dustin-lehmann/TWIPR/README.md

# TWIPR

See https://github.com/dustin-lehmann/TWIPR/wiki for descriptions on how to use the hardware and software
