dustin-lehmann/TWIPR/material/electronics/tools/robot-control_calculator.xlsx

Sheet: PWM Buzzer
PWM Calculator
Base Frequency | 16000000
Prescaler | 3
ARR | 40000 | 9089.91
PWM Frequency | 100.00 | 440

Sheet: WS2812
WS2812b Timer
Base Frequency | 16000000
ARR= | 20.00
30% Duty= | 6
70% Duty= | 14

Sheet: RegisterMap BoardExtender
Address | Name | R/W | Default | Column1 | Description
0x00
0x01
0x02
0x03
0x04
0x05 | COMMAND
0x06
0x07
0x08
0x09
0x0A
0x0B | CM4_MODE | R/W
0x0C | CM4_ENABLE | R/W | 0x00 |  | 0: disable CM4, 1: enable CM4
0x0D | OUT_5V_ENABLE | R/W
0x0E | DETECT_SD | R |  |  | 0: SD card not detected, 1: SD card present
0x0F | DETECT_USB | R |  |  | 0: USB not connected, 1: USB connected
0x10 | BUTTON_INTERN | R
0x11 | BUTTON_EXTERN | R
0x12 | V_POWER_0
0x13 | V_POWER_1
0x14 | V_POWER_2
0x15 | V_POWER_3
0x16 | V_REG_0
0x17 | V_REG_1
0x18 | V_REG_2
0x19 | V_REG_3
0x1A
0x1B
0x1C | ERROR_LED_CONFIG | R/W | 0x00 |  | 0: continious, 1: blinking
0x1D | ERROR_LED_DATA | R/W | 0x00 |  | 0: off, 1: on
0x1E | ERROR_LED_BLINKING_TIME | R/W | 0x00 |  | Value x 10ms = Actual blink time
0x1F | ERROR_LED_BLINK_COUNTER | R/W | 0x00 |  | Value = number of blink intervals
0x20 | STATUS_RGB_LED_1_CONFIG | R/W | 0x00 |  | Bits: 7 (power): 0=off, 1=on 6:5 (mode): 0=continiuous, 1=blinking, 2= fading, 3=reserved 4:3 (blink mode): 0=continiuous, 1=countdown, 2= reserved, 3=reserved 2:0 : reserved
0x21 | STATUS_RGB_LED_1_RED | R/W | 0x00 |  | 0x00: Lowest intensity 0xFF: Highest intensity
0x22 | STATUS_RGB_LED_1_GREEN | R/W | 0x00 |  | 0x00: Lowest intensity 0xFF: Highest intensity
0x23 | STATUS_RGB_LED_1_BLUE | R/W | 0x00 |  | 0x00: Lowest intensity 0xFF: Highest intensity
0x24 | STATUS_RGB_LED_1_BLINK_TIME | R/W | 0x00 |  | Value x 10ms = Actual blink time
0x25 | STATUS_RGB_LED_1_BLINK_COUNTER | R/W | 0x00 |  | Value = number of blink intervals
0x26 | STATUS_RGB_LED_2_CONFIG | R/W | 0x00 |  | Bits: 7 (power): 0=off, 1=on 6:5 (mode): 0=continiuous, 1=blinking, 2= fading, 3=reserved 4:3 (blink mode): 0=continiuous, 1=countdown, 2= reserved, 3=reserved 2:0 : reserved
0x27 | STATUS_RGB_LED_2_RED | R/W | 0x00 |  | 0x00: Lowest intensity 0xFF: Highest intensity
0x28 | STATUS_RGB_LED_2_GREEN | R/W | 0x00 |  | 0x00: Lowest intensity 0xFF: Highest intensity
0x29 | STATUS_RGB_LED_2_BLUE | R/W | 0x00 |  | 0x00: Lowest intensity 0xFF: Highest intensity
0x2A | STATUS_RGB_LED_2_BLINK_TIME | R/W | 0x00 |  | Value x 10ms = Actual blink time
0x2B | STATUS_RGB_LED_2_BLINK_COUNTER | R/W | 0x00 |  | Value = number of blink intervals
0x2C | STATUS_RGB_LED_3_CONFIG | R/W | 0x00 |  | Bits: 7 (power): 0=off, 1=on 6:5 (mode): 0=continiuous, 1=blinking, 2= fading, 3=reserved 4:3 (blink mode): 0=continiuous, 1=countdown, 2= reserved, 3=reserved 2:0 : reserved
0x2D | STATUS_RGB_LED_3_RED | R/W | 0x00 |  | 0x00: Lowest intensity 0xFF: Highest intensity
0x2E | STATUS_RGB_LED_3_GREEN | R/W | 0x00 |  | 0x00: Lowest intensity 0xFF: Highest intensity
0x2F | STATUS_RGB_LED_3_BLUE | R/W | 0x00 |  | 0x00: Lowest intensity 0xFF: Highest intensity
0x30 | STATUS_RGB_LED_3_BLINK_TIME | R/W | 0x00 |  | Value x 10ms = Actual blink time
0x31 | STATUS_RGB_LED_3_BLINK_COUNTER | R/W | 0x00 |  | Value = number of blink intervals
0x32
0x33 | BUZZER_CONFIG | R/W |  |  | Bits: 7 (enable): 0=disabled, 1=enabled 6:5 (mode): 0=continious, 1=timer, 2=blinking, 3=reserved
0x34 | BUZZER_DATA | R/W |  |  | 0=off, 1=on
0x35 | BUZZER_FREQUENCY | R/W |  |  | value x 10 = frequency in Hz
0x36 | BUZZER_TIMER | R/W |  |  | value x 10
0x37 | BUZZER_BLINK_TIME | R/W
0x38 | BUZZER_BLINK_COUNTER | R/W
0x39
0x3A
0x3B
0x3C
0x3D
0x3E
0x3F
0x40 | EXTERNAL_RGB_CONFIG | R/W |  |  | Bits: 7 (power): 0= off, 1=on 6 (individual mode): 0=global, 1=individual 5:4 (global mode): 0=continiuous, 1=blinking, 2= fading, 3=reserved 3:2 (blink mode): : 0=continiuous, 1=countdown, 2= reserved, 3=reserved
0x41 | EXTERNAL_RGB_GLOBAL_RED | R/W
0x42 | EXTERNAL_RGB_GLOBAL_GREEN | R/W
0x43 | EXTERNAL_RGB_GLOBAL_BLUE | R/W
0x44 | EXTERNAL_RGB_GLOBAL_BLINK_TIME | R/W
0x45 | EXTERNAL_RGB_GLOBAL_BLINK_COUNTER | R/W
0x46 | EXTERNAL_RGB_LED_1_CONFIG | R/W | 0x00 |  | Bits: 7 (power): 0=off, 1=on 6:5 (mode): 0=continiuous, 1=blinking, 2= fading, 3=reserved 4:3 (blink mode): 0=continiuous, 1=countdown, 2= reserved, 3=reserved 2:0 : reserved
0x47 | EXTERNAL_RGB_LED_1_RED | R/W | 0x00 |  | 0x00: Lowest intensity 0xFF: Highest intensity
0x48 | EXTERNAL_RGB_LED_1_GREEN | R/W | 0x00 |  | 0x00: Lowest intensity 0xFF: Highest intensity
0x49 | EXTERNAL_RGB_LED_1_BLUE | R/W | 0x00 |  | 0x00: Lowest intensity 0xFF: Highest intensity
0x4A | EXTERNAL_RGB_LED_1_BLINK_TIME | R/W | 0x00 |  | Value x 10ms = Actual blink time
0x4B | EXTERNAL_RGB_LED_1_BLINK_COUNTER | R/W | 0x00 |  | Value = number of blink intervals
0x4C | EXTERNAL_RGB_LED_2_CONFIG | R/W | 0x00 |  | Bits: 7 (power): 0=off, 1=on 6:5 (mode): 0=continiuous, 1=blinking, 2= fading, 3=reserved 4:3 (blink mode): 0=continiuous, 1=countdown, 2= reserved, 3=reserved 2:0 : reserved
0x4D | EXTERNAL_RGB_LED_2_RED | R/W | 0x00 |  | 0x00: Lowest intensity 0xFF: Highest intensity
0x4E | EXTERNAL_RGB_LED_2_GREEN | R/W | 0x00 |  | 0x00: Lowest intensity 0xFF: Highest intensity
0x4F | EXTERNAL_RGB_LED_2_BLUE | R/W | 0x00 |  | 0x00: Lowest intensity 0xFF: Highest intensity
0x50 | EXTERNAL_RGB_LED_2_BLINK_TIME | R/W | 0x00 |  | Value x 10ms = Actual blink time
0x51 | EXTERNAL_RGB_LED_2_BLINK_COUNTER | R/W | 0x00 |  | Value = number of blink intervals
0x52 | EXTERNAL_RGB_LED_3_CONFIG | R/W | 0x00 |  | Bits: 7 (power): 0=off, 1=on 6:5 (mode): 0=continiuous, 1=blinking, 2= fading, 3=reserved 4:3 (blink mode): 0=continiuous, 1=countdown, 2= reserved, 3=reserved 2:0 : reserved
0x53 | EXTERNAL_RGB_LED_3_RED | R/W | 0x00 |  | 0x00: Lowest intensity 0xFF: Highest intensity
0x54 | EXTERNAL_RGB_LED_3_GREEN | R/W | 0x00 |  | 0x00: Lowest intensity 0xFF: Highest intensity
0x55 | EXTERNAL_RGB_LED_3_BLUE | R/W | 0x00 |  | 0x00: Lowest intensity 0xFF: Highest intensity
0x56 | EXTERNAL_RGB_LED_3_BLINK_TIME | R/W | 0x00 |  | Value x 10ms = Actual blink time
0x57 | EXTERNAL_RGB_LED_3_BLINK_COUNTER | R/W | 0x00 |  | Value = number of blink intervals
0x58 | EXTERNAL_RGB_LED_4_CONFIG | R/W | 0x00 |  | Bits: 7 (power): 0=off, 1=on 6:5 (mode): 0=continiuous, 1=blinking, 2= fading, 3=reserved 4:3 (blink mode): 0=continiuous, 1=countdown, 2= reserved, 3=reserved 2:0 : reserved
0x59 | EXTERNAL_RGB_LED_4_RED | R/W | 0x00 |  | 0x00: Lowest intensity 0xFF: Highest intensity
0x5A | EXTERNAL_RGB_LED_4_GREEN | R/W | 0x00 |  | 0x00: Lowest intensity 0xFF: Highest intensity
0x5B | EXTERNAL_RGB_LED_4_BLUE | R/W | 0x00 |  | 0x00: Lowest intensity 0xFF: Highest intensity
0x5C | EXTERNAL_RGB_LED_4_BLINK_TIME | R/W | 0x00 |  | Value x 10ms = Actual blink time
0x5D | EXTERNAL_RGB_LED_4_BLINK_COUNTER | R/W | 0x00 |  | Value = number of blink intervals
0x5E | EXTERNAL_RGB_LED_5_CONFIG | R/W | 0x00 |  | Bits: 7 (power): 0=off, 1=on 6:5 (mode): 0=continiuous, 1=blinking, 2= fading, 3=reserved 4:3 (blink mode): 0=continiuous, 1=countdown, 2= reserved, 3=reserved 2:0 : reserved
0x5F | EXTERNAL_RGB_LED_5_RED | R/W | 0x00 |  | 0x00: Lowest intensity 0xFF: Highest intensity
0x60 | EXTERNAL_RGB_LED_5_GREEN | R/W | 0x00 |  | 0x00: Lowest intensity 0xFF: Highest intensity
0x61 | EXTERNAL_RGB_LED_5_BLUE | R/W | 0x00 |  | 0x00: Lowest intensity 0xFF: Highest intensity
0x62 | EXTERNAL_RGB_LED_5_BLINK_TIME | R/W | 0x00 |  | Value x 10ms = Actual blink time
0x63 | EXTERNAL_RGB_LED_5_BLINK_COUNTER | R/W | 0x00 |  | Value = number of blink intervals
0x64 | EXTERNAL_RGB_LED_6_CONFIG | R/W | 0x00 |  | Bits: 7 (power): 0=off, 1=on 6:5 (mode): 0=continiuous, 1=blinking, 2= fading, 3=reserved 4:3 (blink mode): 0=continiuous, 1=countdown, 2= reserved, 3=reserved 2:0 : reserved
0x65 | EXTERNAL_RGB_LED_6_RED | R/W | 0x00 |  | 0x00: Lowest intensity 0xFF: Highest intensity
0x66 | EXTERNAL_RGB_LED_6_GREEN | R/W | 0x00 |  | 0x00: Lowest intensity 0xFF: Highest intensity
0x67 | EXTERNAL_RGB_LED_6_BLUE | R/W | 0x00 |  | 0x00: Lowest intensity 0xFF: Highest intensity
0x68 | EXTERNAL_RGB_LED_6_BLINK_TIME | R/W | 0x00 |  | Value x 10ms = Actual blink time
0x69 | EXTERNAL_RGB_LED_6_BLINK_COUNTER | R/W | 0x00 |  | Value = number of blink intervals
0x6A | EXTERNAL_RGB_LED_7_CONFIG | R/W | 0x00 |  | Bits: 7 (power): 0=off, 1=on 6:5 (mode): 0=continiuous, 1=blinking, 2= fading, 3=reserved 4:3 (blink mode): 0=continiuous, 1=countdown, 2= reserved, 3=reserved 2:0 : reserved
0x6B | EXTERNAL_RGB_LED_7_RED | R/W | 0x00 |  | 0x00: Lowest intensity 0xFF: Highest intensity
0x6C | EXTERNAL_RGB_LED_7_GREEN | R/W | 0x00 |  | 0x00: Lowest intensity 0xFF: Highest intensity
0x6D | EXTERNAL_RGB_LED_7_BLUE | R/W | 0x00 |  | 0x00: Lowest intensity 0xFF: Highest intensity
0x6E | EXTERNAL_RGB_LED_7_BLINK_TIME | R/W | 0x00 |  | Value x 10ms = Actual blink time
0x6F | EXTERNAL_RGB_LED_7_BLINK_COUNTER | R/W | 0x00 |  | Value = number of blink intervals
0x70 | EXTERNAL_RGB_LED_8_CONFIG | R/W | 0x00 |  | Bits: 7 (power): 0=off, 1=on 6:5 (mode): 0=continiuous, 1=blinking, 2= fading, 3=reserved 4:3 (blink mode): 0=continiuous, 1=countdown, 2= reserved, 3=reserved 2:0 : reserved
0x71 | EXTERNAL_RGB_LED_8_RED | R/W | 0x00 |  | 0x00: Lowest intensity 0xFF: Highest intensity
0x72 | EXTERNAL_RGB_LED_8_GREEN | R/W | 0x00 |  | 0x00: Lowest intensity 0xFF: Highest intensity
0x73 | EXTERNAL_RGB_LED_8_BLUE | R/W | 0x00 |  | 0x00: Lowest intensity 0xFF: Highest intensity
0x74 | EXTERNAL_RGB_LED_8_BLINK_TIME | R/W | 0x00 |  | Value x 10ms = Actual blink time
0x75 | EXTERNAL_RGB_LED_8_BLINK_COUNTER | R/W | 0x00 |  | Value = number of blink intervals
0x76 | EXTERNAL_RGB_LED_9_CONFIG | R/W | 0x00 |  | Bits: 7 (power): 0=off, 1=on 6:5 (mode): 0=continiuous, 1=blinking, 2= fading, 3=reserved 4:3 (blink mode): 0=continiuous, 1=countdown, 2= reserved, 3=reserved 2:0 : reserved
0x77 | EXTERNAL_RGB_LED_9_RED | R/W | 0x00 |  | 0x00: Lowest intensity 0xFF: Highest intensity
0x78 | EXTERNAL_RGB_LED_9_GREEN | R/W | 0x00 |  | 0x00: Lowest intensity 0xFF: Highest intensity
0x79 | EXTERNAL_RGB_LED_9_BLUE | R/W | 0x00 |  | 0x00: Lowest intensity 0xFF: Highest intensity
0x7A | EXTERNAL_RGB_LED_9_BLINK_TIME | R/W | 0x00 |  | Value x 10ms = Actual blink time
0x7B | EXTERNAL_RGB_LED_9_BLINK_COUNTER | R/W | 0x00 |  | Value = number of blink intervals
0x7C | EXTERNAL_RGB_LED_10_CONFIG | R/W | 0x00 |  | Bits: 7 (power): 0=off, 1=on 6:5 (mode): 0=continiuous, 1=blinking, 2= fading, 3=reserved 4:3 (blink mode): 0=continiuous, 1=countdown, 2= reserved, 3=reserved 2:0 : reserved
0x7D | EXTERNAL_RGB_LED_10_RED | R/W | 0x00 |  | 0x00: Lowest intensity 0xFF: Highest intensity
0x7E | EXTERNAL_RGB_LED_10_GREEN | R/W | 0x00 |  | 0x00: Lowest intensity 0xFF: Highest intensity
0x7F | EXTERNAL_RGB_LED_10_BLUE | R/W | 0x00 |  | 0x00: Lowest intensity 0xFF: Highest intensity
0x80 | EXTERNAL_RGB_LED_10_BLINK_TIME | R/W | 0x00 |  | Value x 10ms = Actual blink time
0x81 | EXTERNAL_RGB_LED_10_BLINK_COUNTER | R/W | 0x00 |  | Value = number of blink intervals
0x82 | EXTERNAL_RGB_LED_11_CONFIG | R/W | 0x00 |  | Bits: 7 (power): 0=off, 1=on 6:5 (mode): 0=continiuous, 1=blinking, 2= fading, 3=reserved 4:3 (blink mode): 0=continiuous, 1=countdown, 2= reserved, 3=reserved 2:0 : reserved
0x83 | EXTERNAL_RGB_LED_11_RED | R/W | 0x00 |  | 0x00: Lowest intensity 0xFF: Highest intensity
0x84 | EXTERNAL_RGB_LED_11_GREEN | R/W | 0x00 |  | 0x00: Lowest intensity 0xFF: Highest intensity
0x85 | EXTERNAL_RGB_LED_11_BLUE | R/W | 0x00 |  | 0x00: Lowest intensity 0xFF: Highest intensity
0x86 | EXTERNAL_RGB_LED_11_BLINK_TIME | R/W | 0x00 |  | Value x 10ms = Actual blink time
0x87 | EXTERNAL_RGB_LED_11_BLINK_COUNTER | R/W | 0x00 |  | Value = number of blink intervals
0x88 | EXTERNAL_RGB_LED_12_CONFIG | R/W | 0x00 |  | Bits: 7 (power): 0=off, 1=on 6:5 (mode): 0=continiuous, 1=blinking, 2= fading, 3=reserved 4:3 (blink mode): 0=continiuous, 1=countdown, 2= reserved, 3=reserved 2:0 : reserved
0x89 | EXTERNAL_RGB_LED_12_RED | R/W | 0x00 |  | 0x00: Lowest intensity 0xFF: Highest intensity
0x8A | EXTERNAL_RGB_LED_12_GREEN | R/W | 0x00 |  | 0x00: Lowest intensity 0xFF: Highest intensity
0x8B | EXTERNAL_RGB_LED_12_BLUE | R/W | 0x00 |  | 0x00: Lowest intensity 0xFF: Highest intensity
0x8C | EXTERNAL_RGB_LED_12_BLINK_TIME | R/W | 0x00 |  | Value x 10ms = Actual blink time
0x8D | EXTERNAL_RGB_LED_12_BLINK_COUNTER | R/W | 0x00 |  | Value = number of blink intervals
0x8E | EXTERNAL_RGB_LED_13_CONFIG | R/W | 0x00 |  | Bits: 7 (power): 0=off, 1=on 6:5 (mode): 0=continiuous, 1=blinking, 2= fading, 3=reserved 4:3 (blink mode): 0=continiuous, 1=countdown, 2= reserved, 3=reserved 2:0 : reserved
0x8F | EXTERNAL_RGB_LED_13_RED | R/W | 0x00 |  | 0x00: Lowest intensity 0xFF: Highest intensity
0x90 | EXTERNAL_RGB_LED_13_GREEN | R/W | 0x00 |  | 0x00: Lowest intensity 0xFF: Highest intensity
0x91 | EXTERNAL_RGB_LED_13_BLUE | R/W | 0x00 |  | 0x00: Lowest intensity 0xFF: Highest intensity
0x92 | EXTERNAL_RGB_LED_13_BLINK_TIME | R/W | 0x00 |  | Value x 10ms = Actual blink time
0x93 | EXTERNAL_RGB_LED_13_BLINK_COUNTER | R/W | 0x00 |  | Value = number of blink intervals
0x94 | EXTERNAL_RGB_LED_14_CONFIG | R/W | 0x00 |  | Bits: 7 (power): 0=off, 1=on 6:5 (mode): 0=continiuous, 1=blinking, 2= fading, 3=reserved 4:3 (blink mode): 0=continiuous, 1=countdown, 2= reserved, 3=reserved 2:0 : reserved
0x95 | EXTERNAL_RGB_LED_14_RED | R/W | 0x00 |  | 0x00: Lowest intensity 0xFF: Highest intensity
0x96 | EXTERNAL_RGB_LED_14_GREEN | R/W | 0x00 |  | 0x00: Lowest intensity 0xFF: Highest intensity
0x97 | EXTERNAL_RGB_LED_14_BLUE | R/W | 0x00 |  | 0x00: Lowest intensity 0xFF: Highest intensity
0x98 | EXTERNAL_RGB_LED_14_BLINK_TIME | R/W | 0x00 |  | Value x 10ms = Actual blink time
0x99 | EXTERNAL_RGB_LED_14_BLINK_COUNTER | R/W | 0x00 |  | Value = number of blink intervals
0x9A | EXTERNAL_RGB_LED_15_CONFIG | R/W | 0x00 |  | Bits: 7 (power): 0=off, 1=on 6:5 (mode): 0=continiuous, 1=blinking, 2= fading, 3=reserved 4:3 (blink mode): 0=continiuous, 1=countdown, 2= reserved, 3=reserved 2:0 : reserved
0x9B | EXTERNAL_RGB_LED_15_RED | R/W | 0x00 |  | 0x00: Lowest intensity 0xFF: Highest intensity
0x9C | EXTERNAL_RGB_LED_15_GREEN | R/W | 0x00 |  | 0x00: Lowest intensity 0xFF: Highest intensity
0x9D | EXTERNAL_RGB_LED_15_BLUE | R/W | 0x00 |  | 0x00: Lowest intensity 0xFF: Highest intensity
0x9E | EXTERNAL_RGB_LED_15_BLINK_TIME | R/W | 0x00 |  | Value x 10ms = Actual blink time
0x9F | EXTERNAL_RGB_LED_15_BLINK_COUNTER | R/W | 0x00 |  | Value = number of blink intervals
0xA0 | EXTERNAL_RGB_LED_16_CONFIG | R/W | 0x00 |  | Bits: 7 (power): 0=off, 1=on 6:5 (mode): 0=continiuous, 1=blinking, 2= fading, 3=reserved 4:3 (blink mode): 0=continiuous, 1=countdown, 2= reserved, 3=reserved 2:0 : reserved
0xA1 | EXTERNAL_RGB_LED_16_RED | R/W | 0x00 |  | 0x00: Lowest intensity 0xFF: Highest intensity
0xA2 | EXTERNAL_RGB_LED_16_GREEN | R/W | 0x00 |  | 0x00: Lowest intensity 0xFF: Highest intensity
0xA3 | EXTERNAL_RGB_LED_16_BLUE | R/W | 0x00 |  | 0x00: Lowest intensity 0xFF: Highest intensity
0xA4 | EXTERNAL_RGB_LED_16_BLINK_TIME | R/W | 0x00 |  | Value x 10ms = Actual blink time
0xA5 | EXTERNAL_RGB_LED_16_BLINK_COUNTER | R/W | 0x00 |  | Value = number of blink intervals
0xA6
0xA7
0xA8
0xA9
0xAA
0xAB
0xAC
0xAD
0xAE
0xAF
0xB0
0xB1
0xB2
0xB3
0xB4
0xB5
0xB6
0xB7
0xB8
0xB9
0xBA
0xBB

Sheet: S-8254AA
Maximum Current | 25
VIOV1 | 0.1
R_SENSE | 0.004
Power for Resistor | 2.5

Sheet: Sheet1
Code | Error
0 | 0
1 | 1
2 | 0
3 | 1
4 | 0
5 | 0
6 | 0
7 | 1
8 | 0
9 | 1
10 | 0
11 | 1
12 | 0
13 | 0
14 | 0
15 | 1
16 | 0
17 | 1
18 | 0
19 | 1
20 | 0
21 | 1
22 | 0
23 | 1
24 | 0
25 | 1
26 | 0
27 | 1
28 | 0
29 | 0
30 | 0
31 | 1
32 | 0
33 | 1
34 | 0
35 | 1
36 | 0
37 | 0
38 | 0
39 | 1
40 | 0
41 | 1
42
43
44
45
46
47
48
49
50
51
52
53
54
55
56
57
58
59
60
61
62
63
64
65
66
67
68
69
70
71
72
73
74
75
76
77
78
79
80
81
82
83
84
85
86
87
88
89
90
91
92
93
94
95
96
97
98
99
100
