dustin-lehmann/TWIPR/software/host/RobotManager/extensions/babylon/babylon_lib/models/diff_drive_robot/design/robot_base.SLDASM

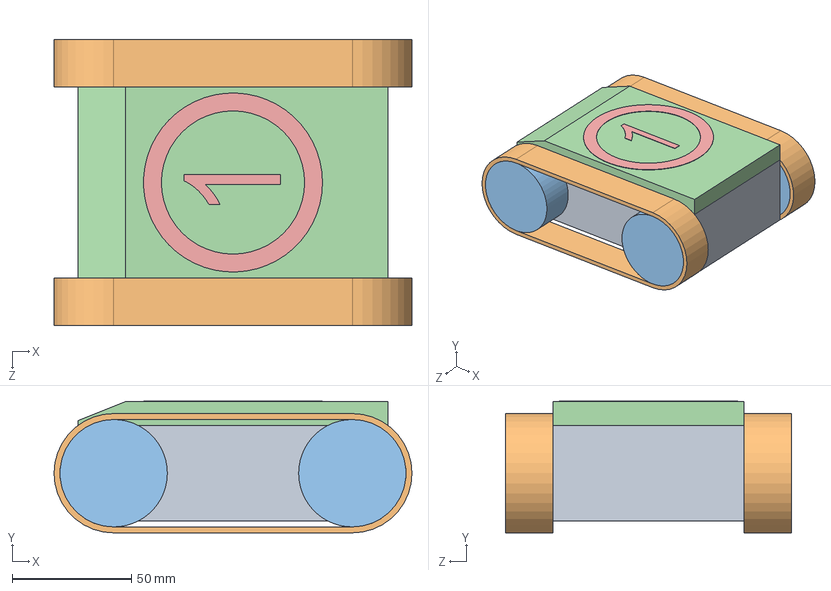
[picture p3: CAD file, 2024-07-12]
software/host/RobotManager/extensions/babylon/babylon_lib/models/diff_drive_robot/design/robot_base.SLDASM
150.0 x 55.2 x 120.0 mm
track x 2
wheel x 4
top
Part1^robot_base
