dustin-lehmann/TWIPR/hardware/v1_HHI/common_parts/bearing_8x12x3/SKF_W_637_8_2Z.sldasm

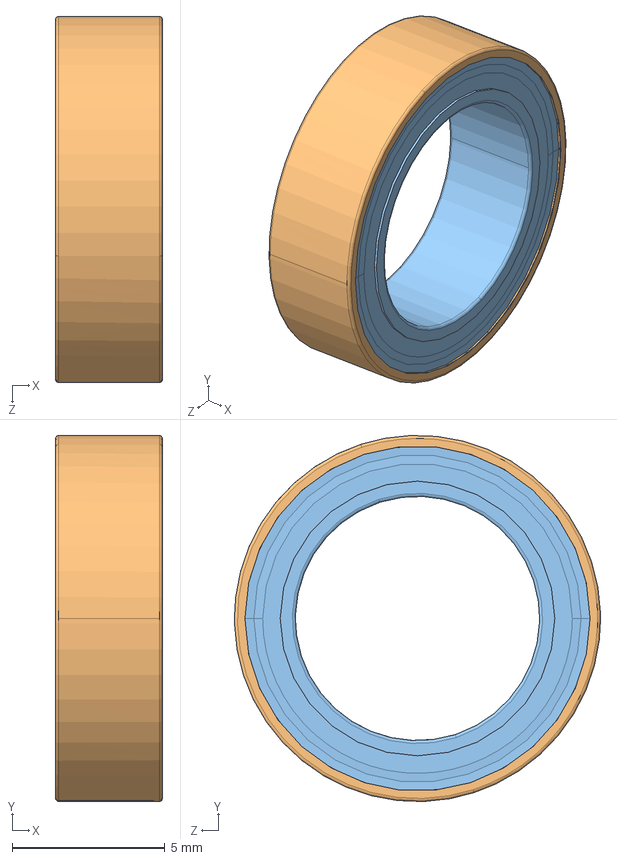
[picture p4: CAD file, 2024-02-12]
hardware/v1_HHI/common_parts/bearing_8x12x3/SKF_W_637_8_2Z.sldasm
3.50 x 12.0 x 12.0 mm
SKF_W_637_8_2Z_16 x 12
SKF_W_637_8_2Z_29
SKF_W_637_8_2Z_31
