dustin-lehmann/TWIPR/hardware/covers/conver_front.DXF

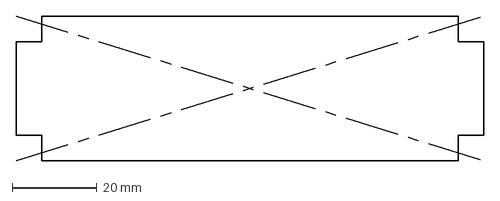
[picture p5: CAD file, 2024-05-09]
hardware/covers/conver_front.DXF
110.0 x 34.0 mm
