dustin-lehmann/TWIPR/hardware/v1_HHI/common_parts/banebots_rmd4015_hub/banebots_rmd4015_hub.SLDPRT

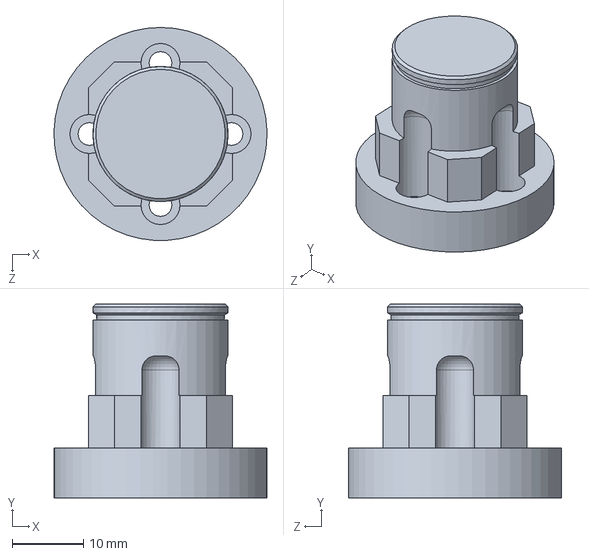
[picture p6: CAD file, 2024-02-12]
hardware/v1_HHI/common_parts/banebots_rmd4015_hub/banebots_rmd4015_hub.SLDPRT
30.0 x 27.3 x 30.0 mm
