dustin-lehmann/TWIPR/hardware/v1_HHI/common_parts/bearing_8x12x3/bearing_8x12x25.SLDPRT

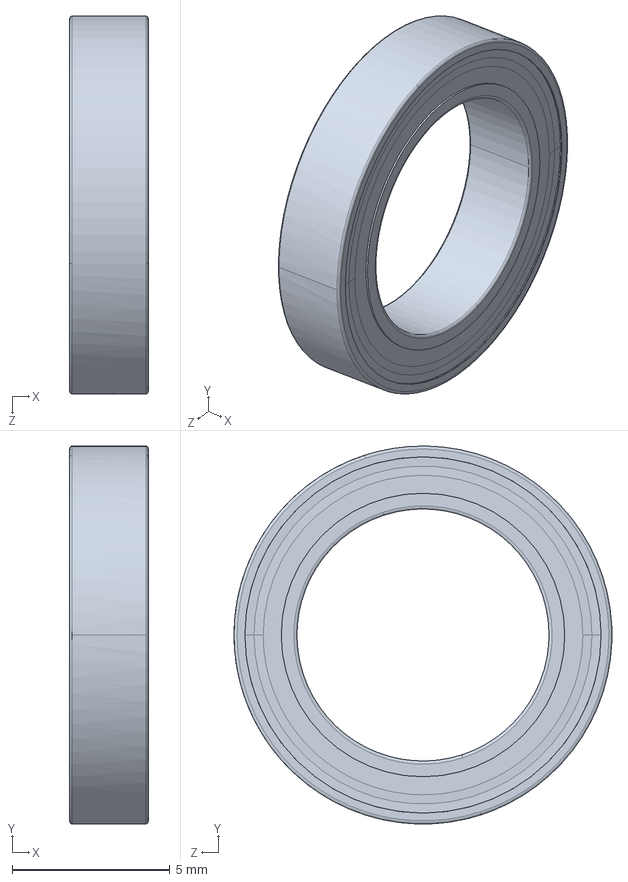
[picture p7: CAD file, 2024-02-12]
hardware/v1_HHI/common_parts/bearing_8x12x3/bearing_8x12x25.SLDPRT
2.50 x 12.0 x 12.0 mm
