dustin-lehmann/TWIPR/hardware/v1_HHI/common_parts/MC-4-15.STEP

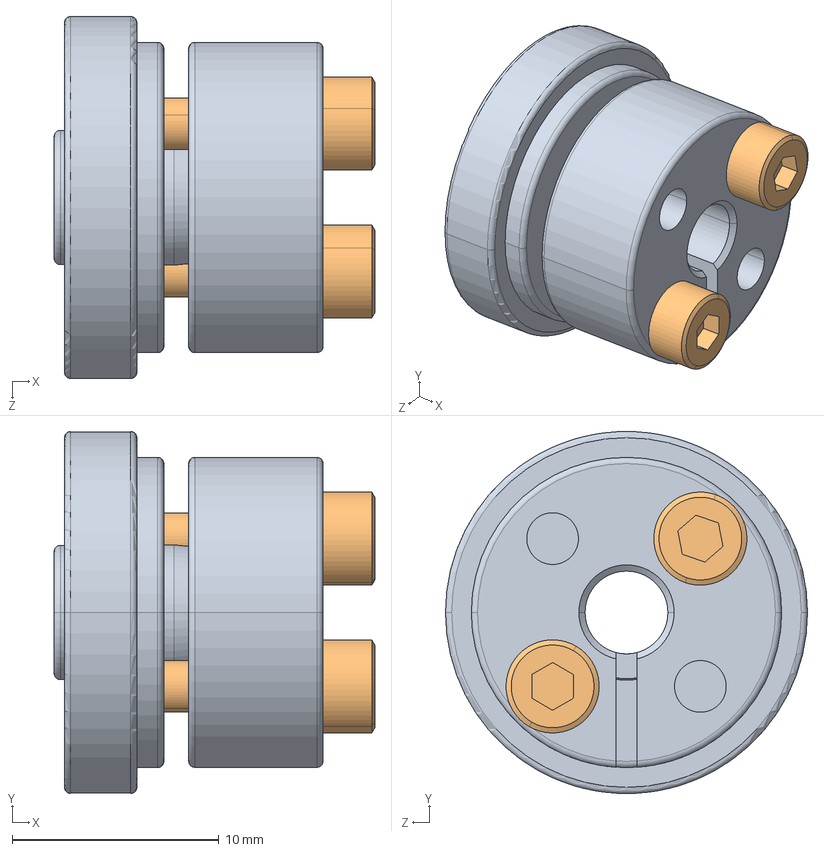
[picture p8: CAD file, 2024-02-12]
hardware/v1_HHI/common_parts/MC-4-15.STEP
15.5 x 17.5 x 17.5 mm
