dustin-lehmann/TWIPR/hardware/v1_HHI/common_parts/motors/RMD-4015.SLDPRT

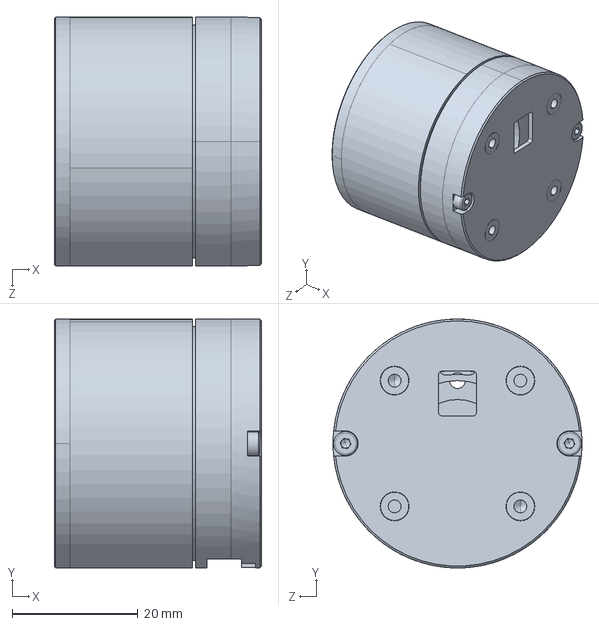
[picture p9: CAD file, 2024-02-12]
hardware/v1_HHI/common_parts/motors/RMD-4015.SLDPRT
33.0 x 39.6 x 39.6 mm
