dustin-lehmann/TWIPR/hardware/v1_HHI/common_parts/PCB/logic_pcb_1.SLDPRT

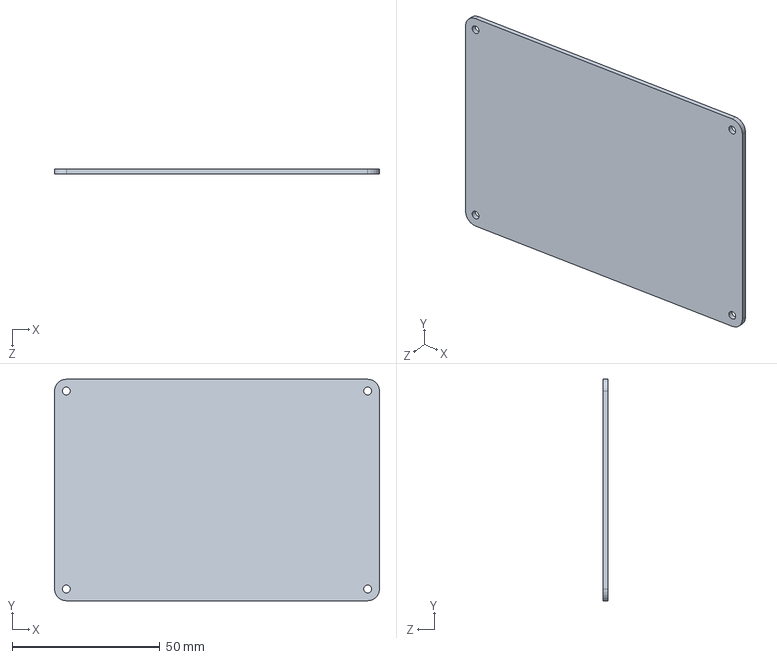
[picture p10: CAD file, 2024-02-12]
hardware/v1_HHI/common_parts/PCB/logic_pcb_1.SLDPRT
110.0 x 75.0 x 1.60 mm
