dustin-lehmann/TWIPR/hardware/v1_HHI/common_parts/SC020B_CAD_01a/T81H-RM41.stp.SLDPRT

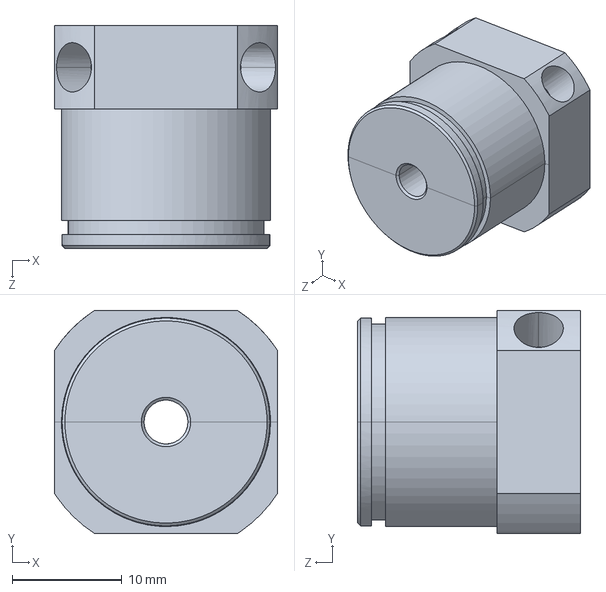
[picture p11: CAD file, 2024-02-12]
hardware/v1_HHI/common_parts/SC020B_CAD_01a/T81H-RM41.stp.SLDPRT
20.3 x 20.3 x 20.3 mm
