dustin-lehmann/TWIPR/hardware/v1_HHI/common_parts/wheels/banebots_4_78.SLDPRT

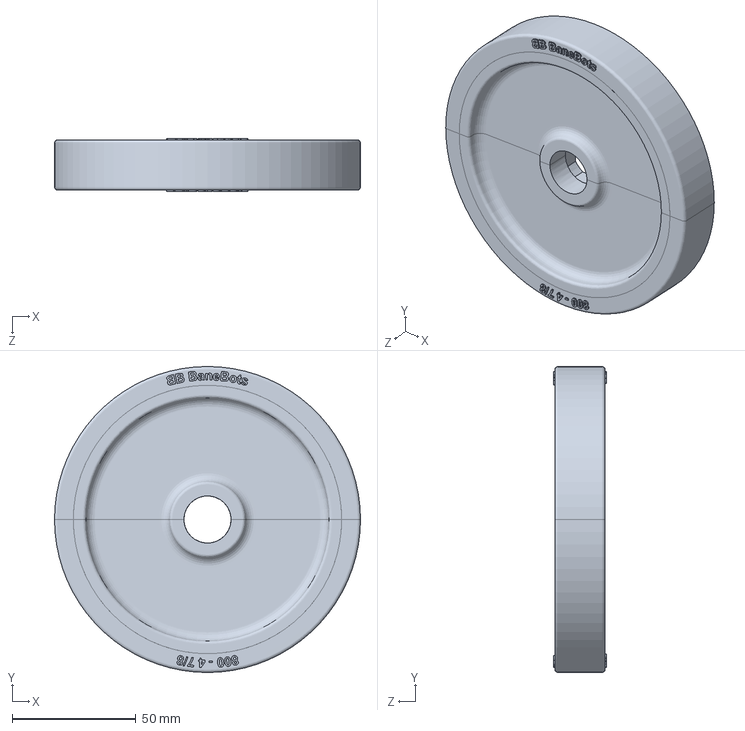
[picture p12: CAD file, 2024-02-12]
hardware/v1_HHI/common_parts/wheels/banebots_4_78.SLDPRT
123.8 x 123.8 x 21.3 mm
