dustin-lehmann/TWIPR/hardware/v1_HHI/parts/v1_hhi_marker_top.SLDPRT

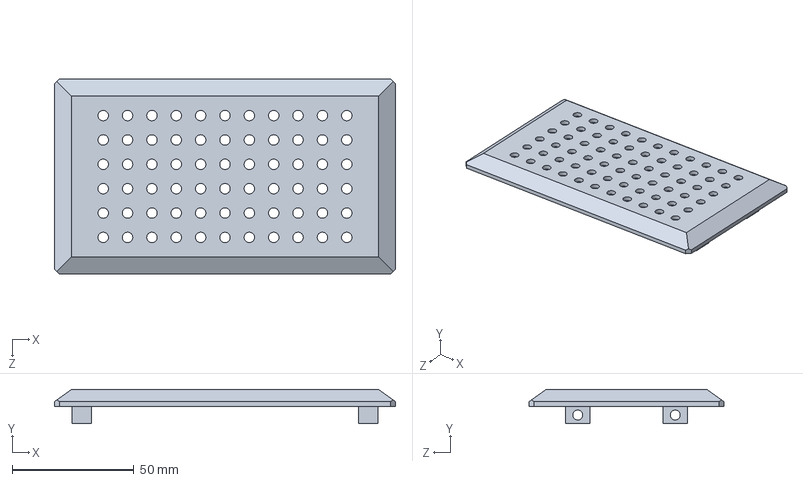
[picture p13: CAD file, 2024-07-12]
hardware/v1_HHI/parts/v1_hhi_marker_top.SLDPRT
140.0 x 14.0 x 80.0 mm
