dustin-lehmann/TWIPR/hardware/v2/common_parts/distance_led_board_long.SLDPRT

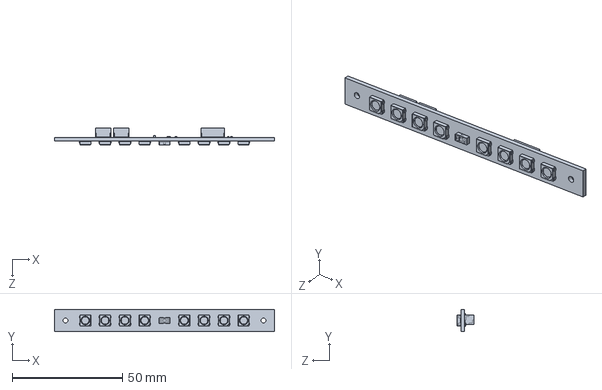
[picture p14: CAD file, 2024-05-30]
hardware/v2/common_parts/distance_led_board_long.SLDPRT
100.0 x 10.0 x 7.50 mm
