dustin-lehmann/TWIPR/hardware/v2/parts/v2_bat_compartment_lid.SLDPRT

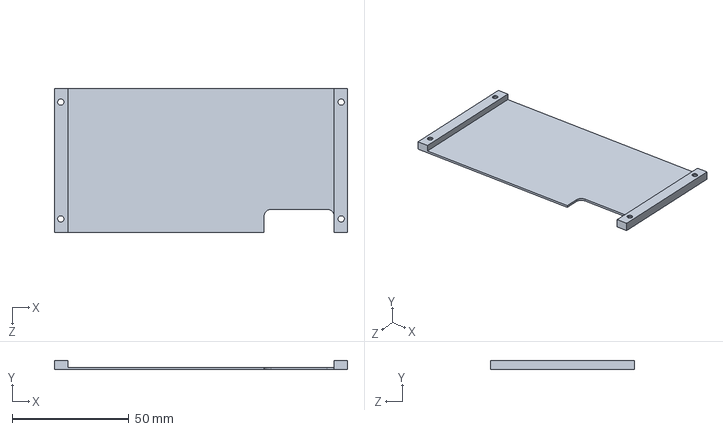
[picture p15: CAD file, 2024-07-05]
hardware/v2/parts/v2_bat_compartment_lid.SLDPRT
125.4 x 4.00 x 61.8 mm
