dustin-lehmann/TWIPR/software/host/RobotManager/extensions/gui/babylon_dummy/babylon/babylon_lib/models/diff_drive_robot/design/track.SLDPRT

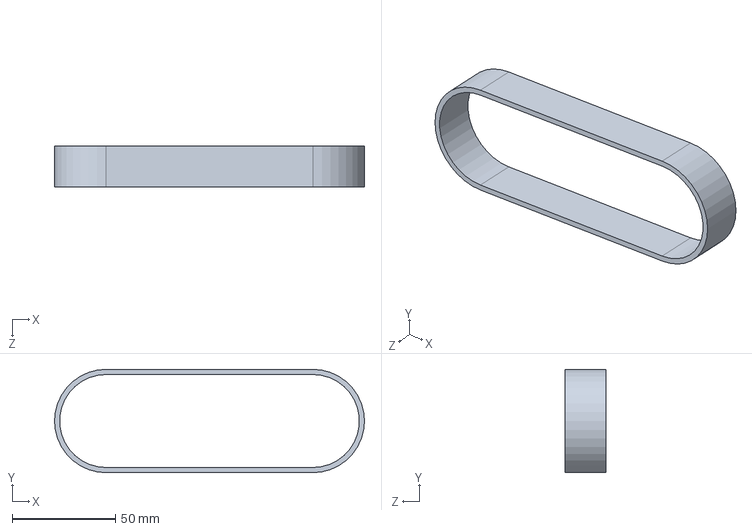
[picture p16: CAD file, 2024-07-12]
software/host/RobotManager/extensions/gui/babylon_dummy/babylon/babylon_lib/models/diff_drive_robot/design/track.SLDPRT
150.0 x 50.0 x 20.0 mm
