dustin-lehmann/TWIPR/hardware/v1_HHI/common_parts/bearing_8x12x3/SKF_W_637_8_2Z_31.sldprt

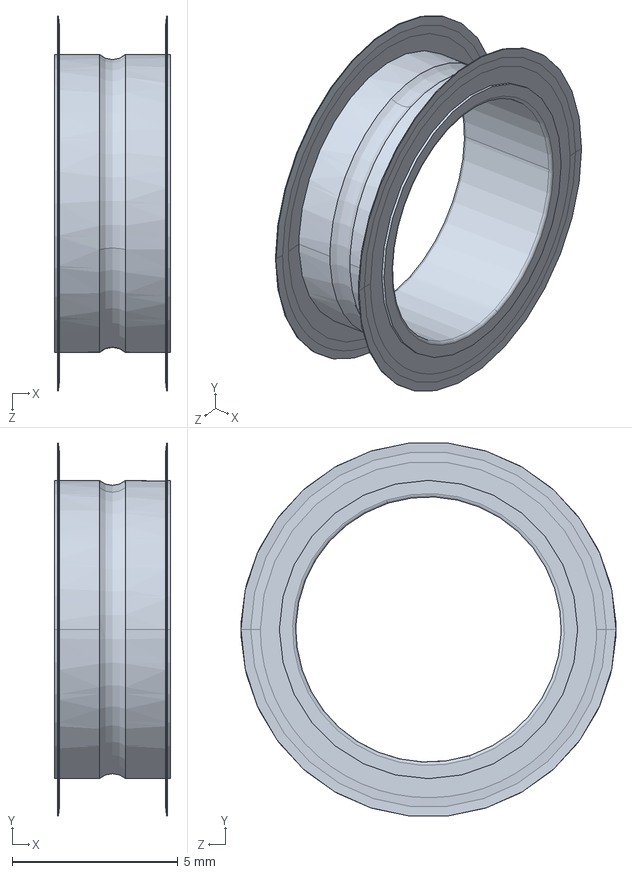
[picture p17: CAD file, 2024-02-12]
hardware/v1_HHI/common_parts/bearing_8x12x3/SKF_W_637_8_2Z_31.sldprt
3.50 x 11.3 x 11.3 mm
