dustin-lehmann/TWIPR/hardware/v1_HHI/common_parts/PCB/power_pcb_1.SLDPRT

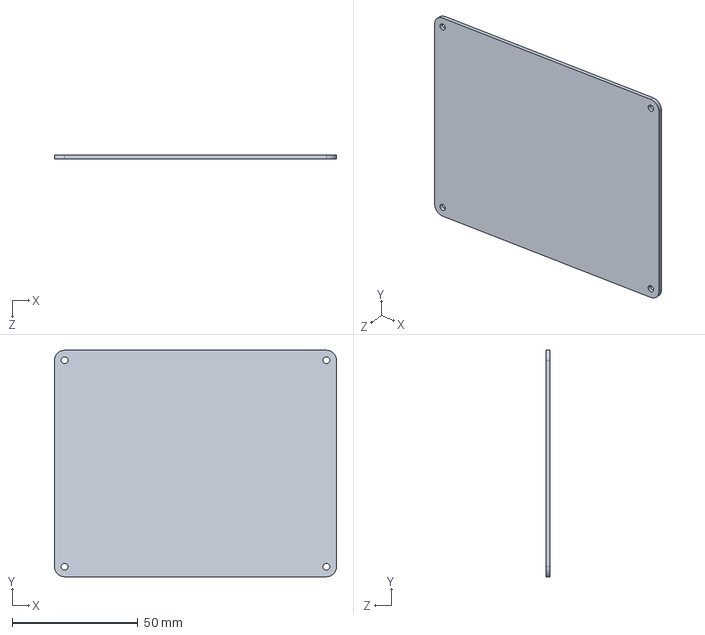
[picture p18: CAD file, 2024-02-12]
hardware/v1_HHI/common_parts/PCB/power_pcb_1.SLDPRT
112.0 x 90.0 x 1.60 mm
