dustin-lehmann/TWIPR/hardware/v1_HHI/parts/v1_brace_right.SLDPRT

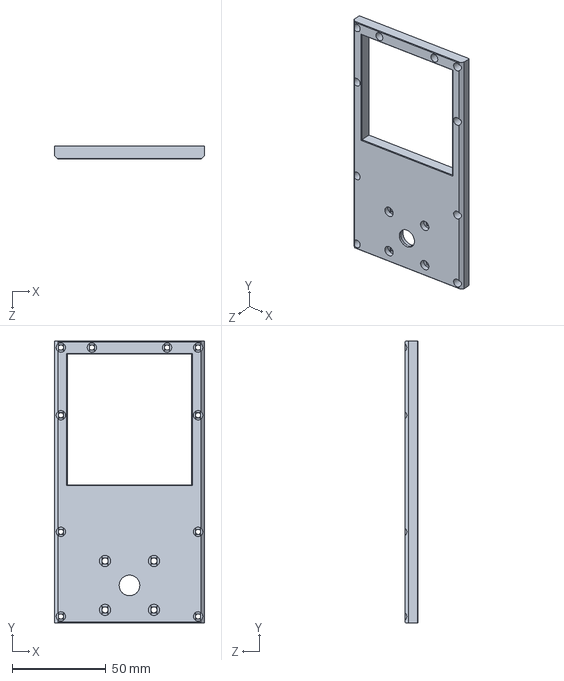
[picture p19: CAD file, 2024-05-30]
hardware/v1_HHI/parts/v1_brace_right.SLDPRT
80.0 x 150.0 x 7.00 mm
