dustin-lehmann/TWIPR/hardware/v2/common_parts/RS485-Splitter.SLDPRT

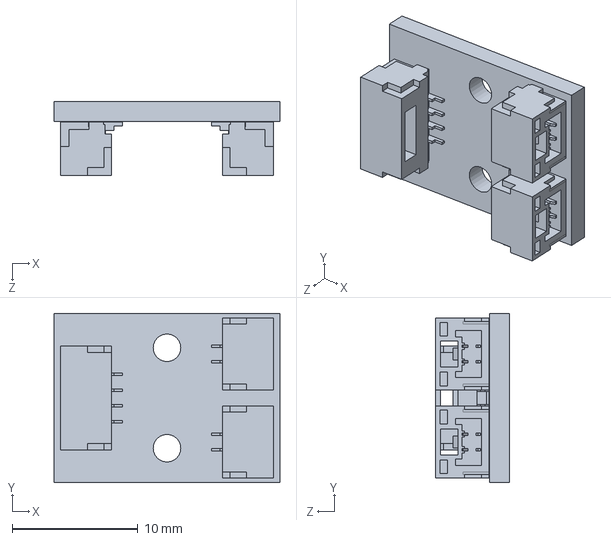
[picture p20: CAD file, 2024-05-30]
hardware/v2/common_parts/RS485-Splitter.SLDPRT
18.0 x 13.5 x 5.89 mm
