dustin-lehmann/TWIPR/hardware/v2/parts/v2_cover_2.SLDPRT

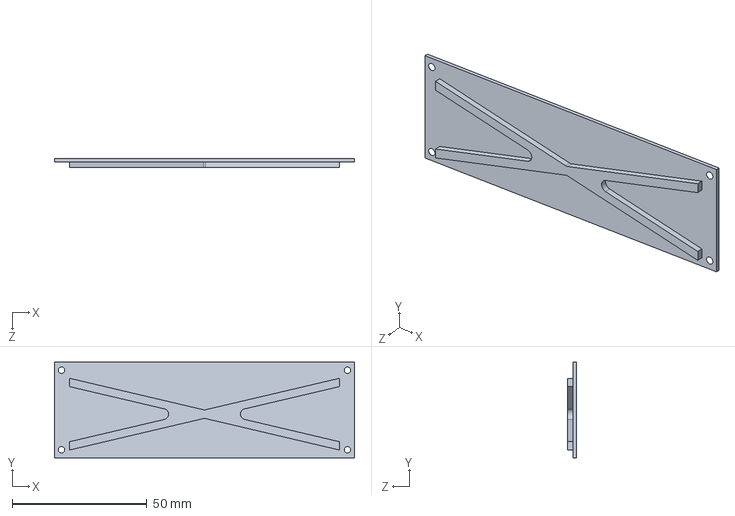
[picture p21: CAD file, 2024-07-05]
hardware/v2/parts/v2_cover_2.SLDPRT
111.2 x 35.5 x 3.20 mm
