dustin-lehmann/TWIPR/software/host/RobotManager/extensions/babylon/babylon_lib/models/diff_drive_robot/design/top.SLDPRT

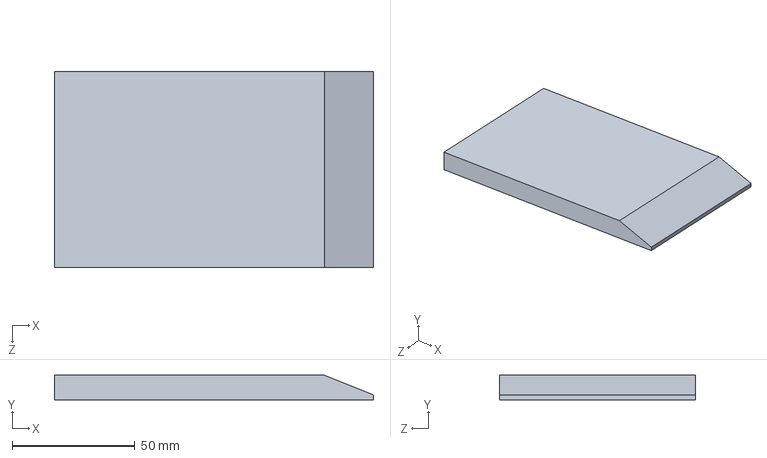
[picture p22: CAD file, 2024-07-12]
software/host/RobotManager/extensions/babylon/babylon_lib/models/diff_drive_robot/design/top.SLDPRT
130.0 x 10.0 x 80.0 mm
