dustin-lehmann/TWIPR/software/host/RobotManager/extensions/gui/babylon_dummy/babylon/babylon_lib/models/diff_drive_robot/design/wheel.SLDPRT

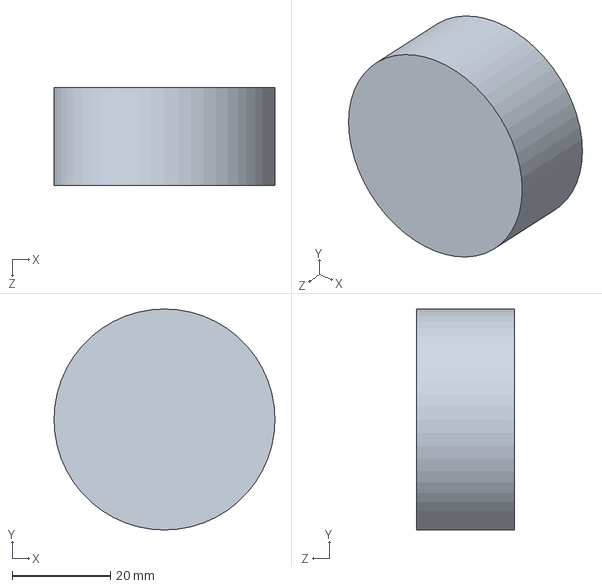
[picture p23: CAD file, 2024-07-12]
software/host/RobotManager/extensions/gui/babylon_dummy/babylon/babylon_lib/models/diff_drive_robot/design/wheel.SLDPRT
45.0 x 45.0 x 20.0 mm
