dustin-lehmann/TWIPR/hardware/v1_HHI/parts/v1_brace_left_display.SLDPRT

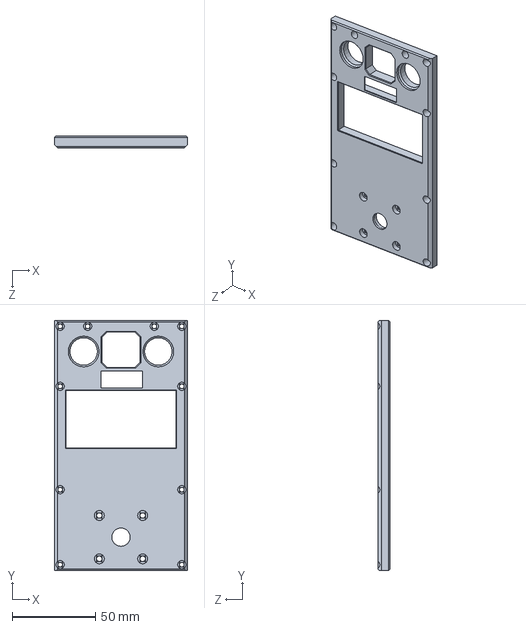
[picture p24: CAD file, 2024-05-16]
hardware/v1_HHI/parts/v1_brace_left_display.SLDPRT
80.0 x 150.0 x 7.00 mm
