dustin-lehmann/TWIPR/hardware/v1_HHI/common_parts/bearing_8x12x3/SKF_W_637_8_2Z_29.sldprt

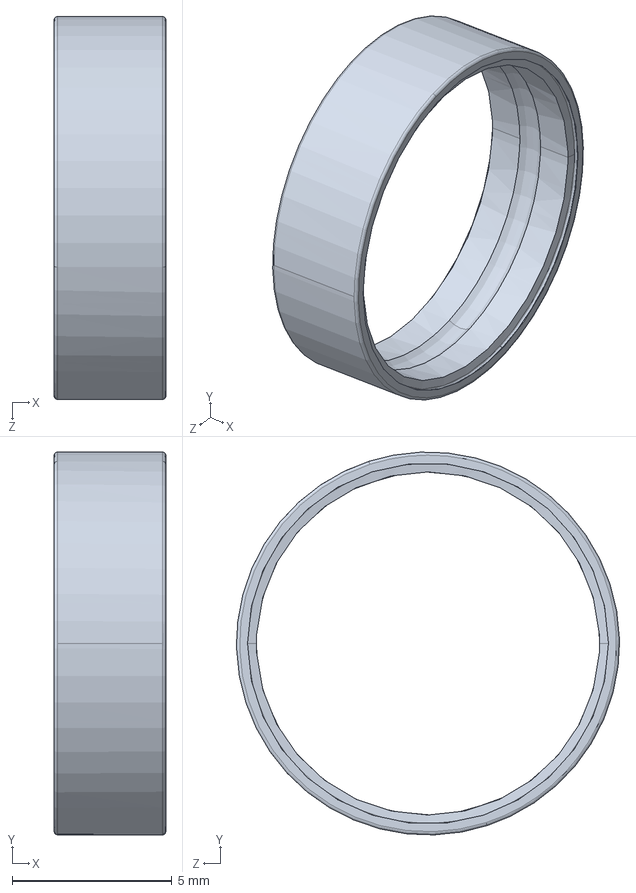
[picture p26: CAD file, 2024-02-12]
hardware/v1_HHI/common_parts/bearing_8x12x3/SKF_W_637_8_2Z_29.sldprt
3.50 x 12.0 x 12.0 mm
