dustin-lehmann/TWIPR/hardware/v1_HHI/parts/v1_brace_back.SLDPRT

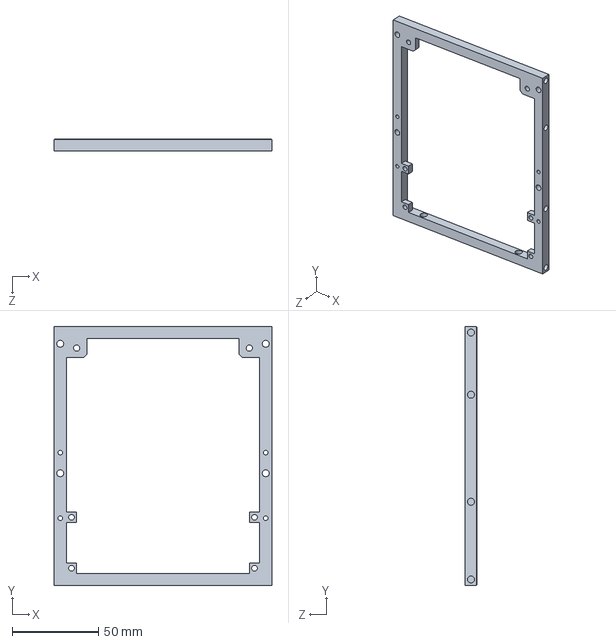
[picture p27: CAD file, 2024-05-15]
hardware/v1_HHI/parts/v1_brace_back.SLDPRT
126.0 x 150.0 x 7.00 mm
