dustin-lehmann/TWIPR/hardware/v2/parts/v2_cover_front.SLDPRT

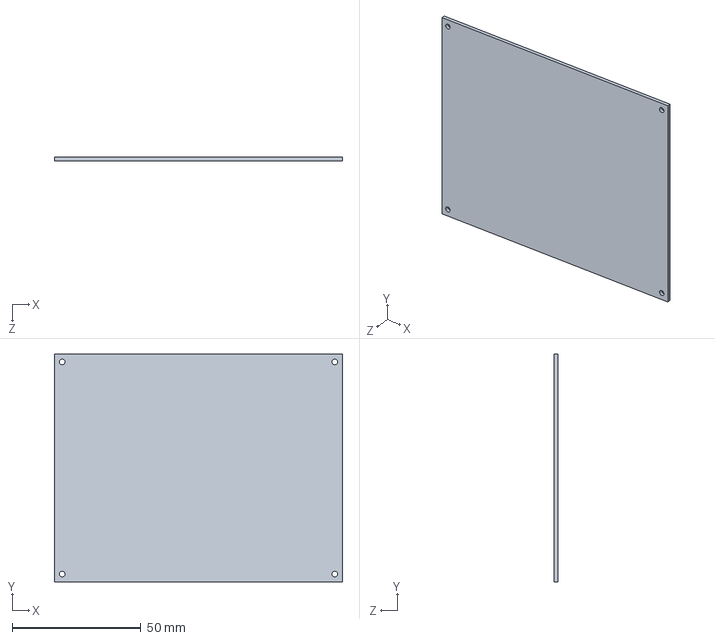
[picture p28: CAD file, 2024-07-05]
hardware/v2/parts/v2_cover_front.SLDPRT
112.0 x 88.5 x 1.50 mm
