dustin-lehmann/TWIPR/hardware/v1_HHI/common_parts/bearing_8x12x3/SKF_W_637_8_2Z_16.sldprt

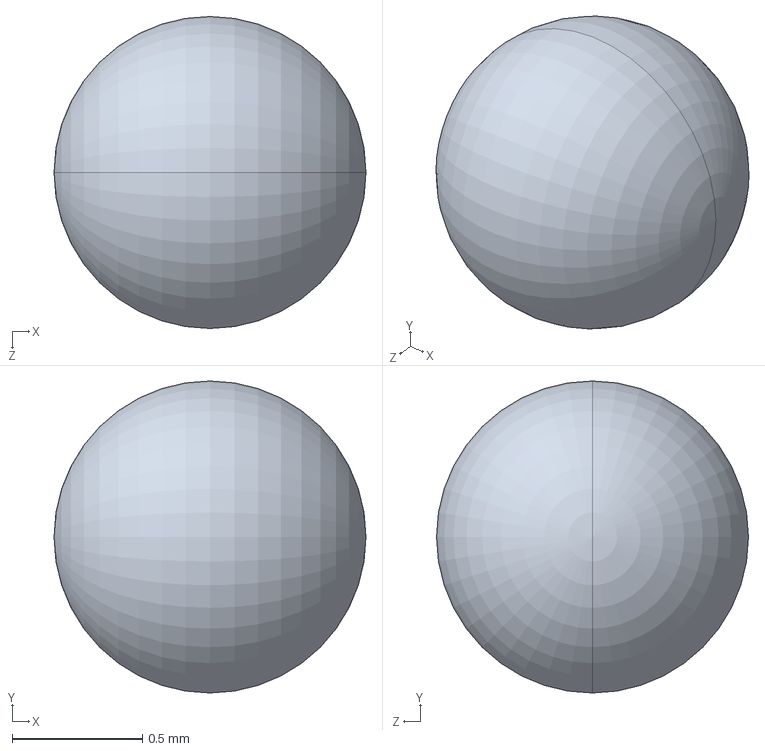
[picture p29: CAD file, 2024-02-12]
hardware/v1_HHI/common_parts/bearing_8x12x3/SKF_W_637_8_2Z_16.sldprt
1.20 x 1.20 x 1.20 mm
