dustin-lehmann/TWIPR/hardware/v2/parts/v2_bat_compartment.SLDPRT

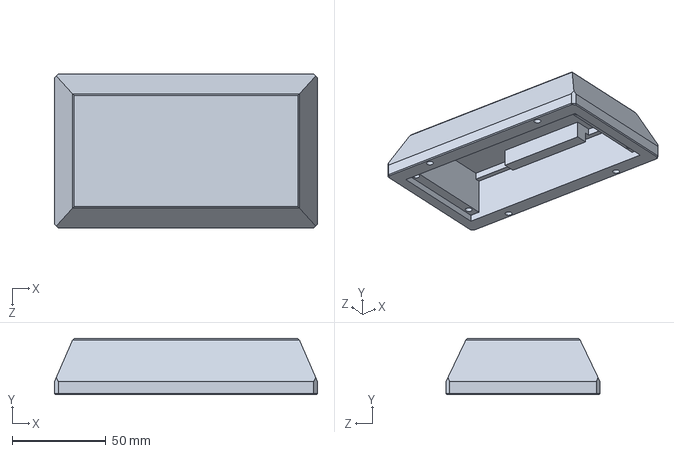
[picture p30: CAD file, 2024-07-05]
hardware/v2/parts/v2_bat_compartment.SLDPRT
140.0 x 30.0 x 82.0 mm
