dustin-lehmann/TWIPR/software/host/RobotManager/extensions/babylon/babylon_lib/models/diff_drive_robot/design/body.SLDPRT

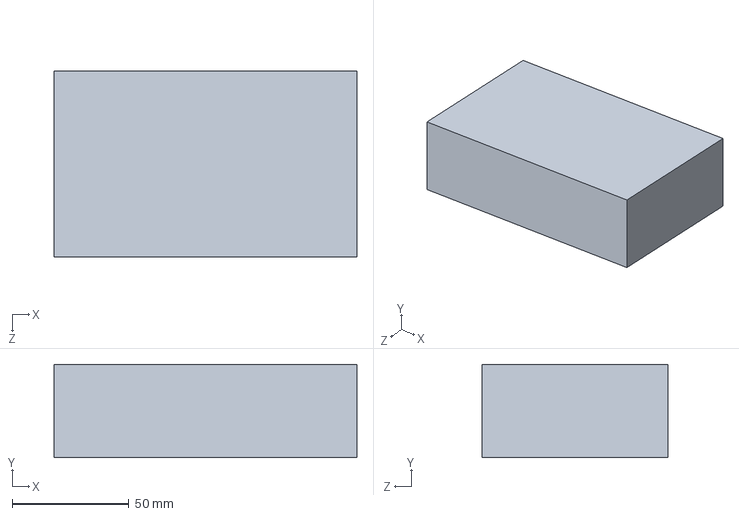
[picture p31: CAD file, 2024-07-12]
software/host/RobotManager/extensions/babylon/babylon_lib/models/diff_drive_robot/design/body.SLDPRT
130.0 x 40.0 x 80.0 mm
