dustin-lehmann/TWIPR/hardware/v1_HHI/parts/v1_bat_compartment.SLDPRT

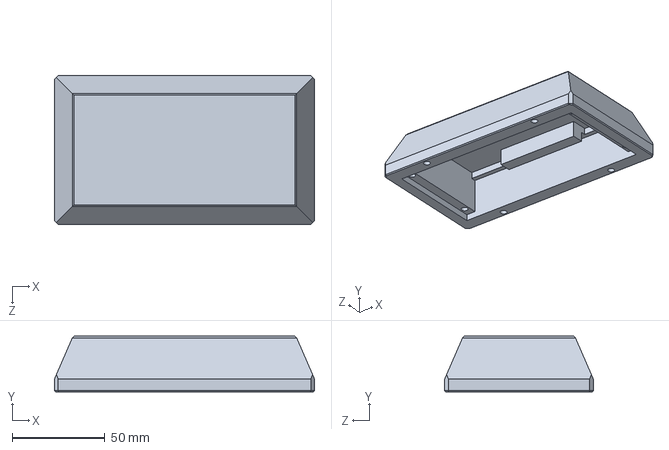
[picture p32: CAD file, 2024-05-15]
hardware/v1_HHI/parts/v1_bat_compartment.SLDPRT
140.0 x 30.0 x 80.0 mm
