dustin-lehmann/TWIPR/hardware/v1_HHI/parts/v1_cover_1.SLDPRT

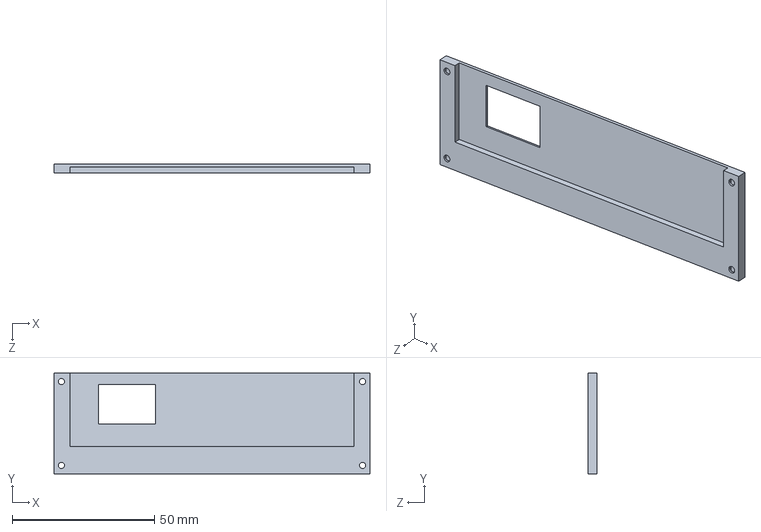
[picture p34: CAD file, 2024-05-15]
hardware/v1_HHI/parts/v1_cover_1.SLDPRT
111.2 x 35.5 x 3.00 mm
