dustin-lehmann/TWIPR/hardware/v2/parts/v2_brace_left_display.SLDPRT

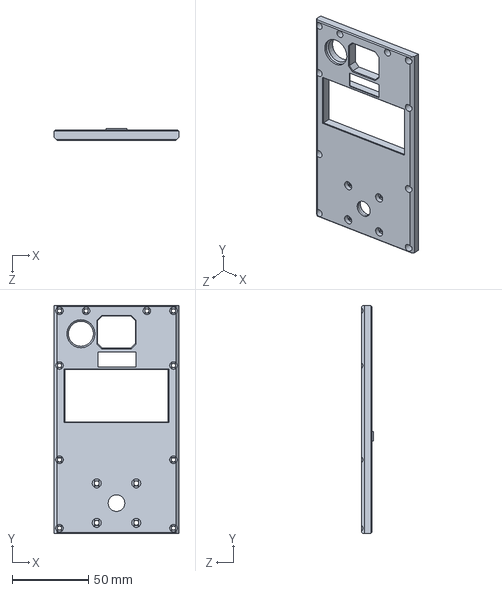
[picture p35: CAD file, 2024-07-05]
hardware/v2/parts/v2_brace_left_display.SLDPRT
82.0 x 150.0 x 8.00 mm
