dustin-lehmann/TWIPR/hardware/v1_HHI/parts/v1_cover_2.SLDPRT

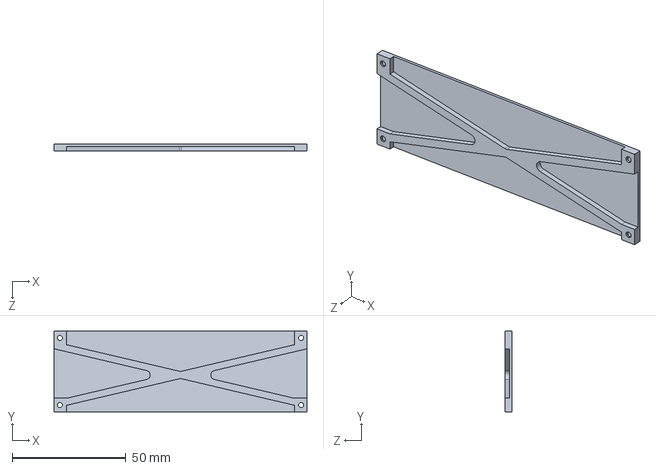
[picture p36: CAD file, 2024-05-15]
hardware/v1_HHI/parts/v1_cover_2.SLDPRT
111.2 x 35.5 x 3.00 mm
