dustin-lehmann/TWIPR/hardware/v2/parts/v2_platform_control_v4_PanelMount.SLDPRT

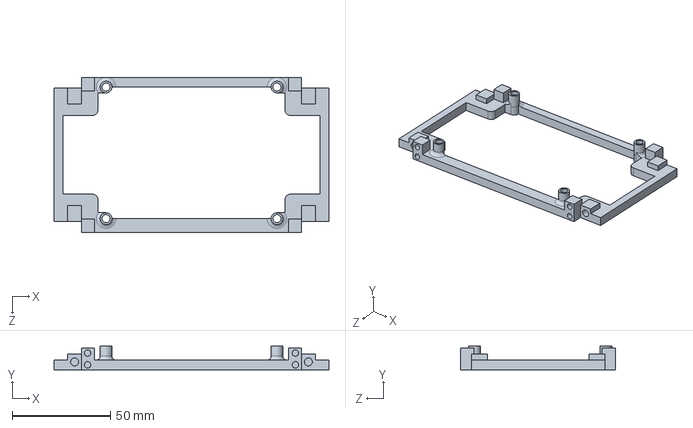
[picture p37: CAD file, 2024-07-05]
hardware/v2/parts/v2_platform_control_v4_PanelMount.SLDPRT
140.0 x 12.0 x 79.0 mm
