dustin-lehmann/TWIPR/hardware/v1_HHI/parts/v1brace_left_display_large.SLDPRT

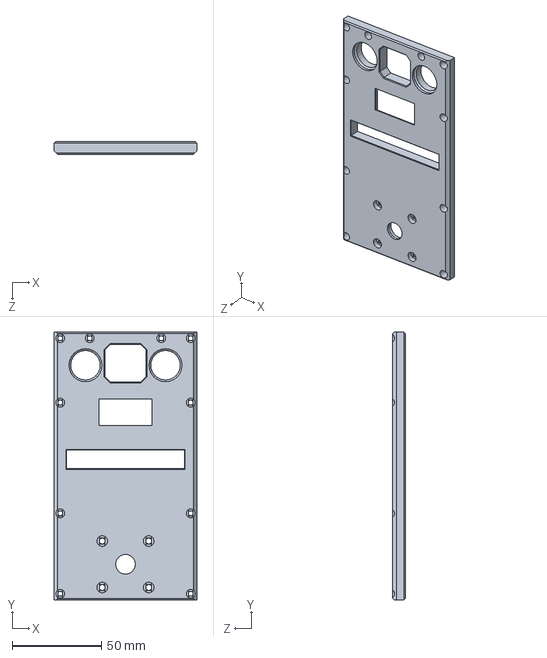
[picture p38: CAD file, 2024-05-15]
hardware/v1_HHI/parts/v1brace_left_display_large.SLDPRT
80.0 x 150.0 x 7.00 mm
