dustin-lehmann/TWIPR/hardware/v2/parts/v2_marker_top.SLDPRT

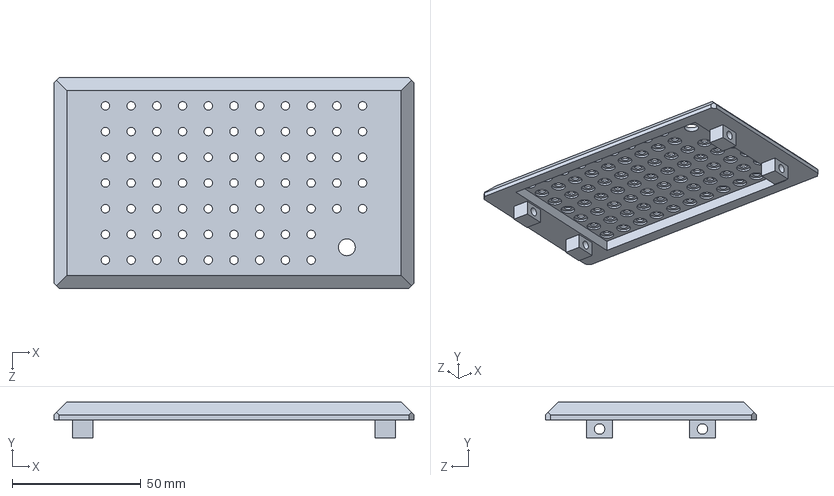
[picture p39: CAD file, 2024-07-05]
hardware/v2/parts/v2_marker_top.SLDPRT
140.0 x 14.0 x 82.0 mm
