dustin-lehmann/TWIPR/hardware/v1_HHI/parts/v1_bumper.SLDPRT

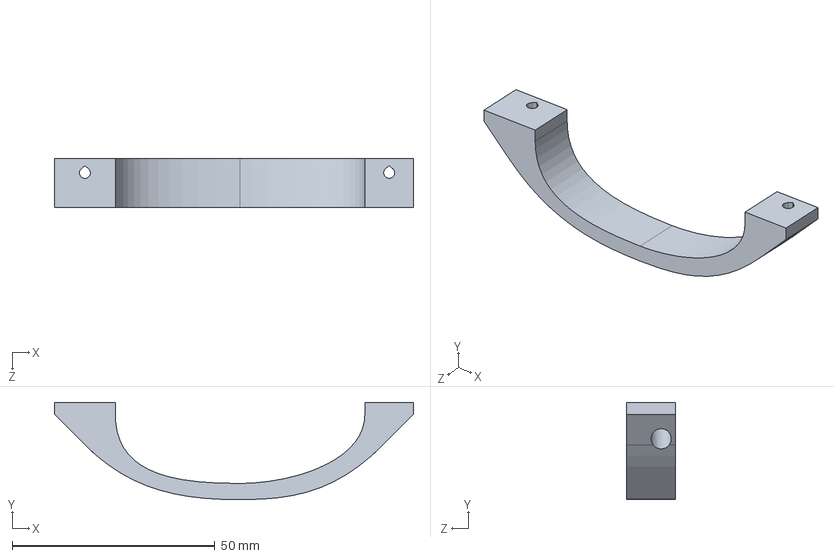
[picture p40: CAD file, 2024-05-09]
hardware/v1_HHI/parts/v1_bumper.SLDPRT
88.5 x 24.0 x 12.0 mm
