dustin-lehmann/TWIPR/hardware/v2/parts/v2_platform_middle_big_bms.SLDPRT

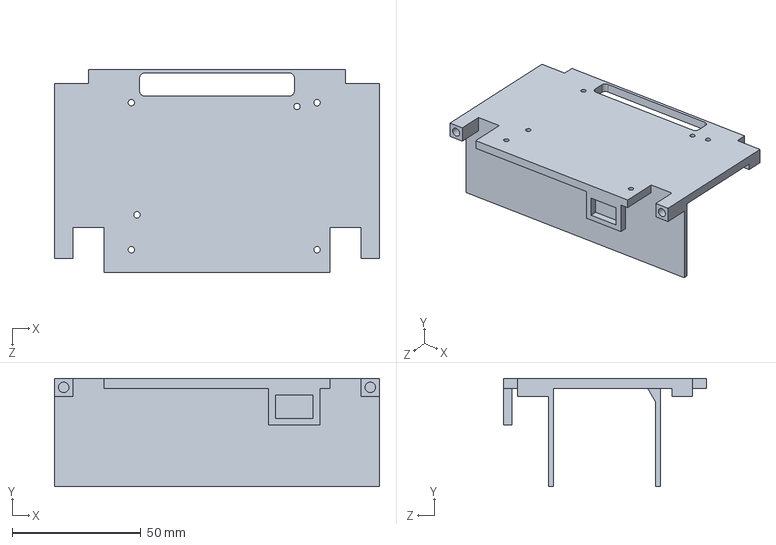
[picture p41: CAD file, 2024-07-05]
hardware/v2/parts/v2_platform_middle_big_bms.SLDPRT
126.0 x 42.0 x 78.8 mm
