dustin-lehmann/TWIPR/hardware/v1_HHI/parts/v1_platform_middle.SLDPRT

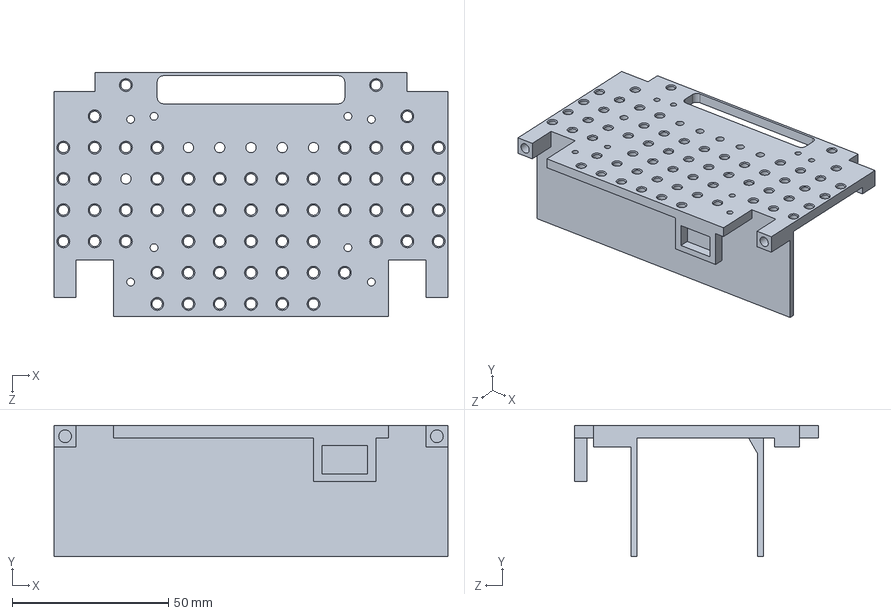
[picture p42: CAD file, 2024-05-09]
hardware/v1_HHI/parts/v1_platform_middle.SLDPRT
126.0 x 42.0 x 78.0 mm
