dustin-lehmann/TWIPR/hardware/v2/parts/v2_brace_right.SLDPRT

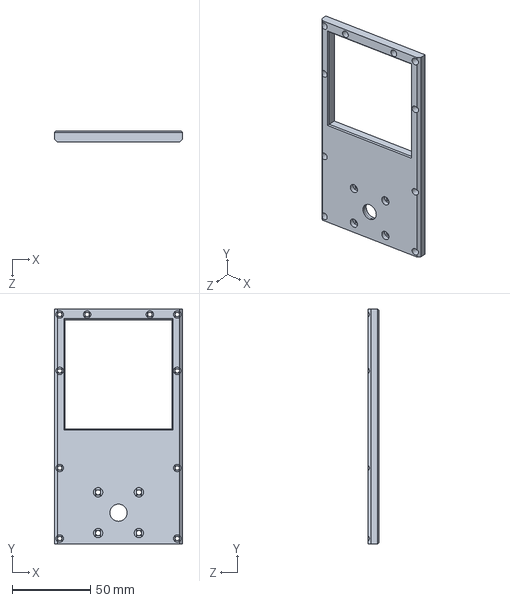
[picture p43: CAD file, 2024-07-05]
hardware/v2/parts/v2_brace_right.SLDPRT
82.0 x 150.0 x 7.00 mm
