dustin-lehmann/TWIPR/hardware/v2/parts/v2_brace_front_led.SLDPRT

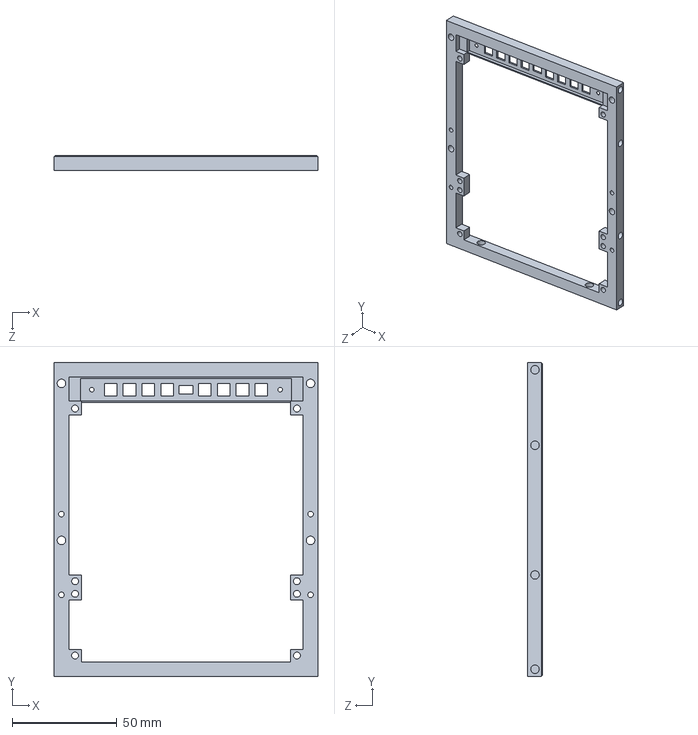
[picture p44: CAD file, 2024-07-05]
hardware/v2/parts/v2_brace_front_led.SLDPRT
126.0 x 150.0 x 7.00 mm
