dustin-lehmann/TWIPR/hardware/v1_HHI/parts/v1_brace_left.SLDPRT

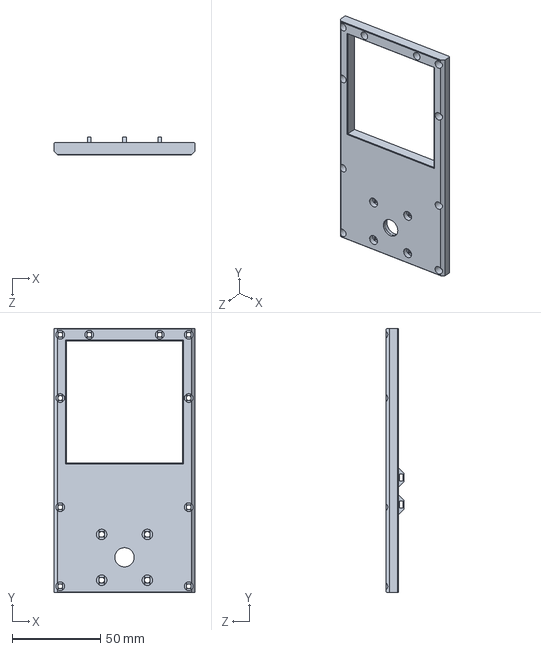
[picture p45: CAD file, 2024-02-12]
hardware/v1_HHI/parts/v1_brace_left.SLDPRT
80.0 x 150.0 x 10.2 mm
