dustin-lehmann/TWIPR/hardware/v2/parts/v2_BMS_holder_big.SLDPRT

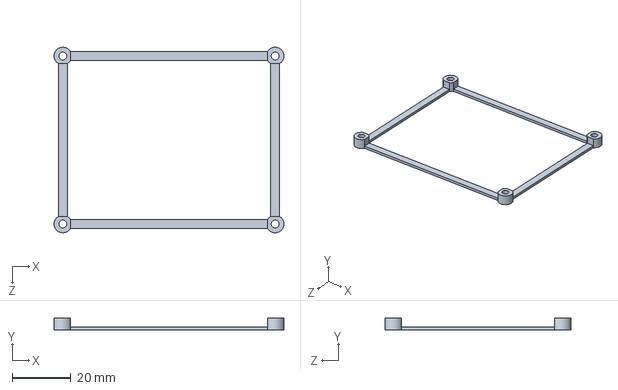
[picture p46: CAD file, 2024-05-30]
hardware/v2/parts/v2_BMS_holder_big.SLDPRT
78.0 x 4.00 x 63.0 mm
