dustin-lehmann/TWIPR/hardware/v1_HHI/parts/v1_BMS_holder.SLDPRT

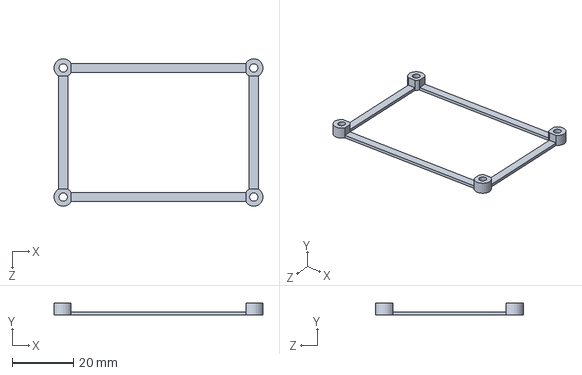
[picture p47: CAD file, 2024-02-12]
hardware/v1_HHI/parts/v1_BMS_holder.SLDPRT
68.0 x 4.00 x 48.0 mm
