dustin-lehmann/TWIPR/hardware/v1_HHI/parts/v1_platform_control.SLDPRT

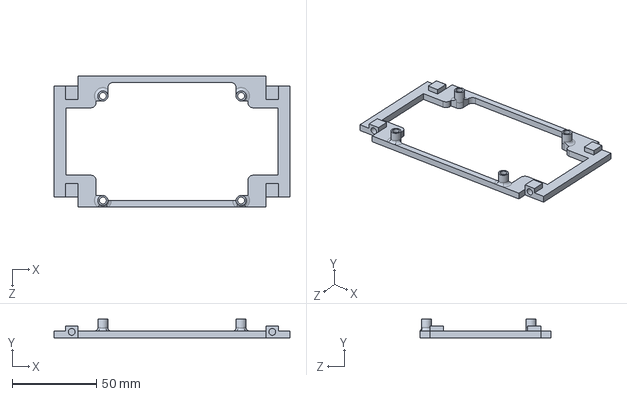
[picture p48: CAD file, 2024-02-12]
hardware/v1_HHI/parts/v1_platform_control.SLDPRT
140.0 x 11.0 x 78.0 mm
