dustin-lehmann/TWIPR/hardware/v2/parts/v2_brace_back.SLDPRT

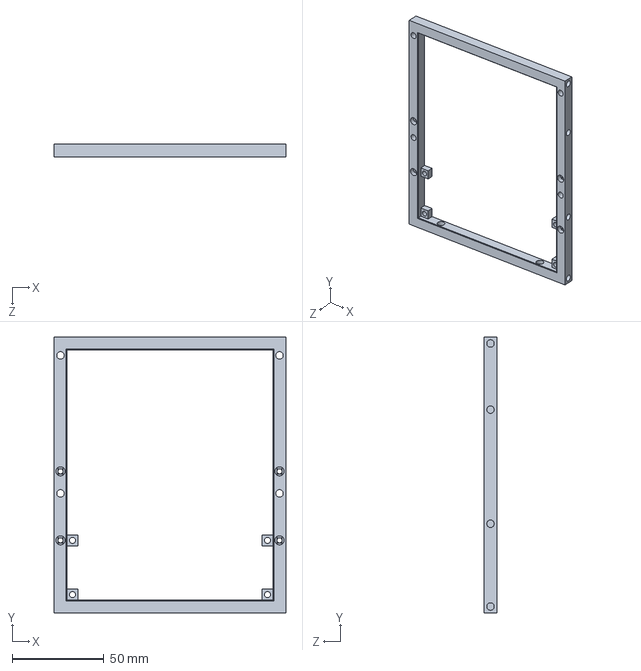
[picture p49: CAD file, 2024-02-12]
hardware/v2/parts/v2_brace_back.SLDPRT
126.0 x 150.0 x 7.00 mm
