dustin-lehmann/TWIPR/(list of files, cad)

Other CAD files:
software/host/RobotManager/extensions/babylon/babylon_lib/models/diff_drive_robot/design/export_robot.SLDASM
software/host/RobotManager/extensions/gui/babylon_dummy/babylon/babylon_lib/models/diff_drive_robot/design/export_robot.SLDASM
hardware/v1_HHI/twipr_sketch.SLDPRT
hardware/covers/label_cover_front.SLDPRT
hardware/v1_HHI/common_parts/banebots_rmd4015_hub/T81P-49.stp.SLDPRT
hardware/covers/label_cover_back.SLDPRT
hardware/v1_HHI/parts/v1_marker_top.SLDPRT
hardware/v1_HHI/parts/v1_bat_compartment_lid.SLDPRT
hardware/v2/parts/v2_brace_front.SLDPRT
hardware/covers/label_cover_back.DXF
hardware/v1/parts/v1_bat_compartment_lid.SLDPRT
hardware/v1/parts/v1_marker_top.SLDPRT
