dustin-lehmann/TWIPR/electronics/bms/rev2/BMS_4S_S8254_ChargePort.kicad_pcb

## KiCad design electronics/bms/rev2/BMS_4S_S8254_ChargePort.kicad_pcb (2024-11-11)

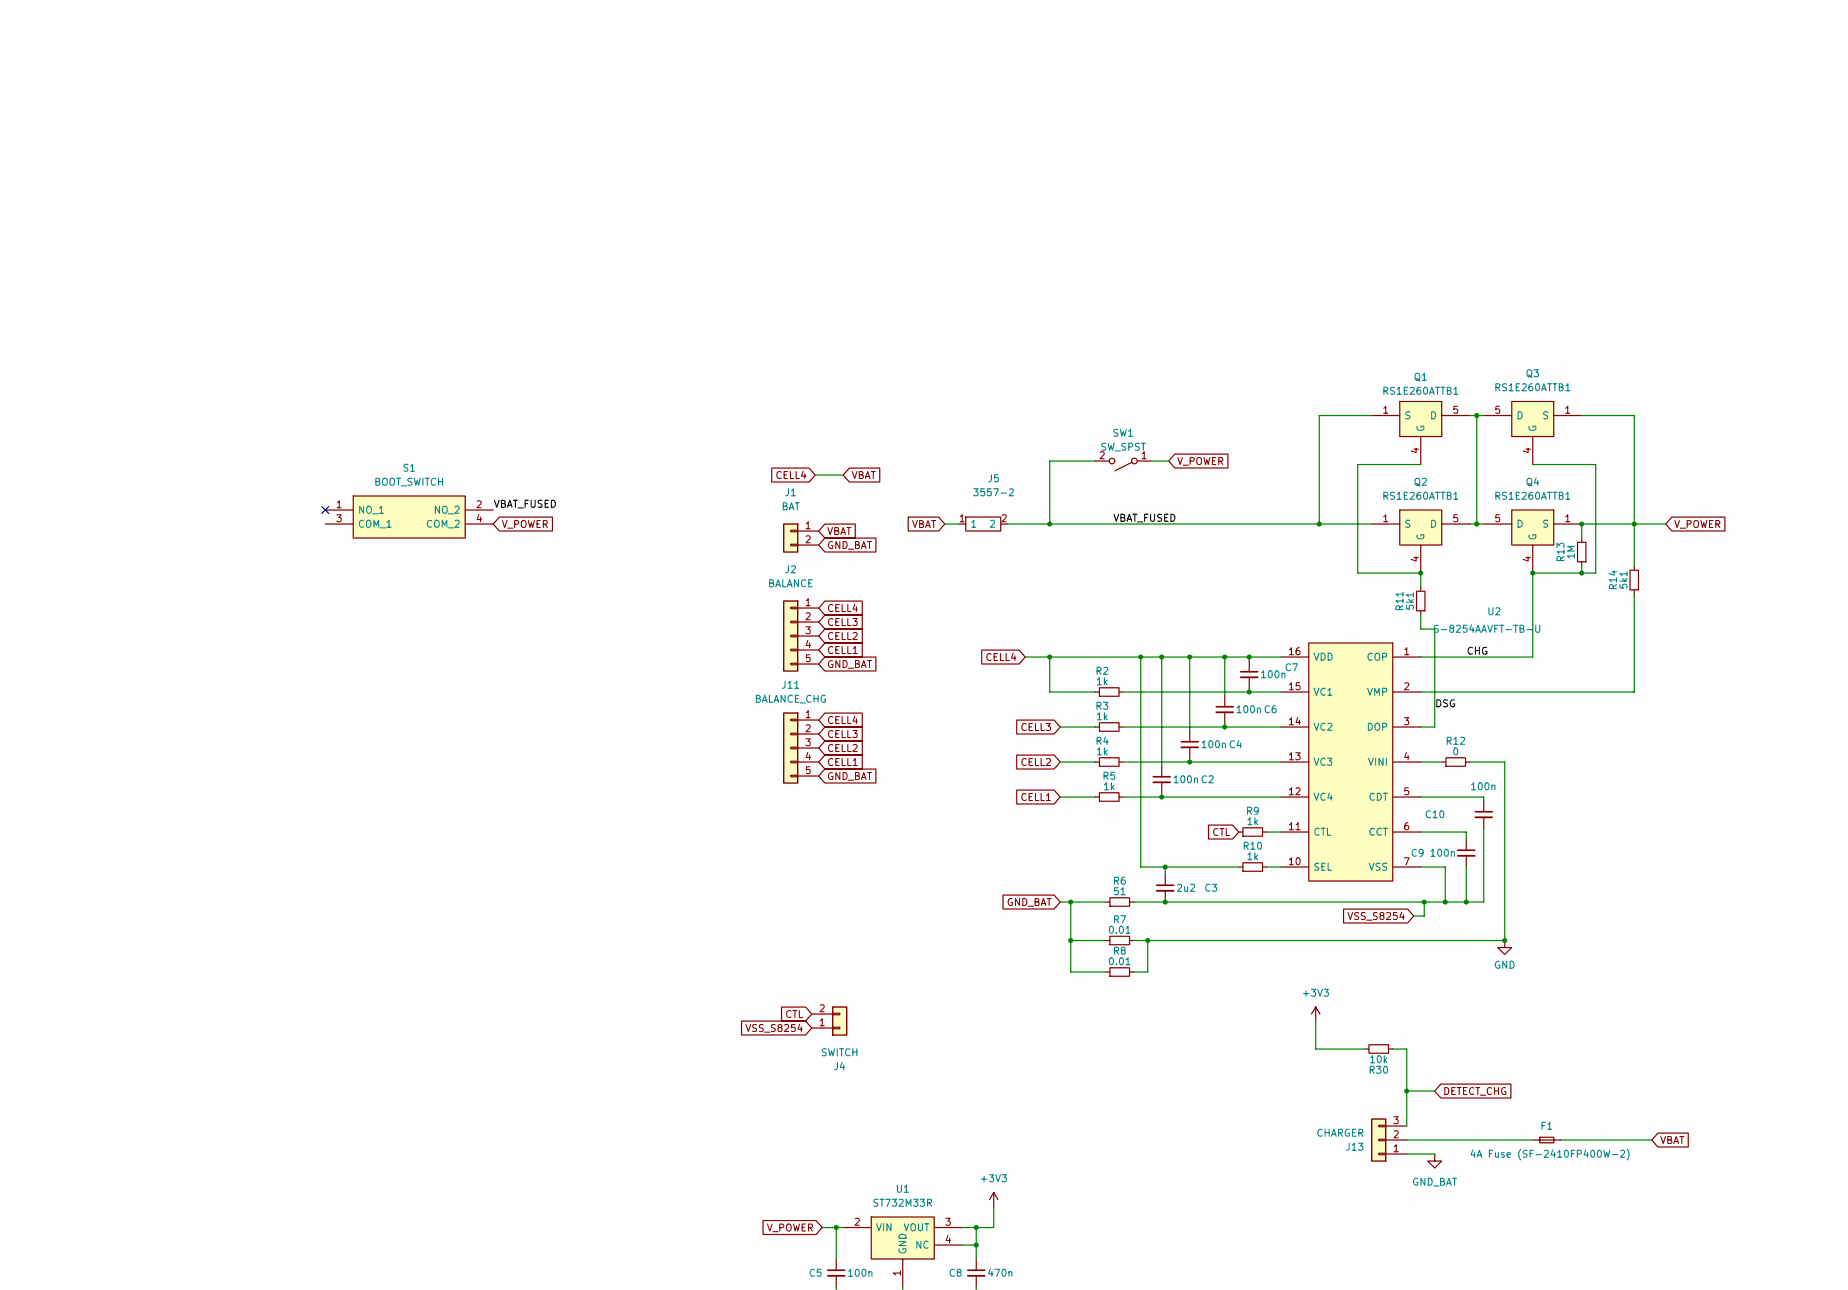
[picture p50: schematic BMS_4S_S8254_ChargePort.kicad_sch, part in row 1, column 1]

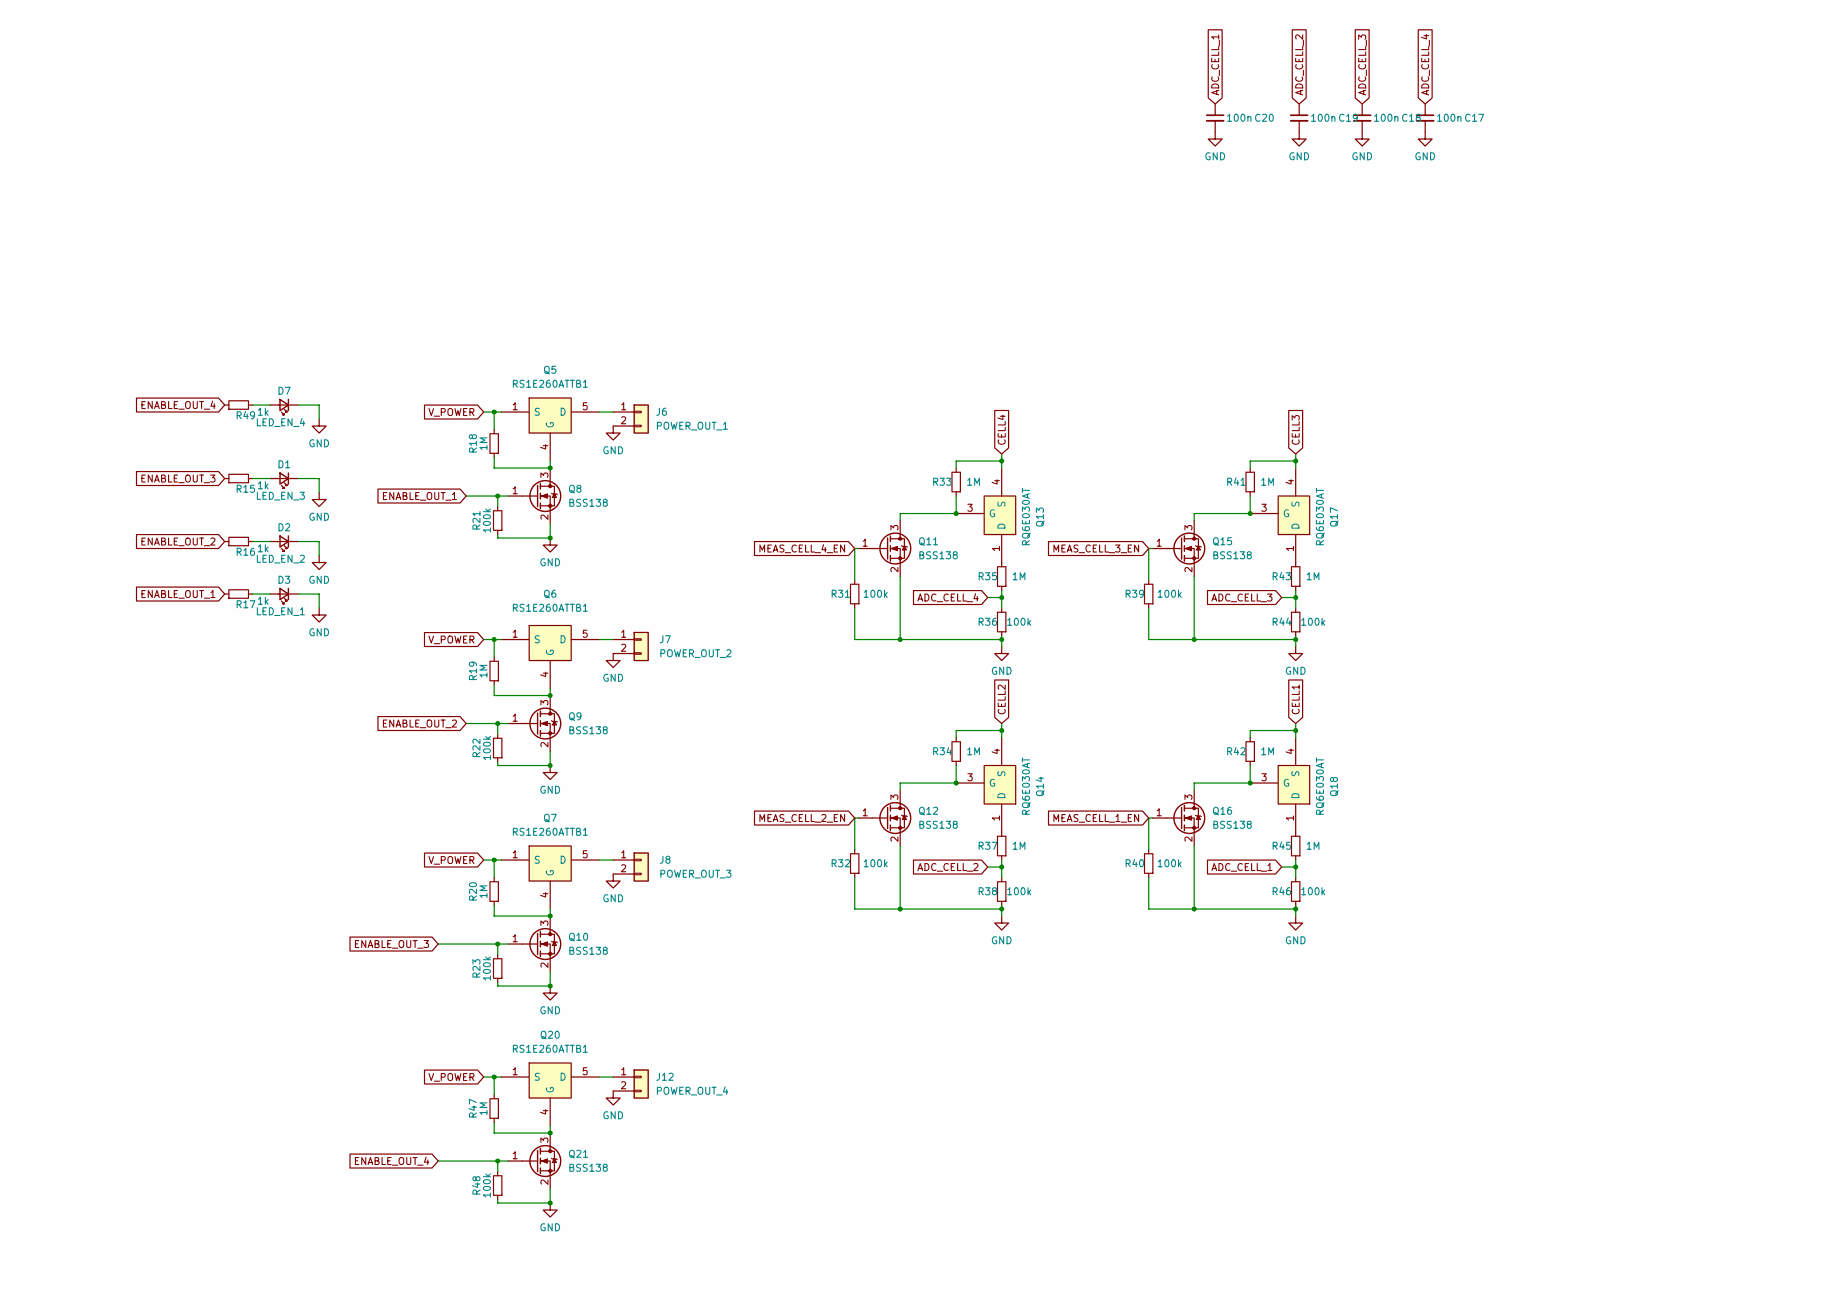
[picture p51: schematic BMS_4S_S8254_ChargePort.kicad_sch, part in row 1, column 2]

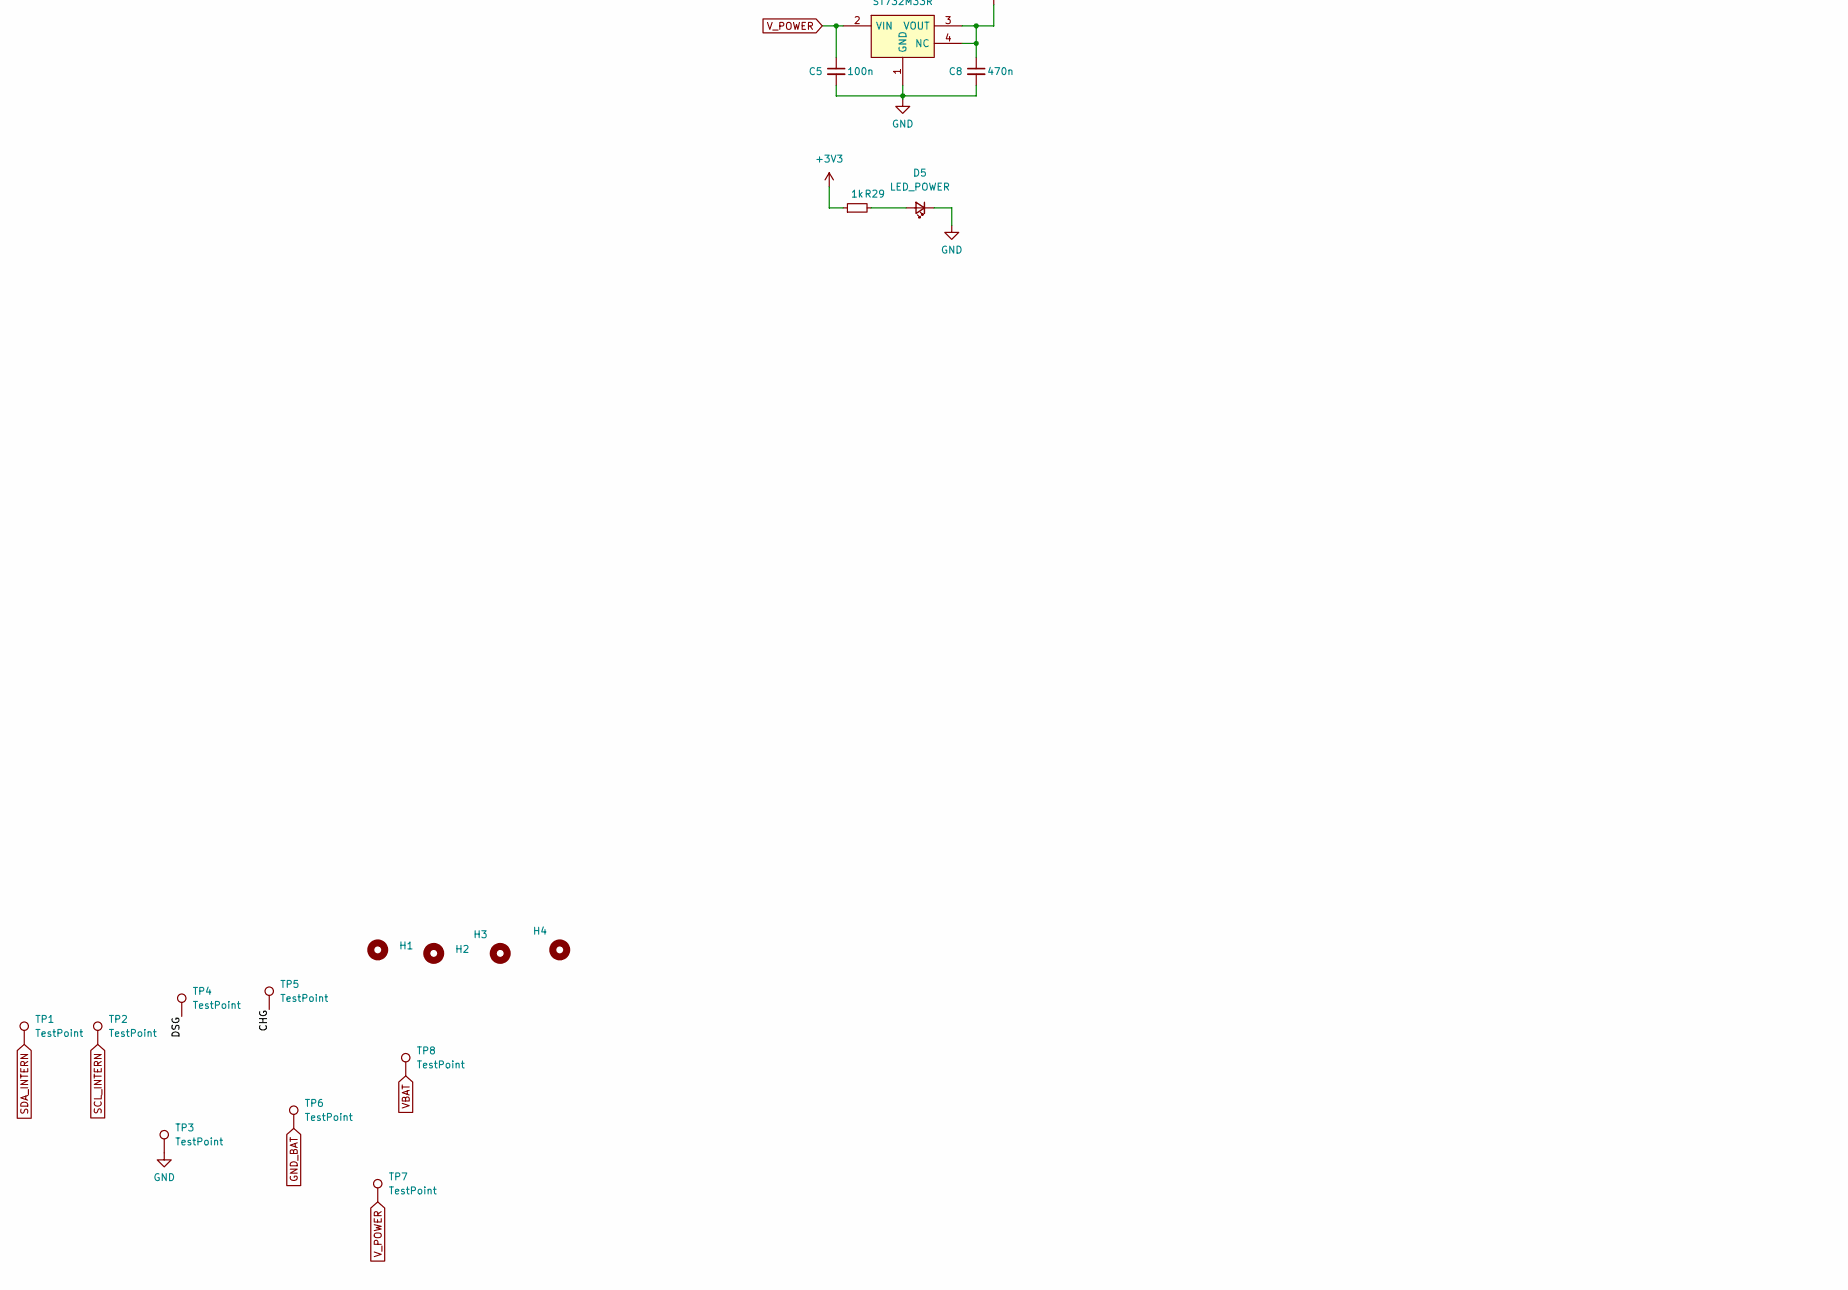
[picture p52: schematic BMS_4S_S8254_ChargePort.kicad_sch, part in row 2, column 1]

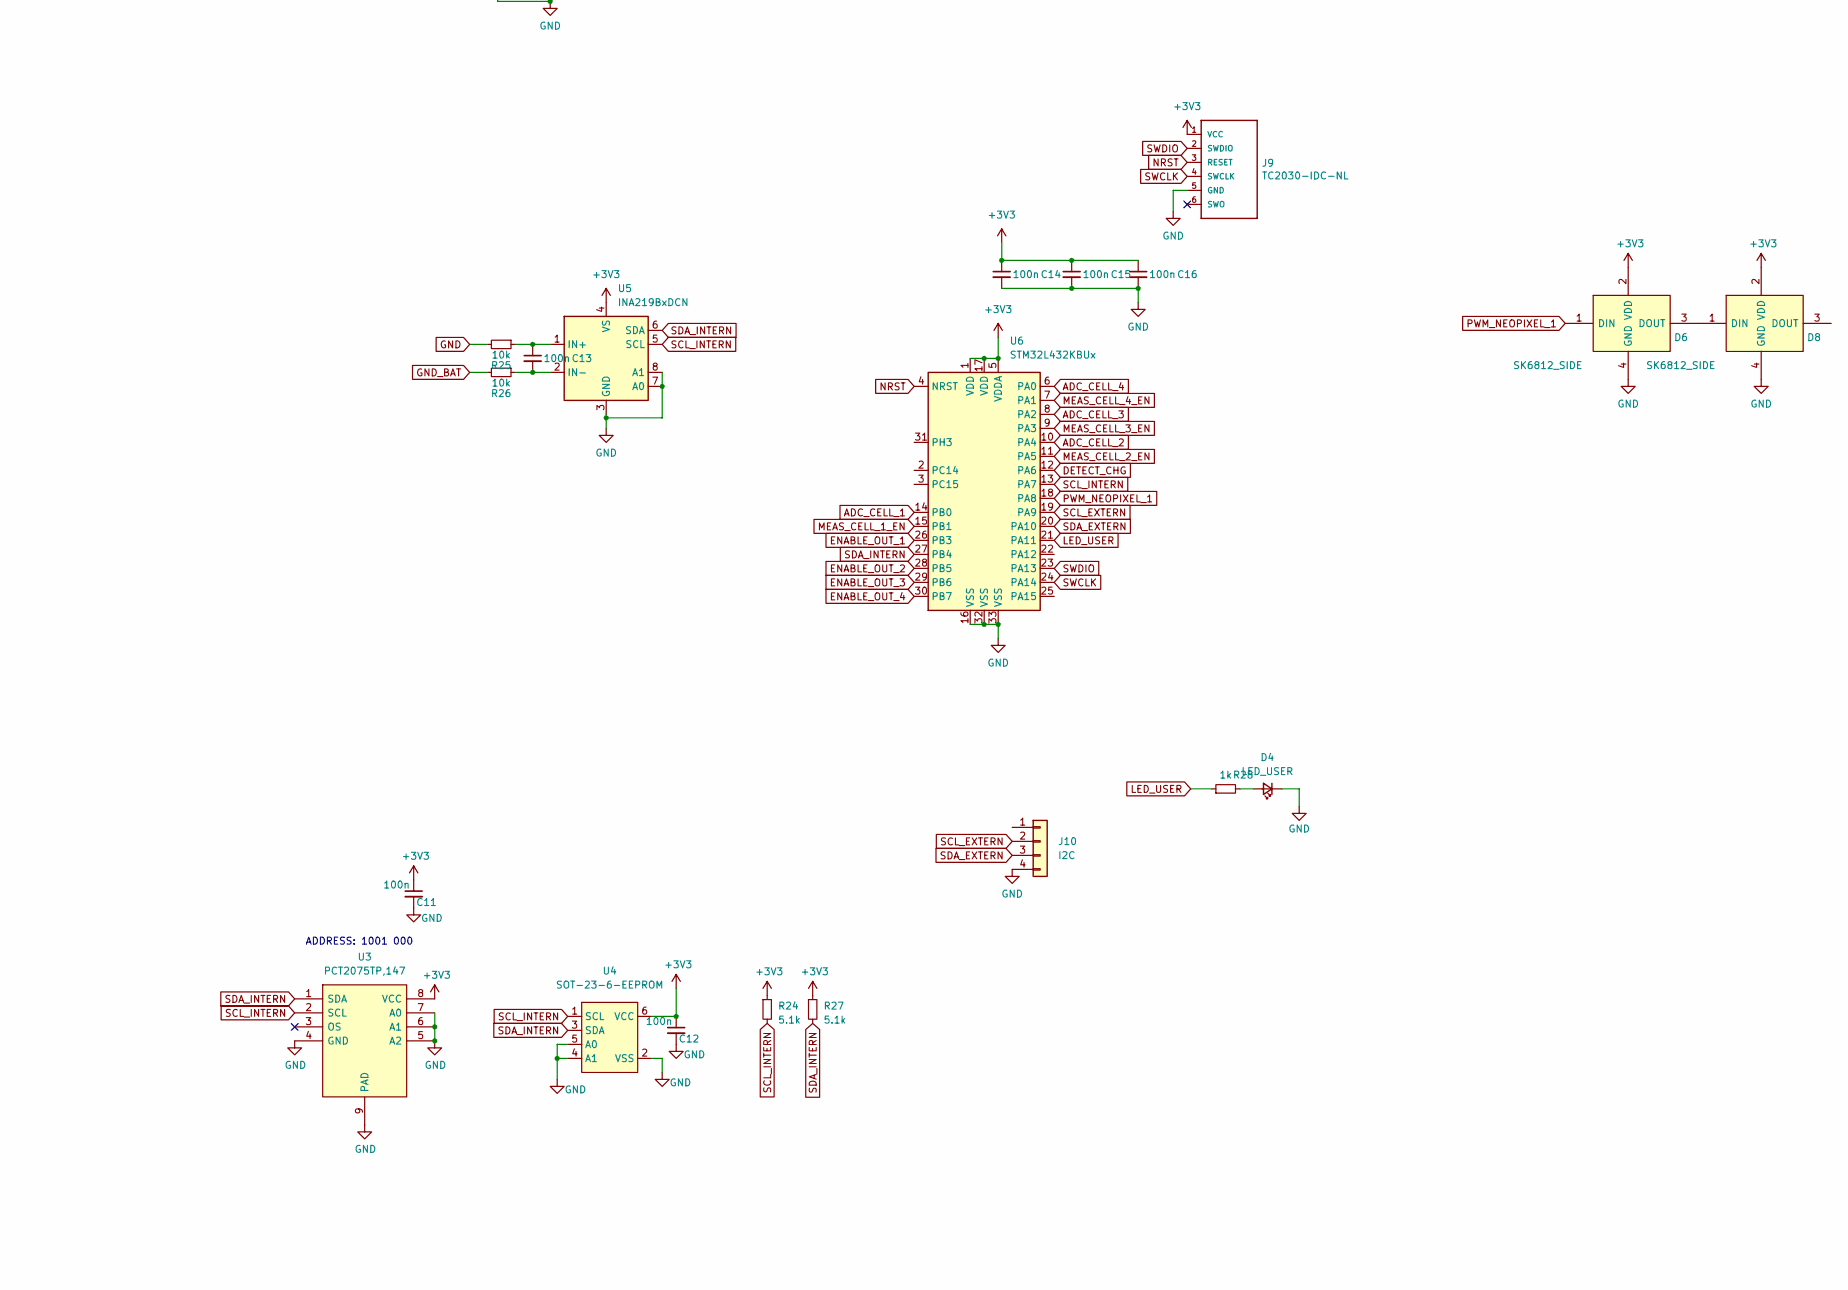
[picture p53: schematic BMS_4S_S8254_ChargePort.kicad_sch, part in row 2, column 2]

Parts:
C2, C4, C5, C6, C7, C9, C10, C11, C12, C13, C14, C15, C16, C17, C18, C19, C20: 100n; C_0603_1608Metric
C3: 2u2; C_0805_2012Metric
C8: 470n; C_0603_1608Metric
D1: LED_EN_3; LED_0603_1608Metric
D2: LED_EN_2; LED_0603_1608Metric
D3: LED_EN_1; LED_0603_1608Metric
D4: LED_USER; LED_0603_1608Metric
D5: LED_POWER; LED_0603_1608Metric
D6, D8: SK6812_SIDE; SK6812SIDE; Manufacturer_Part_Number SK6812 SIDE
D7: LED_EN_4; LED_0603_1608Metric
F1: 4A Fuse (SF-2410FP400W-2); R_2512_6332Metric
H1, H2, H3, H4: MH_noPad_2.5
J1: BAT; AMASS_XT60PW-M
J2: BALANCE; JST_XH_S5B-XH-A_1x05_P2.50mm_Horizontal
J4: SWITCH; JST_GH_BM02B-GHS-TBT_1x02-1MP_P1.25mm_Vertical
J5: 3557-2; Mouser Part Number 534-3557-2
J6: POWER_OUT_1; 691322110002
J7: POWER_OUT_2; 691322110002
J8: POWER_OUT_3; 691322110002
J9: TC2030-IDC-NL; Tag-Connect_TC2030-IDC-NL_2x03_P1.27mm_Vertical
J10: I2C; JST_GH_BM04B-GHS-TBT_1x04-1MP_P1.25mm_Vertical
J11: BALANCE_CHG; JST_XH_S5B-XH-A_1x05_P2.50mm_Horizontal
J12: POWER_OUT_4; 691322110002
J13: CHARGER; AMASS_XT60IPW-M_1x03_P7.20mm_Horizontal
Q1, Q2, Q3, Q4, Q5, Q6, Q7, Q20: RS1E260ATTB1; Mouser Part Number 755-RS1E260ATTB1
Q8, Q9, Q10, Q11, Q12, Q15, Q16, Q21: BSS138; SOT-323_SC-70
Q13, Q14, Q17, Q18: RQ6E030AT; SOT95P280X100-6N; Mouser Part Number 755-RZQ045P01TR
R2, R3, R4, R5, R9, R10, R15, R16, R17, R28, R29, R49: 1k; R_0603_1608Metric
R6: 51; R_0603_1608Metric
R7, R8: 0.01; R_2512_6332Metric
R11, R14: 5k1; R_0603_1608Metric
R12: 0; R_0603_1608Metric
R13, R18, R19, R20, R33, R34, R35, R37, R41, R42, R43, R45, R47: 1M; R_0603_1608Metric
R21, R22, R23, R31, R32, R36, R38, R39, R40, R44, R46, R48: 100k; R_0603_1608Metric
R24, R27: 5.1k; R_0603_1608Metric
R25, R26, R30: 10k; R_0603_1608Metric
S1: BOOT_SWITCH; EVQPUA02K; Manufacturer_Part_Number 434123025826
SW1: SW_SPST; JST_GH_BM02B-GHS-TBT_1x02-1MP_P1.25mm_Vertical
TP1, TP2, TP3, TP4, TP5, TP6, TP7, TP8: TestPoint; TestPoint_Pad_D1.5mm
U1: ST732M33R; SOT95P280X145-5N; Mouser Part Number 511-ST732M33R
U2: S-8254AAVFT-TB-U; SOP65P640X110-16N; Mouser Part Number 628-S-8254AAVFT-TB-G
U3: PCT2075TP,147; SON50P300X200X80-9N; Mouser Part Number 771-PCT2075TP147
U4: SOT-23-6-EEPROM; SOT-23-6
U5: INA219BxDCN; SOT-23-8
U6: STM32L432KBUx; QFN-32-1EP_5x5mm_P0.5mm_EP3.45x3.45mm

Connections:
+3V3: C8.1, C11.1, C12.1, C14.1, C15.1, C16.1, D6.2 (VDD), D8.2 (VDD), J9.1 (VCC), R24.1, R27.1, R29.1, R30.2, U1.3 (VOUT), U1.4 (NC), U3.8 (VCC), U4.6 (VCC), U5.4 (VS), U6.1 (VDD), U6.5 (VDDA), U6.17 (VDD)
/CHG: Q3.4 (G), Q4.4 (G), R13.1, TP5.1, U2.1 (COP)
/DSG: R11.1, TP4.1, U2.3 (DOP)
/VBAT_FUSED: J5.2, J5.4, Q1.1 (S), Q1.2 (S), Q1.3 (S), Q2.1 (S), Q2.2 (S), Q2.3 (S), S1.2 (NO_2), SW1.2 (B)
ADC_CELL_1: C20.1, R45.1, R46.2, U6.14 (PB0)
ADC_CELL_2: C19.1, R37.1, R38.2, U6.10 (PA4)
ADC_CELL_3: C18.1, R43.1, R44.2, U6.8 (PA2)
ADC_CELL_4: C17.1, R35.1, R36.2, U6.6 (PA0)
CELL1: J2.4, J11.4, Q18.4 (S), R5.1, R42.2
CELL2: J2.3, J11.3, Q14.4 (S), R4.1, R34.2
CELL3: J2.2, J11.2, Q17.4 (S), R3.1, R41.2
CELL4: C2.1, C3.1, C4.1, C6.1, C7.1, F1.2, J1.1, J2.1, J5.1, J5.3, J11.1, Q13.4 (S), R2.1, R10.1, R33.2, TP8.1, U2.16 (VDD)
CTL: J4.2, R9.1
DETECT_CHG: J13.3, R30.1, U6.12 (PA6)
ENABLE_OUT_1: Q8.1 (G), R17.1, R21.2, U6.26 (PB3)
ENABLE_OUT_2: Q9.1 (G), R16.1, R22.2, U6.28 (PB5)
ENABLE_OUT_3: Q10.1 (G), R15.1, R23.2, U6.29 (PB6)
ENABLE_OUT_4: Q21.1 (G), R48.2, R49.1, U6.30 (PB7)
GND: C5.2, C8.2, C11.2, C12.2, C14.2, C15.2, C16.2, C17.2, C18.2, C19.2, C20.2, D1.1 (K), D2.1 (K), D3.1 (K), D4.1 (K), D5.1 (K), D6.4 (GND), D7.1 (K), D8.4 (GND), J6.2, J7.2, J8.2, J9.5 (GND), J10.4, J12.2, Q8.2 (S), Q9.2 (S), Q10.2 (S), Q11.2 (S), Q12.2 (S), Q15.2 (S), Q16.2 (S), Q21.2 (S), R7.2, R8.2, R12.2, R21.1, R22.1, R23.1, R25.2, R31.1, R32.1, R36.1, R38.1, R39.1, R40.1, R44.1, R46.1, R48.1, TP3.1, U1.1 (GND), U3.4 (GND), U3.5 (A2), U3.6 (A1), U3.7 (A0), U3.9 (PAD), U4.2 (VSS), U4.4 (A1), U4.5 (A0), U5.3 (GND), U5.7 (A0), U5.8 (A1), U6.16 (VSS), U6.32 (VSS), U6.33 (VSS)
GND_BAT: J1.2, J2.5, J11.5, J13.1, R6.1, R7.1, R8.1, R26.2, TP6.1
LED_USER: R28.1, U6.21 (PA11)
MEAS_CELL_1_EN: Q16.1 (G), R40.2, U6.15 (PB1)
MEAS_CELL_2_EN: Q12.1 (G), R32.2, U6.11 (PA5)
MEAS_CELL_3_EN: Q15.1 (G), R39.2, U6.9 (PA3)
MEAS_CELL_4_EN: Q11.1 (G), R31.2, U6.7 (PA1)
NRST: J9.3 (RESET), U6.4 (NRST)
unnamed: D1.2 (A), R15.2
unnamed: D2.2 (A), R16.2
unnamed: D3.2 (A), R17.2
unnamed: D4.2 (A), R28.2
unnamed: D5.2 (A), R29.2
unnamed: D6.3 (DOUT), D8.1 (DIN)
unnamed: D7.2 (A), R49.2
unnamed: J6.1, Q5.5 (D), Q5.6 (D), Q5.7 (D), Q5.8 (D), Q5.9 (D)
unnamed: J7.1, Q6.5 (D), Q6.6 (D), Q6.7 (D), Q6.8 (D), Q6.9 (D)
unnamed: J8.1, Q7.5 (D), Q7.6 (D), Q7.7 (D), Q7.8 (D), Q7.9 (D)
unnamed: J12.1, Q20.5 (D), Q20.6 (D), Q20.7 (D), Q20.8 (D), Q20.9 (D)
unnamed: F1.1, J13.2
unnamed: Q1.5 (D), Q1.6 (D), Q1.7 (D), Q1.8 (D), Q1.9 (D), Q2.5 (D), Q2.6 (D), Q2.7 (D), Q2.8 (D), Q2.9 (D), Q3.5 (D), Q3.6 (D), Q3.7 (D), Q3.8 (D), Q3.9 (D), Q4.5 (D), Q4.6 (D), Q4.7 (D), Q4.8 (D), Q4.9 (D)
unnamed: Q1.4 (G), Q2.4 (G), R11.2
unnamed: Q5.4 (G), Q8.3 (D), R18.1
unnamed: Q6.4 (G), Q9.3 (D), R19.1
unnamed: Q7.4 (G), Q10.3 (D), R20.1
unnamed: Q11.3 (D), Q13.3 (G), R33.1
unnamed: Q12.3 (D), Q14.3 (G), R34.1
unnamed: Q13.1 (D), Q13.2 (D), Q13.5 (D), Q13.6 (D), R35.2
unnamed: Q14.1 (D), Q14.2 (D), Q14.5 (D), Q14.6 (D), R37.2
unnamed: Q15.3 (D), Q17.3 (G), R41.1
unnamed: Q16.3 (D), Q18.3 (G), R42.1
unnamed: Q17.1 (D), Q17.2 (D), Q17.5 (D), Q17.6 (D), R43.2
unnamed: Q18.1 (D), Q18.2 (D), Q18.5 (D), Q18.6 (D), R45.2
unnamed: Q20.4 (G), Q21.3 (D), R47.1
unnamed: C9.1, U2.6 (CCT)
unnamed: C10.1, U2.5 (CDT)
unnamed: R9.2, U2.11 (CTL)
unnamed: R10.2, U2.10 (SEL)
unnamed: C7.2, R2.2, U2.15 (VC1)
unnamed: C6.2, R3.2, U2.14 (VC2)
unnamed: C4.2, R4.2, U2.13 (VC3)
unnamed: C2.2, R5.2, U2.12 (VC4)
unnamed: R12.1, U2.4 (VINI)
unnamed: R14.1, U2.2 (VMP)
unnamed: C13.1, R25.1, U5.1 (IN+)
unnamed: C13.2, R26.1, U5.2 (IN-)
PWM_NEOPIXEL_1: D6.1 (DIN), U6.18 (PA8)
SCL_EXTERN: J10.2, U6.19 (PA9)
SCL_INTERN: R24.2, TP2.1, U3.2 (SCL), U4.1 (SCL), U5.5 (SCL), U6.13 (PA7)
SDA_EXTERN: J10.3, U6.20 (PA10)
SDA_INTERN: R27.2, TP1.1, U3.1 (SDA), U4.3 (SDA), U5.6 (SDA), U6.27 (PB4)
SWCLK: J9.4 (SWCLK), U6.24 (PA14)
SWDIO: J9.2 (SWDIO), U6.23 (PA13)
VSS_S8254: C3.2, C9.2, C10.2, J4.1, R6.2, U2.7 (VSS)
V_POWER: C5.1, Q3.1 (S), Q3.2 (S), Q3.3 (S), Q4.1 (S), Q4.2 (S), Q4.3 (S), Q5.1 (S), Q5.2 (S), Q5.3 (S), Q6.1 (S), Q6.2 (S), Q6.3 (S), Q7.1 (S), Q7.2 (S), Q7.3 (S), Q20.1 (S), Q20.2 (S), Q20.3 (S), R13.2, R14.2, R18.2, R19.2, R20.2, R47.2, S1.4 (COM_2), SW1.1 (A), TP7.1, U1.2 (VIN)

Notes on the sheet:
ADDRESS: 1001 000

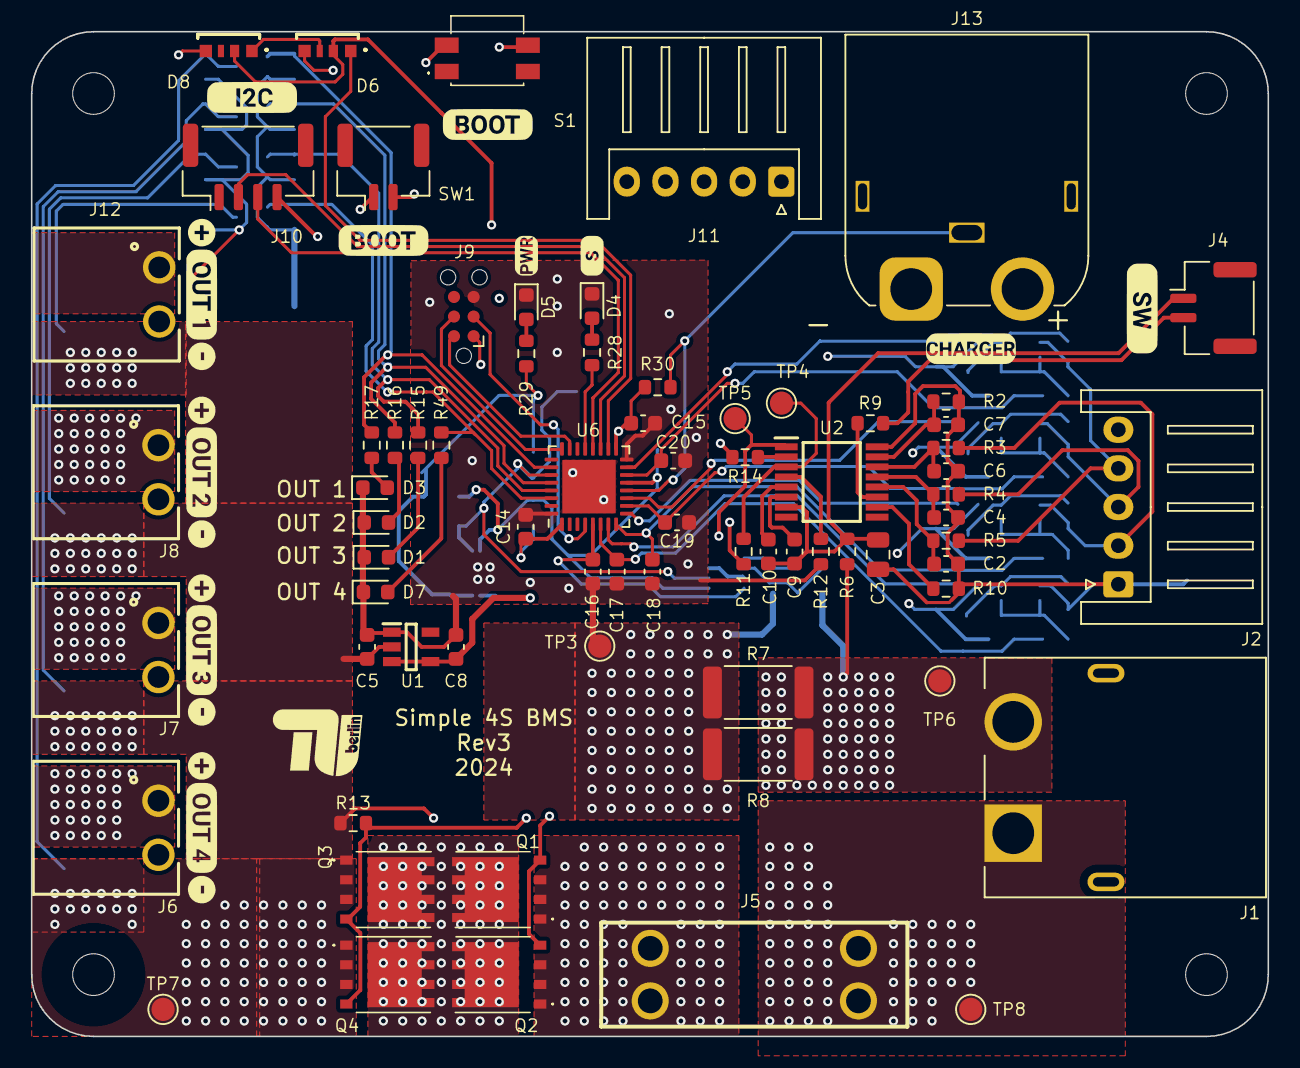
[picture p54: board BMS_4S_S8254_ChargePort.kicad_pcb from above]

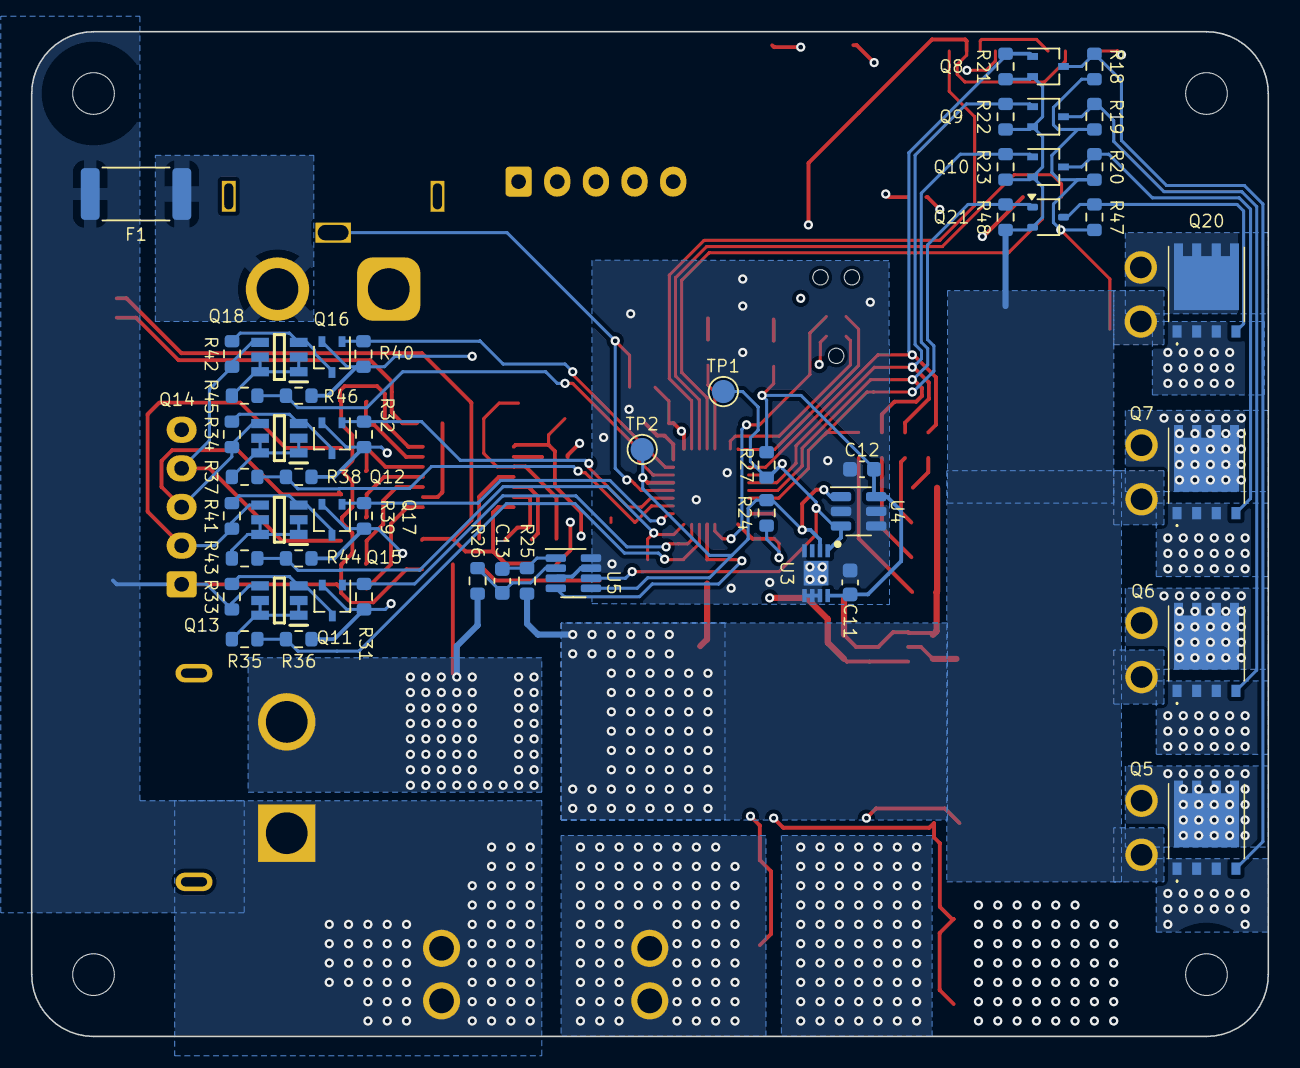
[picture p55: board BMS_4S_S8254_ChargePort.kicad_pcb from below]

Board: 4 copper layers, 80.0 x 65.0 mm, 128 parts (53 on the bottom side), 73 nets.
