dustin-lehmann/TWIPR/electronics/control/rev4/robot-hub_rev4/communication.kicad_sch

## KiCad design electronics/control/rev4/robot-hub_rev4/communication.kicad_sch (2024-07-17)

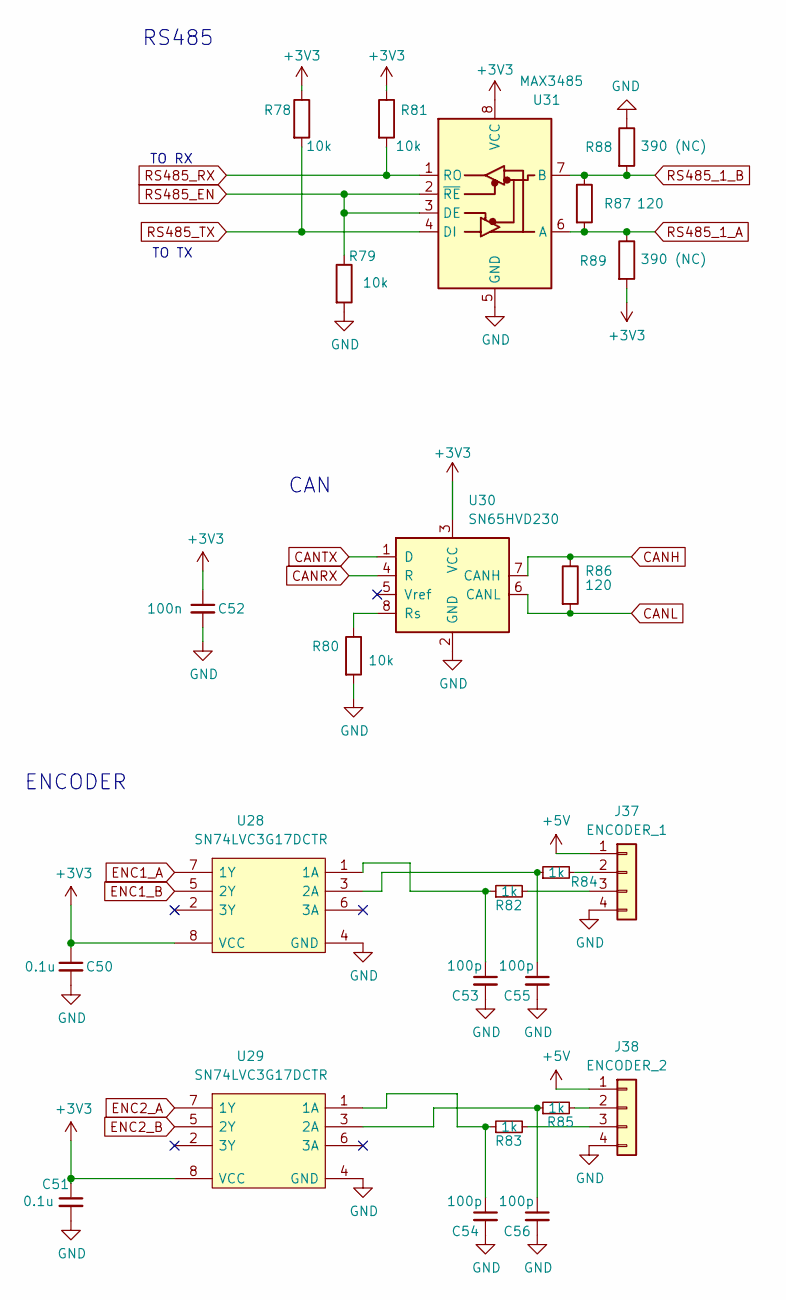
[picture p56: schematic communication.kicad_sch]

Parts:
C50, C51: 0.1u; C_0603_1608Metric
C52: 100n; C_0603_1608Metric
C53, C54, C55, C56: 100p; C_0603_1608Metric
J37: ENCODER_1; JST_GH_BM04B-GHS-TBT_1x04-1MP_P1.25mm_Vertical
J38: ENCODER_2; JST_GH_BM04B-GHS-TBT_1x04-1MP_P1.25mm_Vertical
R78, R79, R81: 10k; R_0603_1608Metric; Part Description Resistor 1K M1005 1% 63mW
R80: 10k; R_0603_1608Metric; Part Description Resistor 2.2K M1005 1% 63mW
R82, R83, R84, R85: 1k; R_0603_1608Metric
R86: 120; R_0603_1608Metric; Part Description Resistor 2.2K M1005 1% 63mW
R87: 120; R_0603_1608Metric; Part Description Resistor 1K M1005 1% 63mW
R88, R89: 390 (NC); R_0603_1608Metric; Part Description Resistor 1K M1005 1% 63mW
U28, U29: SN74LVC3G17DCTR; SOP65P400X130-8N; Mouser Part Number 595-SN74LVC3G17DCTR
U30: SN65HVD230; SOIC127P600X175-8N
U31: MAX3485; SOIC127P600X175-8N

Connections:
+3V3: C50.1, C51.1, C52.1, R78.1, R81.1, R89.2, U28.8 (VCC), U29.8 (VCC), U30.3 (VCC), U31.8 (VCC)
+5V: J37.1, J38.1
CANH: R86.1, U30.7 (CANH)
CANL: R86.2, U30.6 (CANL)
CANRX: U30.4 (R)
CANTX: U30.1 (D)
ENC1_A: U28.7 (1Y)
ENC1_B: U28.5 (2Y)
ENC2_A: U29.7 (1Y)
ENC2_B: U29.5 (2Y)
GND: C50.2, C51.2, C52.2, C53.2, C54.2, C55.2, C56.2, J37.4, J38.4, R79.2, R80.2, R88.1, U28.4 (GND), U29.4 (GND), U30.2 (GND), U31.5 (GND)
unnamed: C53.1, R82.1, U28.1 (1A)
unnamed: C54.1, R83.1, U29.1 (1A)
unnamed: C55.1, R84.1, U28.3 (2A)
unnamed: C56.1, R85.1, U29.3 (2A)
unnamed: J37.2, R84.2
unnamed: J37.3, R82.2
unnamed: J38.2, R85.2
unnamed: J38.3, R83.2
unnamed: R80.1, U30.8 (Rs)
RS485_1_A: R87.2, R89.1, U31.6 (A)
RS485_1_B: R87.1, R88.2, U31.7 (B)
RS485_EN: R79.1, U31.2 (~RE), U31.3 (DE)
RS485_RX: R81.2, U31.1 (RO)
RS485_TX: R78.2, U31.4 (DI)

Notes on the sheet:
RS485
TO RX
TO TX
ENCODER
CAN
