dustin-lehmann/TWIPR/electronics/control/rev4/robot-hub_rev4/connectors.kicad_sch

## KiCad design electronics/control/rev4/robot-hub_rev4/connectors.kicad_sch (2024-07-17)

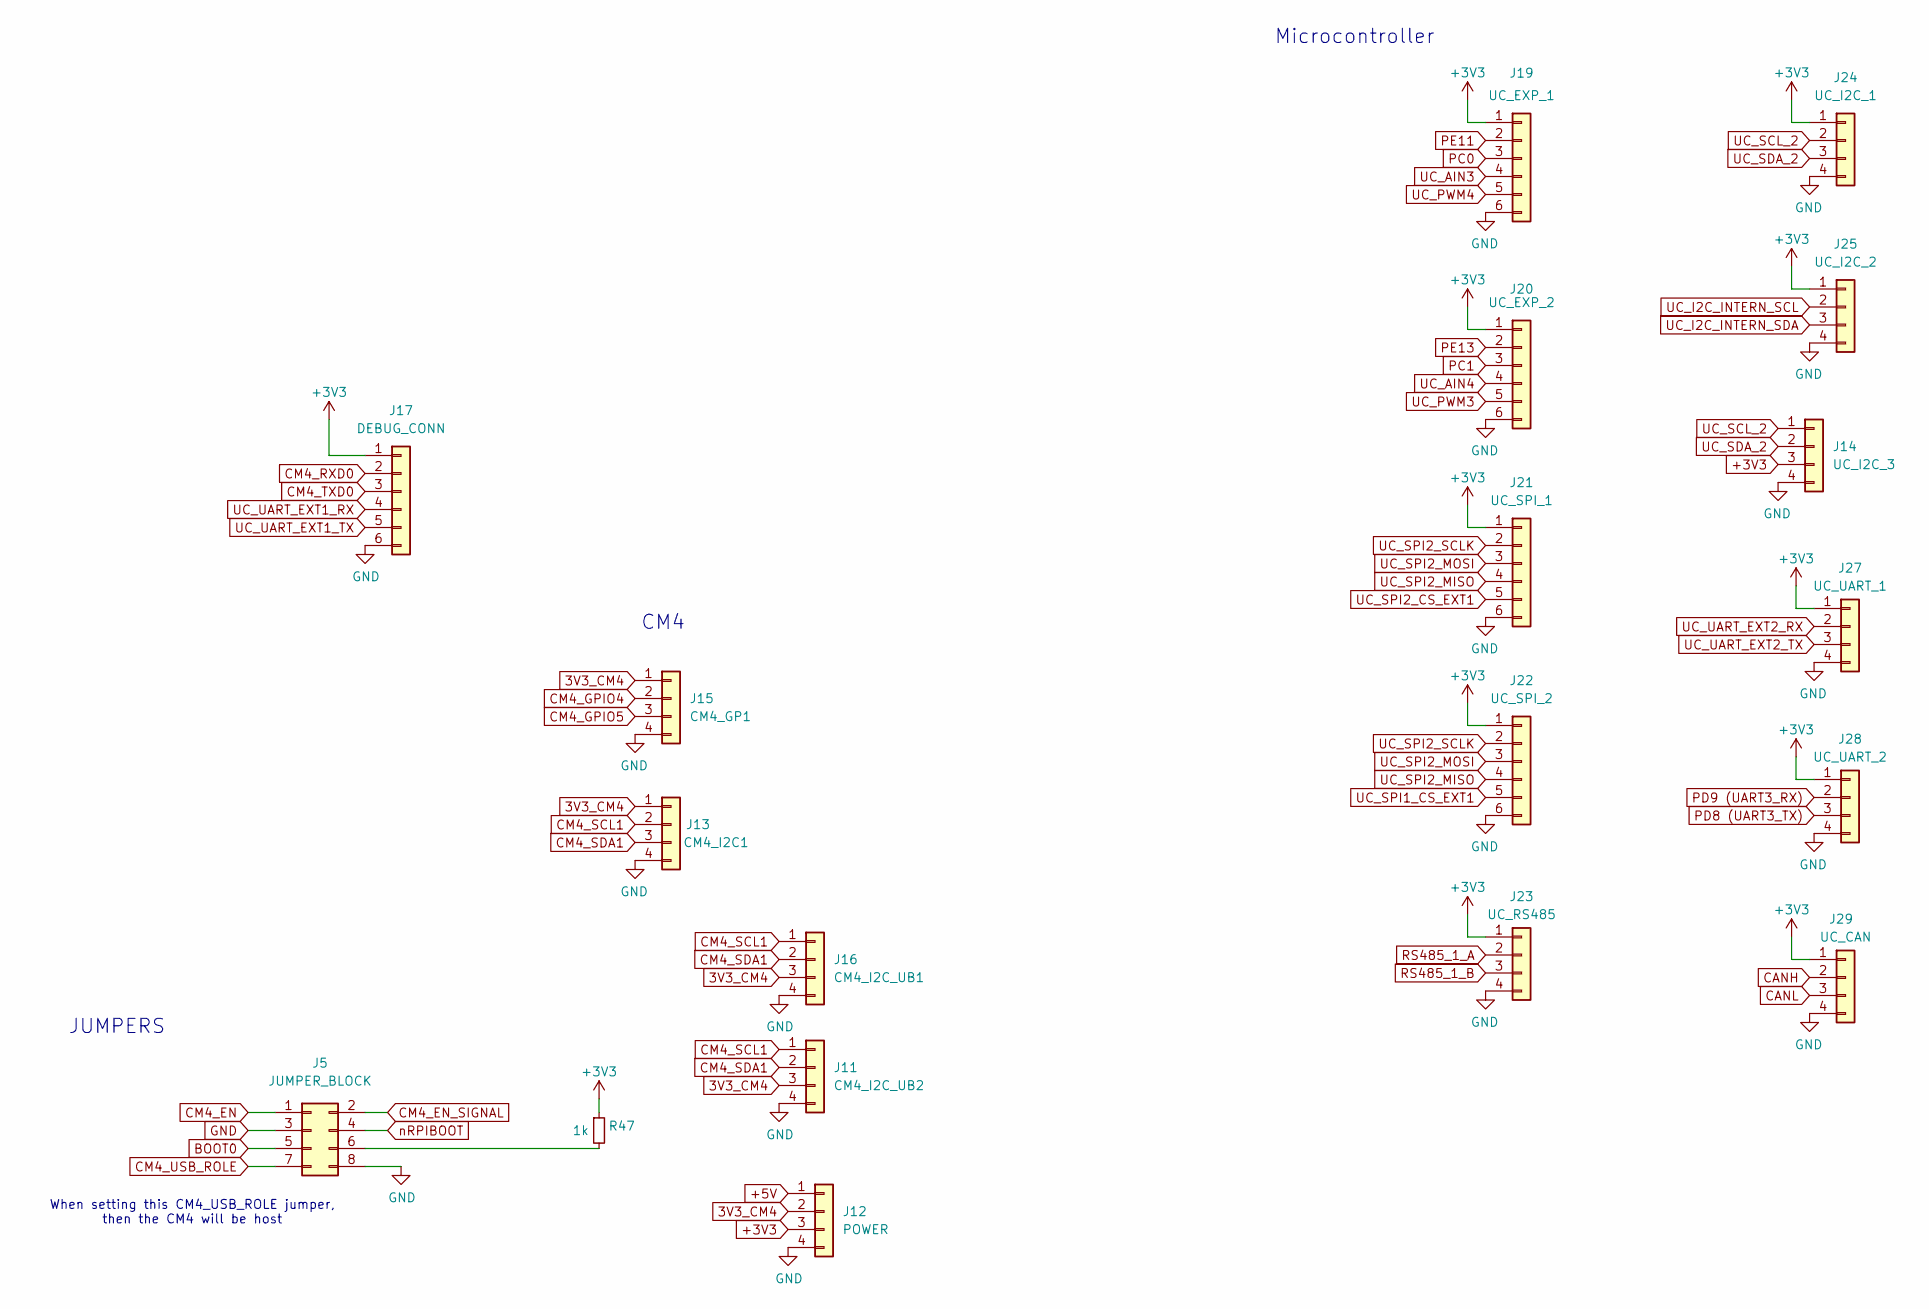
[picture p57: schematic connectors.kicad_sch]

Parts:
J5: JUMPER_BLOCK; PinHeader_2x04_P2.54mm_Vertical
J11: CM4_I2C_UB2; JST_SH_SM04B-SRSS-TB_1x04-1MP_P1.00mm_Horizontal
J12: POWER; JST_SH_SM04B-SRSS-TB_1x04-1MP_P1.00mm_Horizontal
J13: CM4_I2C1; JST_GH_BM04B-GHS-TBT_1x04-1MP_P1.25mm_Vertical
J14: UC_I2C_3; JST_SH_SM04B-SRSS-TB_1x04-1MP_P1.00mm_Horizontal
J15: CM4_GP1; JST_GH_BM04B-GHS-TBT_1x04-1MP_P1.25mm_Vertical
J16: CM4_I2C_UB1; JST_SH_SM04B-SRSS-TB_1x04-1MP_P1.00mm_Horizontal
J17: DEBUG_CONN; JST_GH_BM06B-GHS-TBT_1x06-1MP_P1.25mm_Vertical
J19: UC_EXP_1; JST_GH_BM06B-GHS-TBT_1x06-1MP_P1.25mm_Vertical
J20: UC_EXP_2; JST_GH_BM06B-GHS-TBT_1x06-1MP_P1.25mm_Vertical
J21: UC_SPI_1; JST_GH_BM06B-GHS-TBT_1x06-1MP_P1.25mm_Vertical
J22: UC_SPI_2; JST_GH_BM06B-GHS-TBT_1x06-1MP_P1.25mm_Vertical
J23: UC_RS485; JST_GH_BM04B-GHS-TBT_1x04-1MP_P1.25mm_Vertical
J24: UC_I2C_1; JST_GH_BM04B-GHS-TBT_1x04-1MP_P1.25mm_Vertical
J25: UC_I2C_2; JST_GH_BM04B-GHS-TBT_1x04-1MP_P1.25mm_Vertical
J27: UC_UART_1; JST_GH_BM04B-GHS-TBT_1x04-1MP_P1.25mm_Vertical
J28: UC_UART_2; JST_GH_BM04B-GHS-TBT_1x04-1MP_P1.25mm_Vertical
J29: UC_CAN; JST_GH_BM04B-GHS-TBT_1x04-1MP_P1.25mm_Vertical
R47: 1k; R_0603_1608Metric

Connections:
3V3_CM4: J11.3, J12.2, J13.1, J15.1, J16.3
+3V3: J12.3, J14.3, J17.1, J19.1, J20.1, J21.1, J22.1, J23.1, J24.1, J25.1, J27.1, J28.1, J29.1, R47.1
+5V: J12.1
BOOT0: J5.5
CANH: J29.2
CANL: J29.3
CM4_EN: J5.1
CM4_EN_SIGNAL: J5.2
CM4_GPIO4: J15.2
CM4_GPIO5: J15.3
CM4_RXD0: J17.2
CM4_SCL1: J11.1, J13.2, J16.1
CM4_SDA1: J11.2, J13.3, J16.2
CM4_TXD0: J17.3
CM4_USB_ROLE: J5.7
GND: J5.3, J5.8, J11.4, J12.4, J13.4, J14.4, J15.4, J16.4, J17.6, J19.6, J20.6, J21.6, J22.6, J23.4, J24.4, J25.4, J27.4, J28.4, J29.4
unnamed: J5.6, R47.2
PC0: J19.3
PC1: J20.3
PD8 (UART3_TX): J28.3
PD9 (UART3_RX): J28.2
PE11: J19.2
PE13: J20.2
RS485_1_A: J23.2
RS485_1_B: J23.3
UC_AIN3: J19.4
UC_AIN4: J20.4
UC_I2C_INTERN_SCL: J25.2
UC_I2C_INTERN_SDA: J25.3
UC_PWM3: J20.5
UC_PWM4: J19.5
UC_SCL_2: J14.1, J24.2
UC_SDA_2: J14.2, J24.3
UC_SPI1_CS_EXT1: J22.5
UC_SPI2_CS_EXT1: J21.5
UC_SPI2_MISO: J21.4, J22.4
UC_SPI2_MOSI: J21.3, J22.3
UC_SPI2_SCLK: J21.2, J22.2
UC_UART_EXT1_RX: J17.4
UC_UART_EXT1_TX: J17.5
UC_UART_EXT2_RX: J27.2
UC_UART_EXT2_TX: J27.3
nRPIBOOT: J5.4

Notes on the sheet:
When setting this CM4_USB_ROLE jumper, then the CM4 will be host
JUMPERS
CM4
Microcontroller
