dustin-lehmann/TWIPR/electronics/control/rev4/robot-hub_rev4/connectors_1.kicad_sch

## KiCad design electronics/control/rev4/robot-hub_rev4/connectors_1.kicad_sch (2024-07-17)

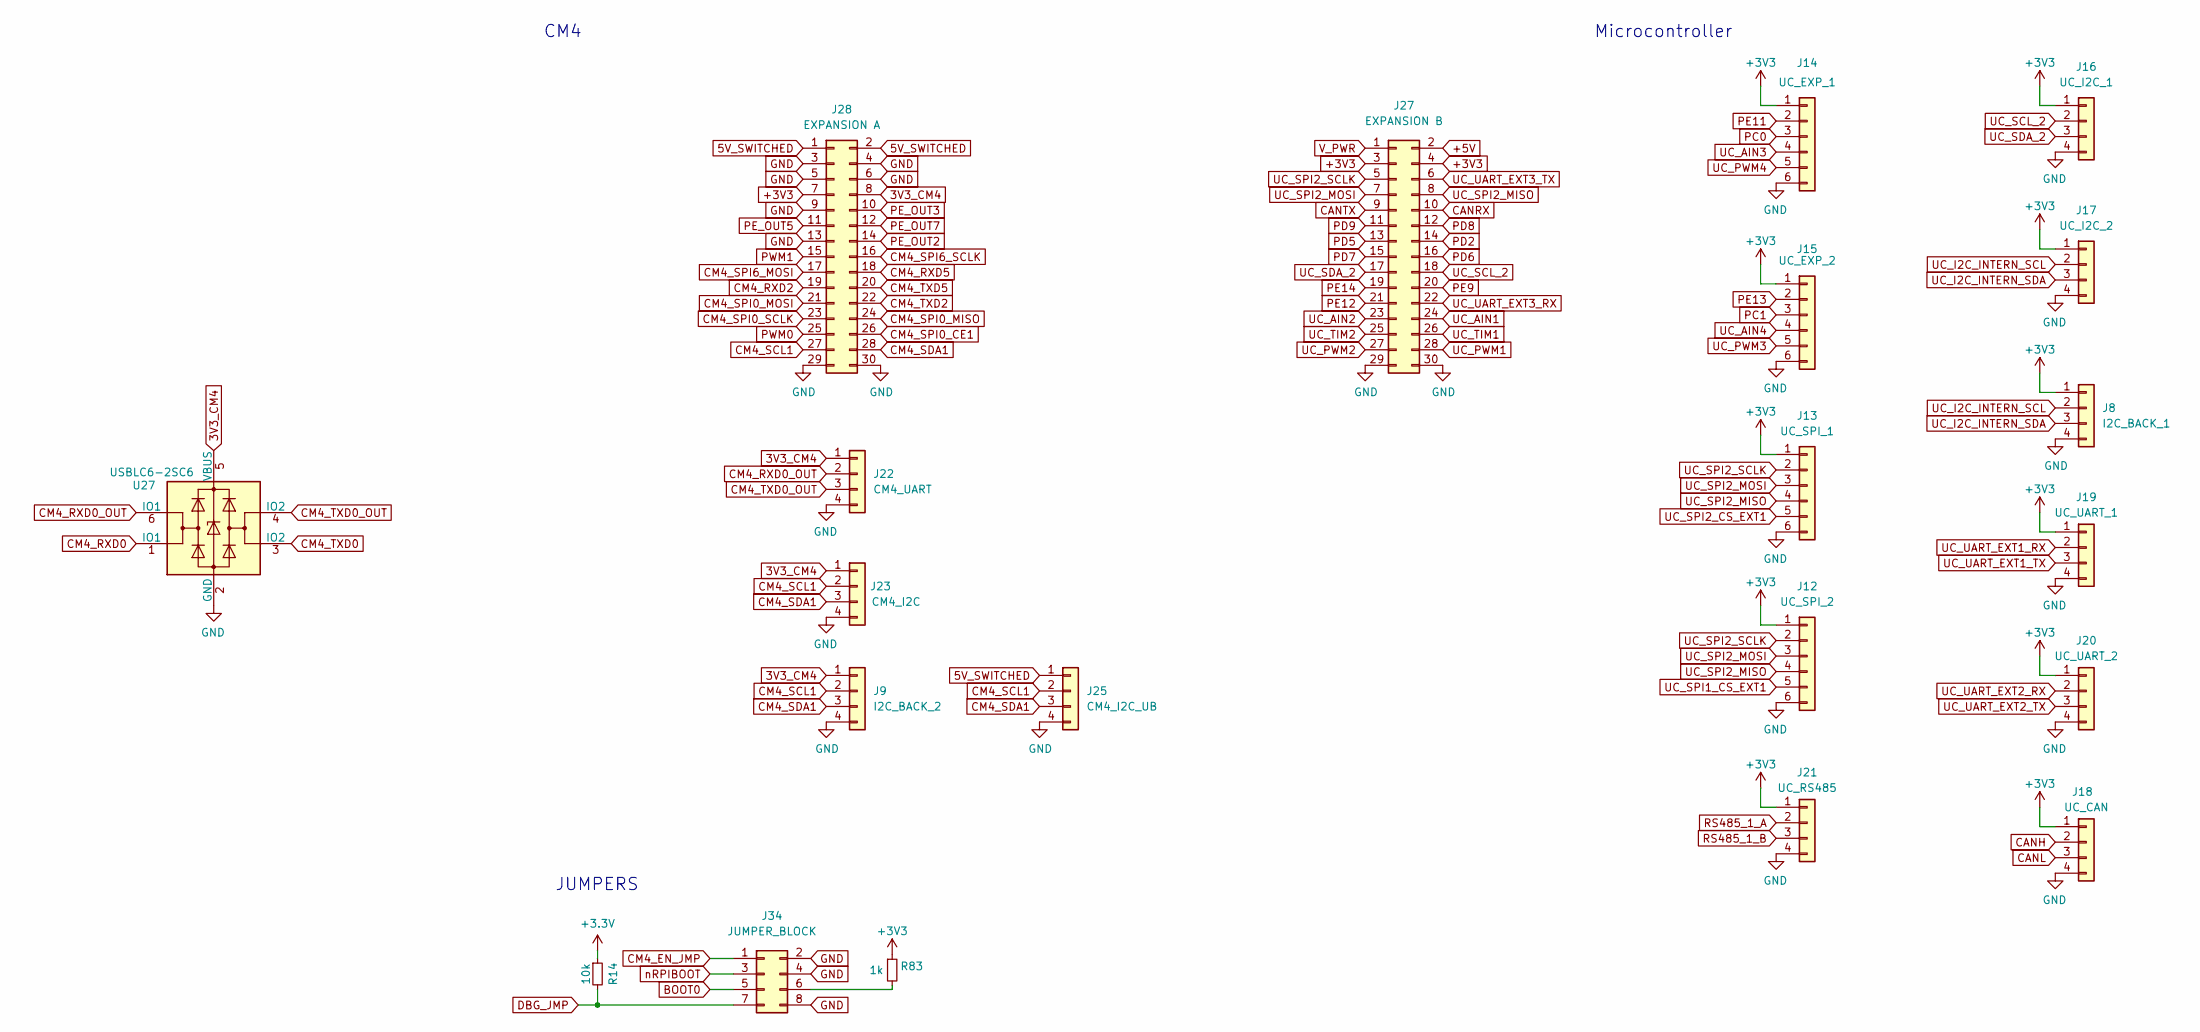
[picture p58: schematic connectors_1.kicad_sch]

Parts:
J8: I2C_BACK_1; JST_SH_SM04B-SRSS-TB_1x04-1MP_P1.00mm_Horizontal
J9: I2C_BACK_2; JST_SH_SM04B-SRSS-TB_1x04-1MP_P1.00mm_Horizontal
J12: UC_SPI_2; JST_GH_BM06B-GHS-TBT_1x06-1MP_P1.25mm_Vertical
J13: UC_SPI_1; JST_GH_BM06B-GHS-TBT_1x06-1MP_P1.25mm_Vertical
J14: UC_EXP_1; JST_GH_BM06B-GHS-TBT_1x06-1MP_P1.25mm_Vertical
J15: UC_EXP_2; JST_GH_BM06B-GHS-TBT_1x06-1MP_P1.25mm_Vertical
J16: UC_I2C_1; JST_GH_BM04B-GHS-TBT_1x04-1MP_P1.25mm_Vertical
J17: UC_I2C_2; JST_GH_BM04B-GHS-TBT_1x04-1MP_P1.25mm_Vertical
J18: UC_CAN; JST_GH_BM04B-GHS-TBT_1x04-1MP_P1.25mm_Vertical
J19: UC_UART_1; JST_GH_BM04B-GHS-TBT_1x04-1MP_P1.25mm_Vertical
J20: UC_UART_2; JST_GH_BM04B-GHS-TBT_1x04-1MP_P1.25mm_Vertical
J21: UC_RS485; JST_GH_BM04B-GHS-TBT_1x04-1MP_P1.25mm_Vertical
J22: CM4_UART; JST_GH_BM04B-GHS-TBT_1x04-1MP_P1.25mm_Vertical
J23: CM4_I2C; JST_GH_BM04B-GHS-TBT_1x04-1MP_P1.25mm_Vertical
J25: CM4_I2C_UB; JST_SH_SM04B-SRSS-TB_1x04-1MP_P1.00mm_Horizontal
J27: EXPANSION B; PinHeader_2x15_P2.54mm_Vertical
J28: EXPANSION A; PinHeader_2x15_P2.54mm_Vertical
J34: JUMPER_BLOCK; PinHeader_2x04_P2.00mm_Vertical
R14: 10k; R_0603_1608Metric
R83: 1k; R_0603_1608Metric
U27: USBLC6-2SC6; SOT-23-6

Connections:
3V3_CM4: J9.1, J22.1, J23.1, J28.8, U27.5 (VBUS)
5V_SWITCHED: J25.1, J28.1, J28.2
+3.3V: R14.1
+3V3: J8.1, J12.1, J13.1, J14.1, J15.1, J16.1, J17.1, J18.1, J19.1, J20.1, J21.1, J27.3, J27.4, J28.7, R83.1
+5V: J27.2
BOOT0: J34.5
CANH: J18.2
CANL: J18.3
CANRX: J27.10
CANTX: J27.9
CM4_EN_JMP: J34.1
CM4_RXD0: U27.1 (IO1)
CM4_RXD0_OUT: J22.2, U27.6 (IO1)
CM4_RXD2: J28.19
CM4_RXD5: J28.18
CM4_SCL1: J9.2, J23.2, J25.2, J28.27
CM4_SDA1: J9.3, J23.3, J25.3, J28.28
CM4_SPI0_CE1: J28.26
CM4_SPI0_MISO: J28.24
CM4_SPI0_MOSI: J28.21
CM4_SPI0_SCLK: J28.23
CM4_SPI6_MOSI: J28.17
CM4_SPI6_SCLK: J28.16
CM4_TXD0: U27.3 (IO2)
CM4_TXD0_OUT: J22.3, U27.4 (IO2)
CM4_TXD2: J28.22
CM4_TXD5: J28.20
DBG_JMP: J34.7, R14.2
GND: J8.4, J9.4, J12.6, J13.6, J14.6, J15.6, J16.4, J17.4, J18.4, J19.4, J20.4, J21.4, J22.4, J23.4, J25.4, J27.29, J27.30, J28.3, J28.4, J28.5, J28.6, J28.9, J28.13, J28.29, J28.30, J34.2, J34.4, J34.8, U27.2 (GND)
unnamed: J34.6, R83.2
PC0: J14.3
PC1: J15.3
PD2: J27.14
PD5: J27.13
PD6: J27.16
PD7: J27.15
PD8: J27.12
PD9: J27.11
PE9: J27.20
PE11: J14.2
PE12: J27.21
PE13: J15.2
PE14: J27.19
PE_OUT2: J28.14
PE_OUT3: J28.10
PE_OUT5: J28.11
PE_OUT7: J28.12
PWM0: J28.25
PWM1: J28.15
RS485_1_A: J21.2
RS485_1_B: J21.3
UC_AIN1: J27.24
UC_AIN2: J27.23
UC_AIN3: J14.4
UC_AIN4: J15.4
UC_I2C_INTERN_SCL: J8.2, J17.2
UC_I2C_INTERN_SDA: J8.3, J17.3
UC_PWM1: J27.28
UC_PWM2: J27.27
UC_PWM3: J15.5
UC_PWM4: J14.5
UC_SCL_2: J16.2, J27.18
UC_SDA_2: J16.3, J27.17
UC_SPI1_CS_EXT1: J12.5
UC_SPI2_CS_EXT1: J13.5
UC_SPI2_MISO: J12.4, J13.4, J27.8
UC_SPI2_MOSI: J12.3, J13.3, J27.7
UC_SPI2_SCLK: J12.2, J13.2, J27.5
UC_TIM1: J27.26
UC_TIM2: J27.25
UC_UART_EXT1_RX: J19.2
UC_UART_EXT1_TX: J19.3
UC_UART_EXT2_RX: J20.2
UC_UART_EXT2_TX: J20.3
UC_UART_EXT3_RX: J27.22
UC_UART_EXT3_TX: J27.6
V_PWR: J27.1
nRPIBOOT: J34.3

Notes on the sheet:
JUMPERS
CM4
Microcontroller
