dustin-lehmann/TWIPR/electronics/control/rev4/robot-hub_rev4/indicators.kicad_sch

## KiCad design electronics/control/rev4/robot-hub_rev4/indicators.kicad_sch (2024-07-17)

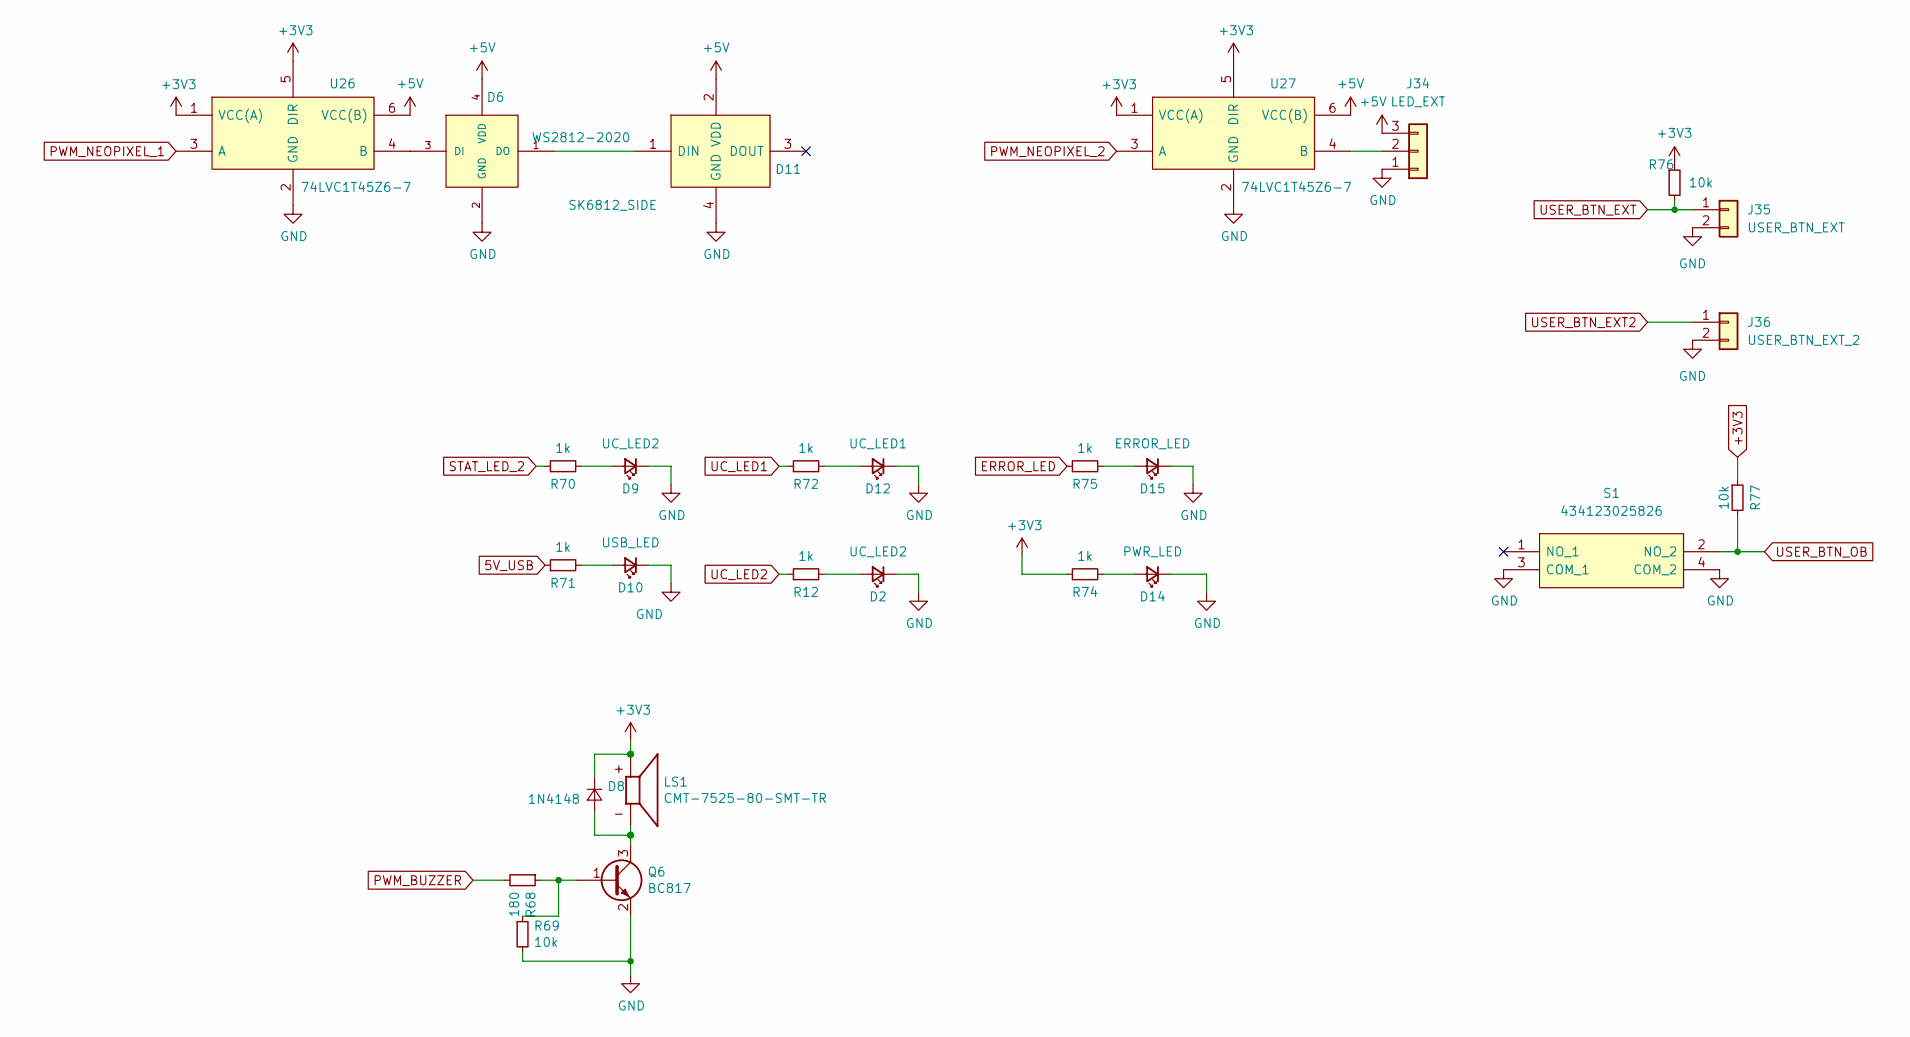
[picture p59: schematic indicators.kicad_sch]

Parts:
D2, D9: UC_LED2; LED_0603_1608Metric
D6: WS2812-2020; ws2812_2020
D8: 1N4148; D_SOD-323F
D10: USB_LED; LED_0603_1608Metric
D11: SK6812_SIDE; SK6812SIDE; Manufacturer_Part_Number SK6812 SIDE
D12: UC_LED1; LED_0603_1608Metric
D14: PWR_LED; LED_0603_1608Metric
D15: ERROR_LED; LED_0603_1608Metric
J34: LED_EXT; JST_GH_BM03B-GHS-TBT_1x03-1MP_P1.25mm_Vertical
J35: USER_BTN_EXT; JST_GH_BM02B-GHS-TBT_1x02-1MP_P1.25mm_Vertical
J36: USER_BTN_EXT_2; JST_GH_BM02B-GHS-TBT_1x02-1MP_P1.25mm_Vertical
LS1: CMT-7525-80-SMT-TR; XDCR_CMT-7525-80-SMT-TR
Q6: BC817; SOT-323_SC-70
R12, R70, R71, R72, R74, R75: 1k; R_0603_1608Metric
R68: 180; R_0603_1608Metric
R69, R76, R77: 10k; R_0603_1608Metric
S1: 434123025826; Manufacturer_Part_Number 434123025826
U26, U27: 74LVC1T45Z6-7; SOT-563; Mouser Part Number 621-74LVC1T45Z6-7

Connections:
5V_USB: R71.1
+3V3: D8.1 (K), LS1.P, R74.1, R76.1, R77.1, U26.1 (VCC(A)), U26.5 (DIR), U27.1 (VCC(A)), U27.5 (DIR)
+5V: D6.4 (VDD), D11.2 (VDD), J34.3, U26.6 (VCC(B)), U27.6 (VCC(B))
ERROR_LED: R75.1
GND: D2.1 (K), D6.2 (GND), D9.1 (K), D10.1 (K), D11.4 (GND), D12.1 (K), D14.1 (K), D15.1 (K), J34.1, J35.2, J36.2, Q6.2 (E), R69.2, S1.3 (COM_1), S1.4 (COM_2), U26.2 (GND), U27.2 (GND)
unnamed: D2.2 (A), R12.2
unnamed: D6.3 (DI), U26.4 (B)
unnamed: D8.2 (A), LS1.N, Q6.3 (C)
unnamed: D9.2 (A), R70.2
unnamed: D10.2 (A), R71.2
unnamed: D6.1 (DO), D11.1 (DIN)
unnamed: D12.2 (A), R72.2
unnamed: D14.2 (A), R74.2
unnamed: D15.2 (A), R75.2
unnamed: J34.2, U27.4 (B)
unnamed: Q6.1 (B), R68.1, R69.1
PWM_BUZZER: R68.2
PWM_NEOPIXEL_1: U26.3 (A)
PWM_NEOPIXEL_2: U27.3 (A)
STAT_LED_2: R70.1
UC_LED1: R72.1
UC_LED2: R12.1
USER_BTN_EXT: J35.1, R76.2
USER_BTN_EXT2: J36.1
USER_BTN_OB: R77.2, S1.2 (NO_2)
