dustin-lehmann/TWIPR/electronics/control/rev4/robot-hub_rev4/memory.kicad_sch

## KiCad design electronics/control/rev4/robot-hub_rev4/memory.kicad_sch (2024-07-17)

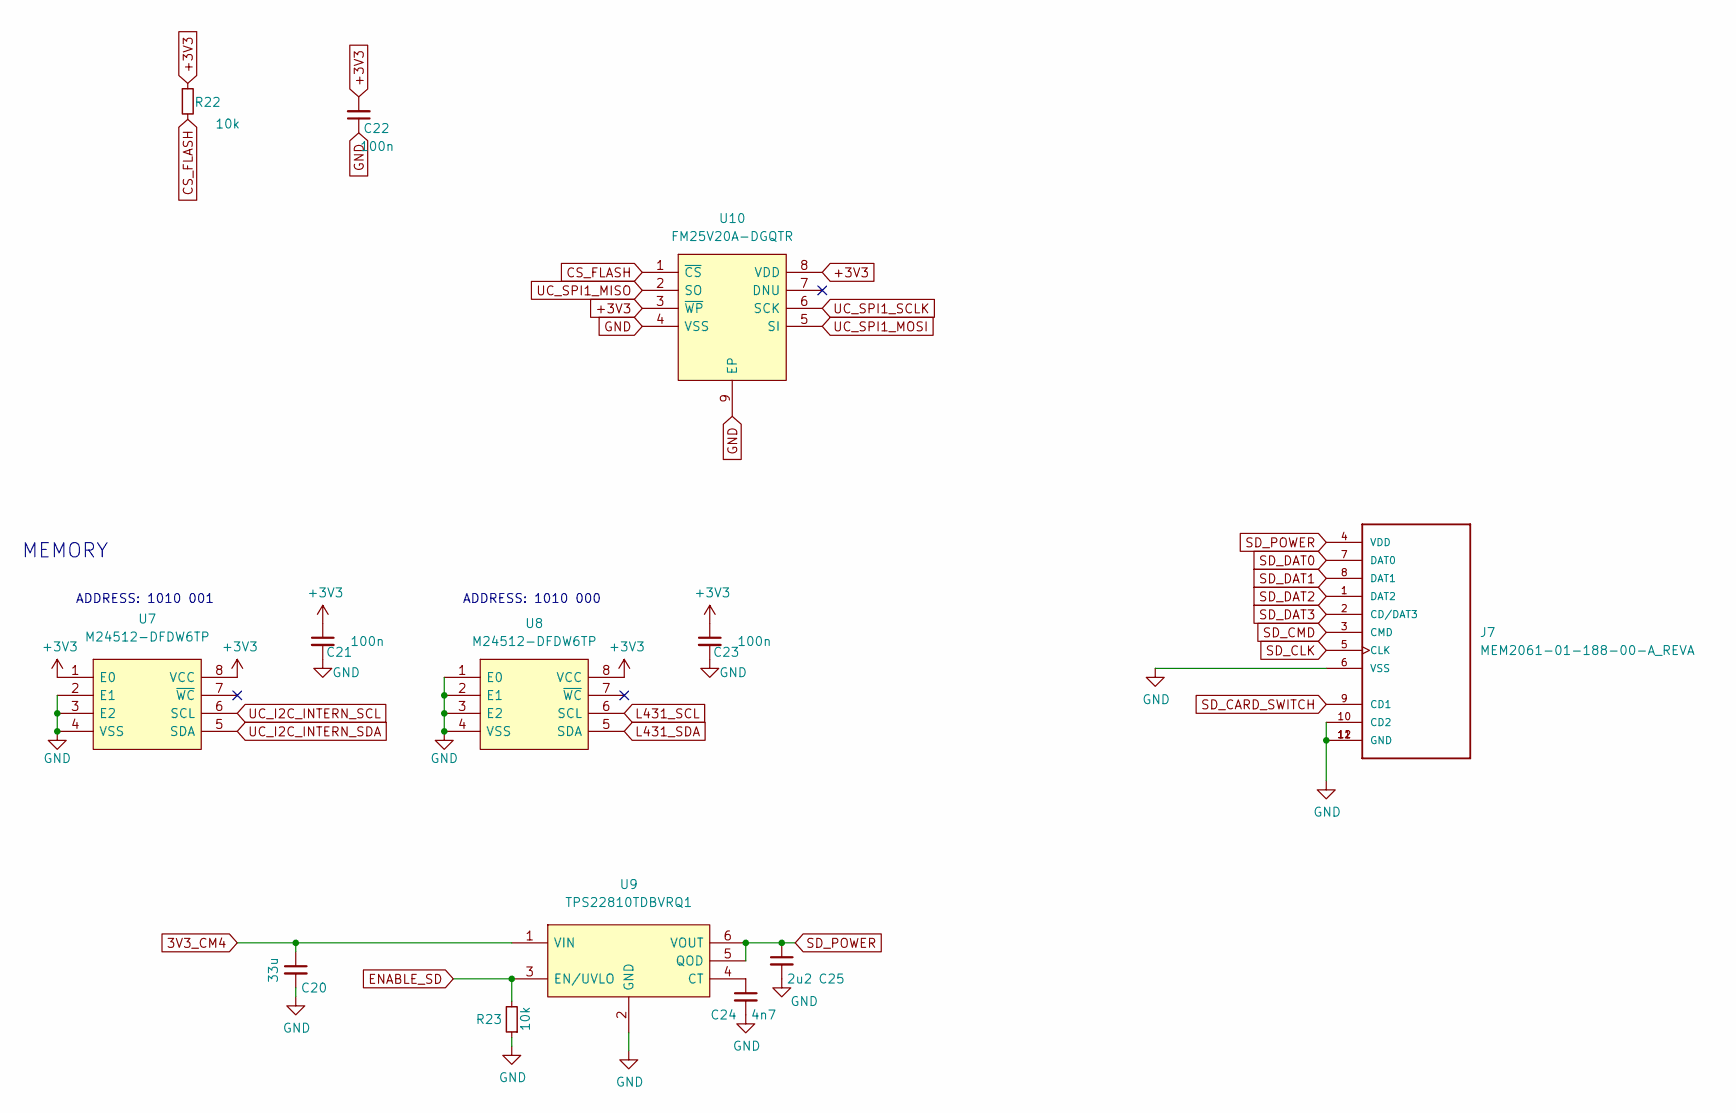
[picture p60: schematic memory.kicad_sch]

Parts:
C20: 33u; C_0805_2012Metric
C21, C22, C23: 100n; C_0603_1608Metric
C24: 4n7; C_0603_1608Metric
C25: 2u2; C_0805_2012Metric
J7: MEM2061-01-188-00-A_REVA; GCT_MEM2061-01-188-00-A_REVA
R22, R23: 10k; R_0603_1608Metric
U7, U8: M24512-DFDW6TP; SOP65P640X120-8N; Mouser Part Number 511-M24512-DFDW6TP
U9: TPS22810TDBVRQ1; SOT95P280X145-6N; Mouser Part Number 595-TPS22810TDBVRQ1
U10: FM25V20A-DGQTR; SON127P600X500X80-9N; Mouser Part Number 727-FM25V20A-DGQTR

Connections:
3V3_CM4: C20.1, U9.1 (VIN)
+3V3: C21.1, C22.2, C23.1, R22.1, U7.1 (E0), U7.8 (VCC), U8.8 (VCC), U10.3 (~WP), U10.8 (VDD)
CS_FLASH: R22.2, U10.1 (~CS)
ENABLE_SD: R23.2, U9.3 (EN/UVLO)
GND: C20.2, C21.2, C22.1, C23.2, C24.2, C25.2, J7.6 (VSS), J7.10 (CD2), J7.11 (GND), J7.12 (GND), R23.1, U7.2 (E1), U7.3 (E2), U7.4 (VSS), U8.1 (E0), U8.2 (E1), U8.3 (E2), U8.4 (VSS), U9.2 (GND), U10.4 (VSS), U10.9 (EP)
L431_SCL: U8.6 (SCL)
L431_SDA: U8.5 (SDA)
unnamed: C24.1, U9.4 (CT)
SD_CARD_SWITCH: J7.9 (CD1)
SD_CLK: J7.5 (CLK)
SD_CMD: J7.3 (CMD)
SD_DAT0: J7.7 (DAT0)
SD_DAT1: J7.8 (DAT1)
SD_DAT2: J7.1 (DAT2)
SD_DAT3: J7.2 (CD/DAT3)
SD_POWER: C25.1, J7.4 (VDD), U9.5 (QOD), U9.6 (VOUT)
UC_I2C_INTERN_SCL: U7.6 (SCL)
UC_I2C_INTERN_SDA: U7.5 (SDA)
UC_SPI1_MISO: U10.2 (SO)
UC_SPI1_MOSI: U10.5 (SI)
UC_SPI1_SCLK: U10.6 (SCK)

Notes on the sheet:
ADDRESS: 1010 000
MEMORY
ADDRESS: 1010 001
