dustin-lehmann/TWIPR/electronics/control/rev4/robot-hub_rev4/microcontrollers.kicad_sch

## KiCad design electronics/control/rev4/robot-hub_rev4/microcontrollers.kicad_sch (2024-07-17)

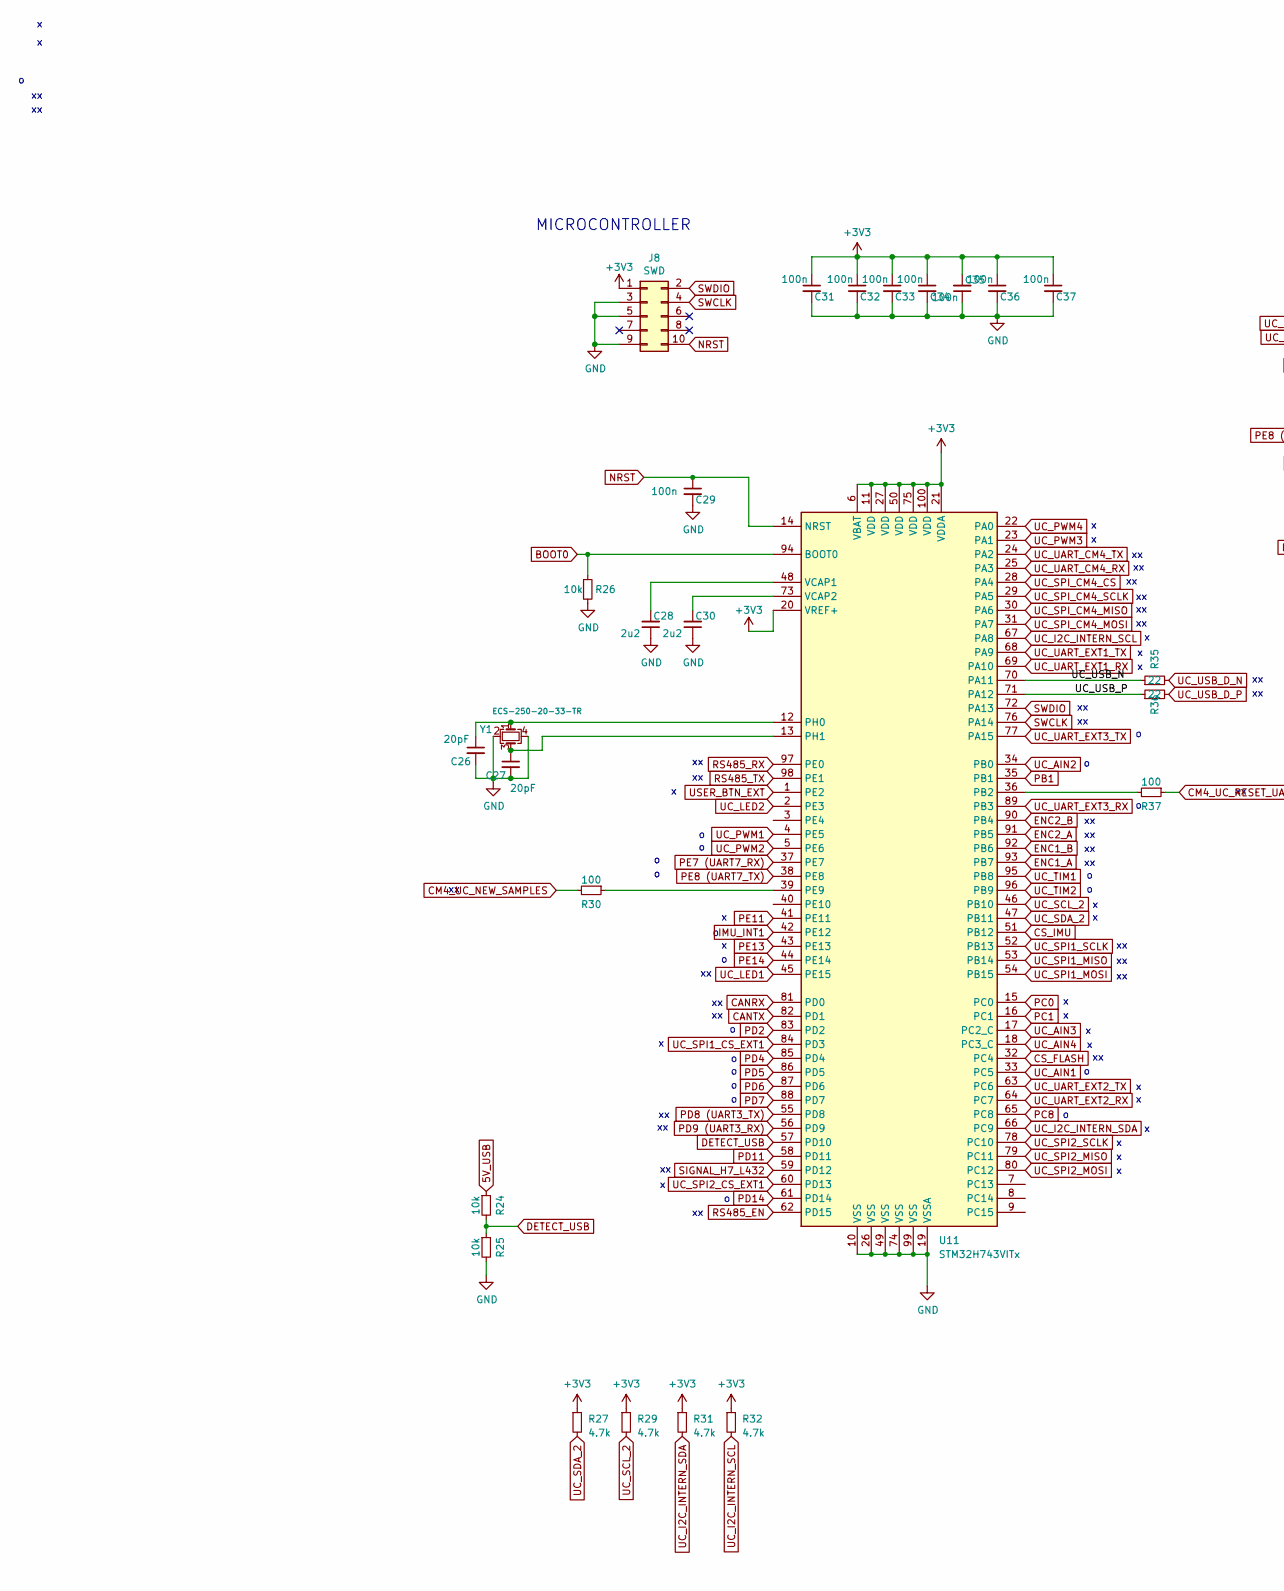
[picture p61: schematic microcontrollers.kicad_sch, part in row 1, column 1]

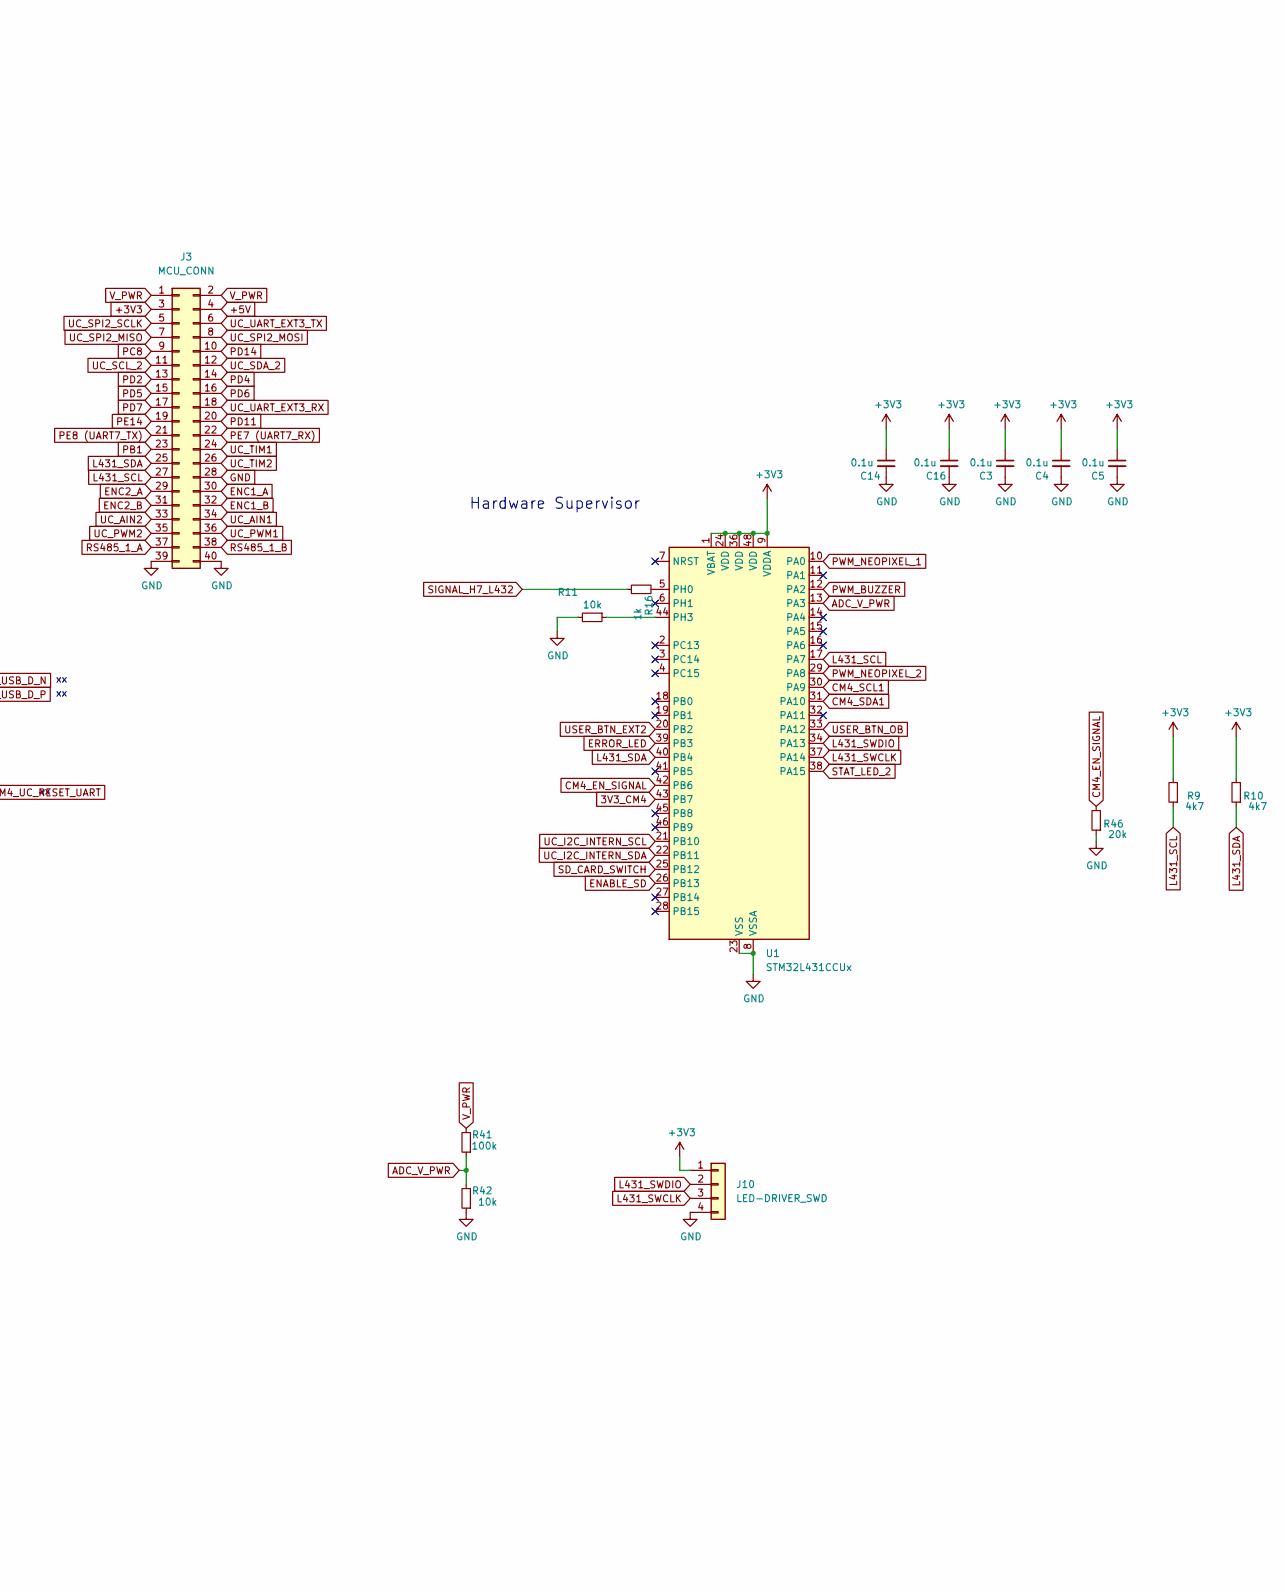
[picture p62: schematic microcontrollers.kicad_sch, part in row 1, column 2]

Parts:
C3, C4, C5, C14, C16: 0.1u; C_0603_1608Metric
C26, C27: 20pF; C_0603_1608Metric
C28, C30: 2u2; C_0805_2012Metric
C29, C31, C32, C33, C34, C35, C36, C37: 100n; C_0603_1608Metric
J3: MCU_CONN; PinHeader_2x20_P2.54mm_Vertical
J8: SWD; FTSH10501LDVK
J10: LED-DRIVER_SWD; JST_SH_SM04B-SRSS-TB_1x04-1MP_P1.00mm_Horizontal
R9, R10: 4k7; R_0603_1608Metric
R11, R24, R25, R26, R42: 10k; R_0603_1608Metric
R16: 1k; R_0603_1608Metric
R27, R29, R31, R32: 4.7k; R_0603_1608Metric
R30, R37: 100; R_0603_1608Metric
R35, R36: 22; R_0603_1608Metric
R41: 100k; R_0603_1608Metric
R46: 20k; R_0603_1608Metric
U1: STM32L431CCUx; QFN-48-1EP_7x7mm_P0.5mm_EP5.6x5.6mm
U11: STM32H743VITx; LQFP-100_14x14mm_P0.5mm
Y1: ‎ECS-250-20-33-TR‎; ECS2501833BCKYTR

Connections:
3V3_CM4: U1.43 (PB7)
5V_USB: R24.1
+3V3: C3.1, C4.1, C5.1, C14.1, C16.1, C31.1, C32.1, C33.1, C34.1, C35.2, C36.1, C37.1, J3.3, J8.1, J10.1, R9.2, R10.2, R27.1, R29.1, R31.1, R32.1, U1.1 (VBAT), U1.9 (VDDA), U1.24 (VDD), U1.36 (VDD), U1.48 (VDD), U11.6 (VBAT), U11.11 (VDD), U11.20 (VREF+), U11.21 (VDDA), U11.27 (VDD), U11.50 (VDD), U11.75 (VDD), U11.100 (VDD)
+5V: J3.4
ADC_V_PWR: R41.1, R42.2, U1.13 (PA3)
BOOT0: R26.1, U11.94 (BOOT0)
CANRX: U11.81 (PD0)
CANTX: U11.82 (PD1)
CM4_EN_SIGNAL: R46.2, U1.42 (PB6)
CM4_SCL1: U1.30 (PA9)
CM4_SDA1: U1.31 (PA10)
CM4_UC_NEW_SAMPLES: R30.2
CM4_UC_RESET_UART: R37.1
CS_FLASH: U11.32 (PC4)
CS_IMU: U11.51 (PB12)
DETECT_USB: R24.2, R25.1, U11.57 (PD10)
ENABLE_SD: U1.26 (PB13)
ENC1_A: J3.30, U11.93 (PB7)
ENC1_B: J3.32, U11.92 (PB6)
ENC2_A: J3.29, U11.91 (PB5)
ENC2_B: J3.31, U11.90 (PB4)
ERROR_LED: U1.39 (PB3)
GND: C3.2, C4.2, C5.2, C14.2, C16.2, C26.2, C27.2, C28.1, C29.2, C30.1, C31.2, C32.2, C33.2, C34.2, C35.1, C36.2, C37.2, J3.28, J3.39, J3.40, J8.3, J8.5, J8.9, J10.4, R11.2, R25.2, R26.2, R42.1, R46.1, U1.8 (VSSA), U1.23 (VSS), U1.35 (VSS), U1.47 (VSS), U1.49 (VSS), U11.10 (VSS), U11.19 (VSSA), U11.26 (VSS), U11.49 (VSS), U11.74 (VSS), U11.99 (VSS), Y1.2, Y1.4
IMU_INT1: U11.42 (PE12)
L431_SCL: J3.27, R9.1, U1.17 (PA7)
L431_SDA: J3.25, R10.1, U1.40 (PB4)
L431_SWCLK: J10.3, U1.37 (PA14)
L431_SWDIO: J10.2, U1.34 (PA13)
NRST: C29.1, J8.10, U11.14 (NRST)
unnamed: C26.1, U11.12 (PH0), Y1.1
unnamed: C27.1, U11.13 (PH1), Y1.3
unnamed: C28.2, U11.48 (VCAP1)
unnamed: C30.2, U11.73 (VCAP2)
unnamed: R11.1, U1.44 (PH3)
unnamed: R16.2, U1.5 (PH0)
unnamed: R30.1, U11.39 (PE9)
unnamed: R37.2, U11.36 (PB2)
PB1: J3.23, U11.35 (PB1)
PC0: U11.15 (PC0)
PC1: U11.16 (PC1)
PC8: J3.9, U11.65 (PC8)
PD2: J3.13, U11.83 (PD2)
PD4: J3.14, U11.85 (PD4)
PD5: J3.15, U11.86 (PD5)
PD6: J3.16, U11.87 (PD6)
PD7: J3.17, U11.88 (PD7)
PD8 (UART3_TX): U11.55 (PD8)
PD9 (UART3_RX): U11.56 (PD9)
PD11: J3.20, U11.58 (PD11)
PD14: J3.10, U11.61 (PD14)
PE7 (UART7_RX): J3.22, U11.37 (PE7)
PE8 (UART7_TX): J3.21, U11.38 (PE8)
PE11: U11.41 (PE11)
PE13: U11.43 (PE13)
PE14: J3.19, U11.44 (PE14)
PWM_BUZZER: U1.12 (PA2)
PWM_NEOPIXEL_1: U1.10 (PA0)
PWM_NEOPIXEL_2: U1.29 (PA8)
RS485_1_A: J3.37
RS485_1_B: J3.38
RS485_EN: U11.62 (PD15)
RS485_RX: U11.97 (PE0)
RS485_TX: U11.98 (PE1)
SD_CARD_SWITCH: U1.25 (PB12)
SIGNAL_H7_L432: R16.1, U11.59 (PD12)
STAT_LED_2: U1.38 (PA15)
SWCLK: J8.4, U11.76 (PA14)
SWDIO: J8.2, U11.72 (PA13)
UC_AIN1: J3.34, U11.33 (PC5)
UC_AIN2: J3.33, U11.34 (PB0)
UC_AIN3: U11.17 (PC2_C)
UC_AIN4: U11.18 (PC3_C)
UC_I2C_INTERN_SCL: R32.2, U1.21 (PB10), U11.67 (PA8)
UC_I2C_INTERN_SDA: R31.2, U1.22 (PB11), U11.66 (PC9)
UC_LED1: U11.45 (PE15)
UC_LED2: U11.2 (PE3)
UC_PWM1: J3.36, U11.4 (PE5)
UC_PWM2: J3.35, U11.5 (PE6)
UC_PWM3: U11.23 (PA1)
UC_PWM4: U11.22 (PA0)
UC_SCL_2: J3.11, R29.2, U11.46 (PB10)
UC_SDA_2: J3.12, R27.2, U11.47 (PB11)
UC_SPI1_CS_EXT1: U11.84 (PD3)
UC_SPI1_MISO: U11.53 (PB14)
UC_SPI1_MOSI: U11.54 (PB15)
UC_SPI1_SCLK: U11.52 (PB13)
UC_SPI2_CS_EXT1: U11.60 (PD13)
UC_SPI2_MISO: J3.7, U11.79 (PC11)
UC_SPI2_MOSI: J3.8, U11.80 (PC12)
UC_SPI2_SCLK: J3.5, U11.78 (PC10)
UC_SPI_CM4_CS: U11.28 (PA4)
UC_SPI_CM4_MISO: U11.30 (PA6)
UC_SPI_CM4_MOSI: U11.31 (PA7)
UC_SPI_CM4_SCLK: U11.29 (PA5)
UC_TIM1: J3.24, U11.95 (PB8)
UC_TIM2: J3.26, U11.96 (PB9)
UC_UART_CM4_RX: U11.25 (PA3)
UC_UART_CM4_TX: U11.24 (PA2)
UC_UART_EXT1_RX: U11.69 (PA10)
UC_UART_EXT1_TX: U11.68 (PA9)
UC_UART_EXT2_RX: U11.64 (PC7)
UC_UART_EXT2_TX: U11.63 (PC6)
UC_UART_EXT3_RX: J3.18, U11.89 (PB3)
UC_UART_EXT3_TX: J3.6, U11.77 (PA15)
UC_USB_D_N: R35.2
UC_USB_D_P: R36.2
UC_USB_N: R35.1, U11.70 (PA11)
UC_USB_P: R36.1, U11.71 (PA12)
USER_BTN_EXT: U11.1 (PE2)
USER_BTN_EXT2: U1.20 (PB2)
USER_BTN_OB: U1.33 (PA12)
V_PWR: J3.1, J3.2, R41.2

Notes on the sheet:
MICROCONTROLLER
Hardware Supervisor
