dustin-lehmann/TWIPR/electronics/control/rev4/robot-hub_rev4/power.kicad_sch

## KiCad design electronics/control/rev4/robot-hub_rev4/power.kicad_sch (2024-07-17)

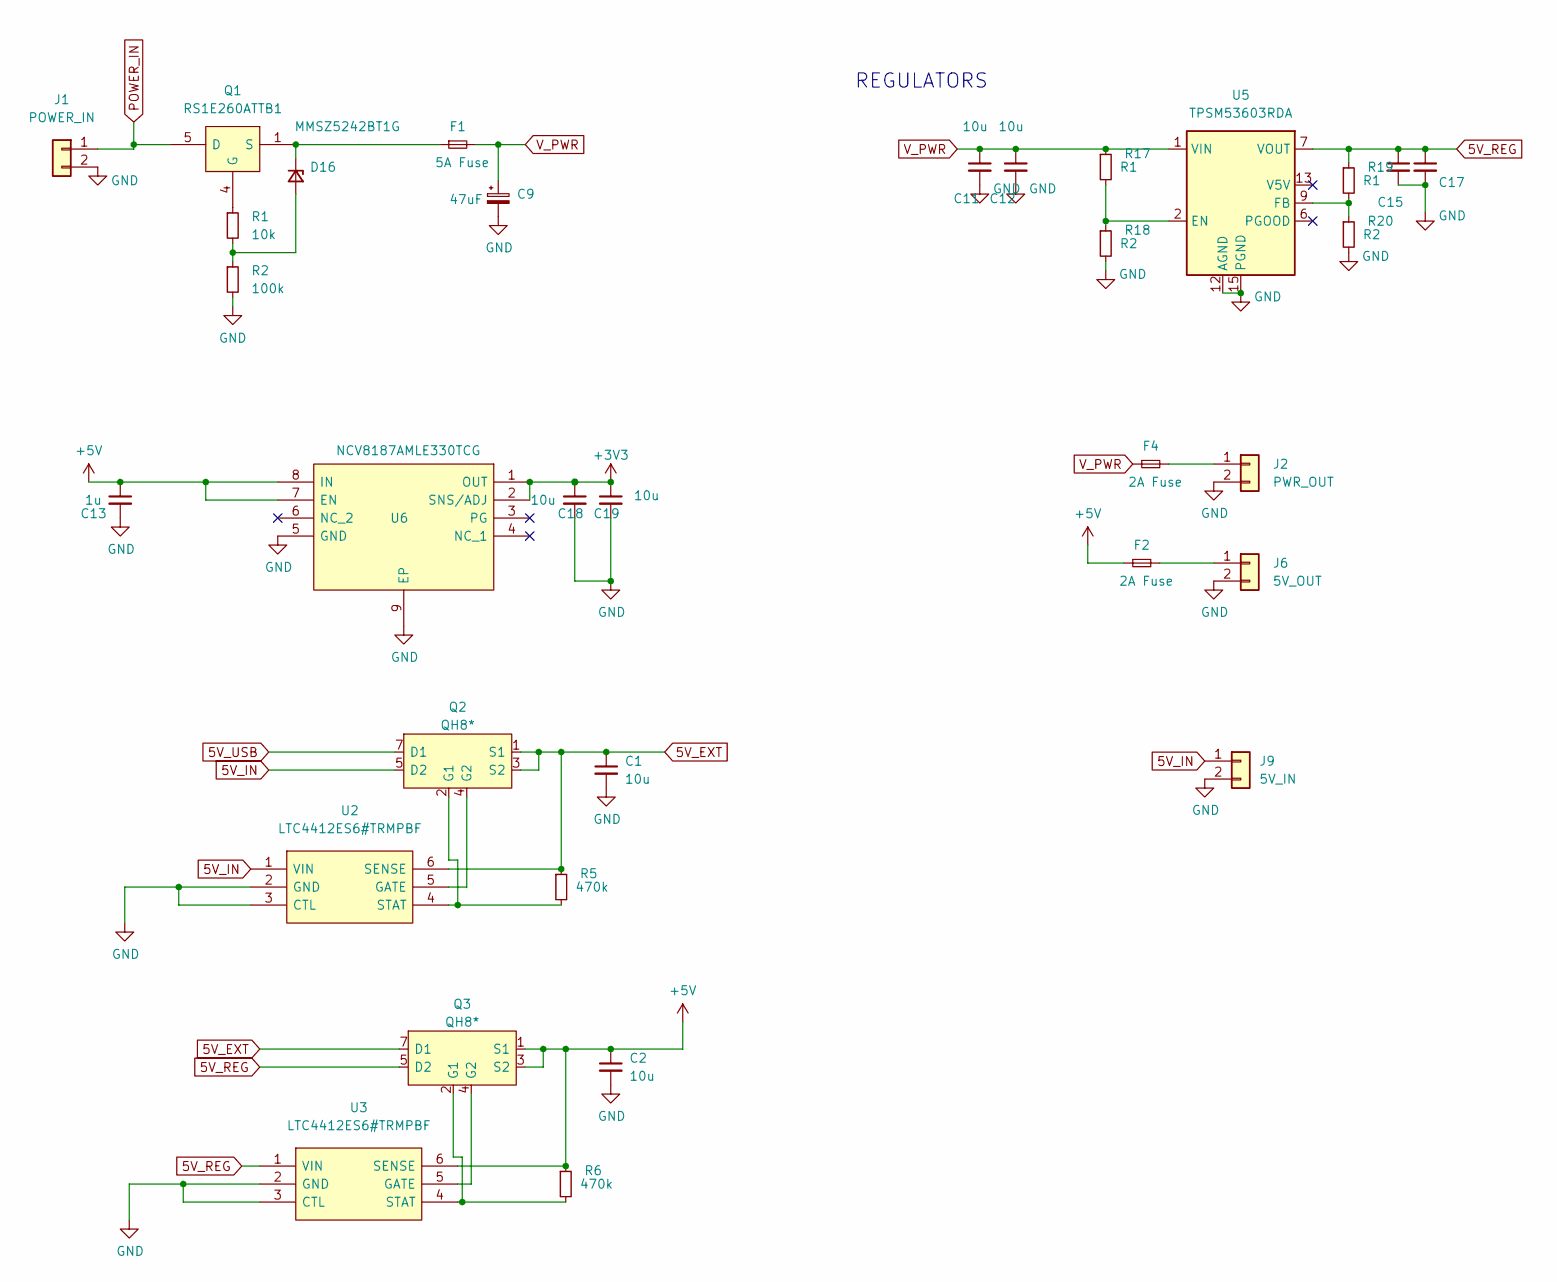
[picture p63: schematic power.kicad_sch]

Parts:
C1, C2, C18, C19: 10u; C_0805_2012Metric
C9: 47uF; CP_Elec_6.3x5.2
C11, C12: 10u; C_1210_3225Metric
C13: 1u; C_0805_2012Metric
C15, C17: C_Small; C_1210_3225Metric
D16: MMSZ5242BT1G; D_SOD-123
F1: 5A Fuse; Fuse_1206_3216Metric
F2, F4: 2A Fuse; Fuse_1206_3216Metric
J1: POWER_IN; 691322110002
J2: PWR_OUT; JST_PH_B2B-PH-K_1x02_P2.00mm_Vertical
J6: 5V_OUT; JST_PH_B2B-PH-K_1x02_P2.00mm_Vertical
J9: 5V_IN; JST_PH_B2B-PH-K_1x02_P2.00mm_Vertical
Q1: RS1E260ATTB1; Mouser Part Number 755-RS1E260ATTB1
Q2, Q3: QH8*; SOTFL65P280X85-8N; Mouser Part Number 755-QS8J13TR
R1: 10k; R_0603_1608Metric
R2: 100k; R_0603_1608Metric
R5, R6: 470k; R_0603_1608Metric
R17, R19: R1; R_0603_1608Metric
R18, R20: R2; R_0603_1608Metric
U2, U3: LTC4412ES6#TRMPBF; SOT95P280X100-6N; Mouser Part Number 584-LTC4412ES6TRMPBF
U5: TPSM53603RDA; Texas_B3QFN-14-1EP_5x5.5mm_P0.65mm_ThermalVia
U6: NCV8187AMLE330TCG; SON65P300X300X100-9N-D; Mouser Part Number 863-CV8187AMLE330TCG

Connections:
5V_EXT: C1.1, Q2.1 (S1), Q2.3 (S2), Q3.7 (D1), Q3.8 (D1), R5.1, U2.6 (SENSE)
5V_IN: J9.1, Q2.5 (D2), Q2.6 (D2), U2.1 (VIN)
5V_REG: C15.1, C17.1, Q3.5 (D2), Q3.6 (D2), R19.1, U3.1 (VIN), U5.7 (VOUT), U5.8 (VOUT)
5V_USB: Q2.7 (D1), Q2.8 (D1)
+3V3: C18.1, C19.1, U6.1 (OUT), U6.2 (SNS/ADJ)
+5V: C2.1, C13.1, F2.1, Q3.1 (S1), Q3.3 (S2), R6.1, U3.6 (SENSE), U6.7 (EN), U6.8 (IN)
GND: C1.2, C2.2, C9.2, C11.2, C12.2, C13.2, C15.2, C17.2, C18.2, C19.2, J1.2, J2.2, J6.2, J9.2, R2.2, R18.2, R20.2, U2.2 (GND), U2.3 (CTL), U3.2 (GND), U3.3 (CTL), U5.3 (PGND), U5.10 (PGND), U5.11 (PGND), U5.12 (AGND), U5.15 (PGND), U6.5 (GND), U6.9 (EP)
unnamed: D16.1 (K), F1.1, Q1.1 (S), Q1.2 (S), Q1.3 (S)
unnamed: D16.2 (A), R1.2, R2.1
unnamed: F2.2, J6.1
unnamed: F4.2, J2.1
unnamed: Q1.4 (G), R1.1
unnamed: Q2.2 (G1), R5.2, U2.4 (STAT)
unnamed: Q2.4 (G2), U2.5 (GATE)
unnamed: Q3.2 (G1), R6.2, U3.4 (STAT)
unnamed: Q3.4 (G2), U3.5 (GATE)
unnamed: R17.2, R18.1, U5.2 (EN)
unnamed: R19.2, R20.1, U5.9 (FB)
POWER_IN: J1.1, Q1.5 (D), Q1.6 (D), Q1.7 (D), Q1.8 (D), Q1.9 (D)
V_PWR: C9.1, C11.1, C12.1, F1.2, F4.1, R17.1, U5.1 (VIN), U5.14 (VIN)

Notes on the sheet:
REGULATORS
