dustin-lehmann/TWIPR/electronics/control/rev4/robot-hub_rev4/raspberry.kicad_sch

## KiCad design electronics/control/rev4/robot-hub_rev4/raspberry.kicad_sch (2024-07-17)

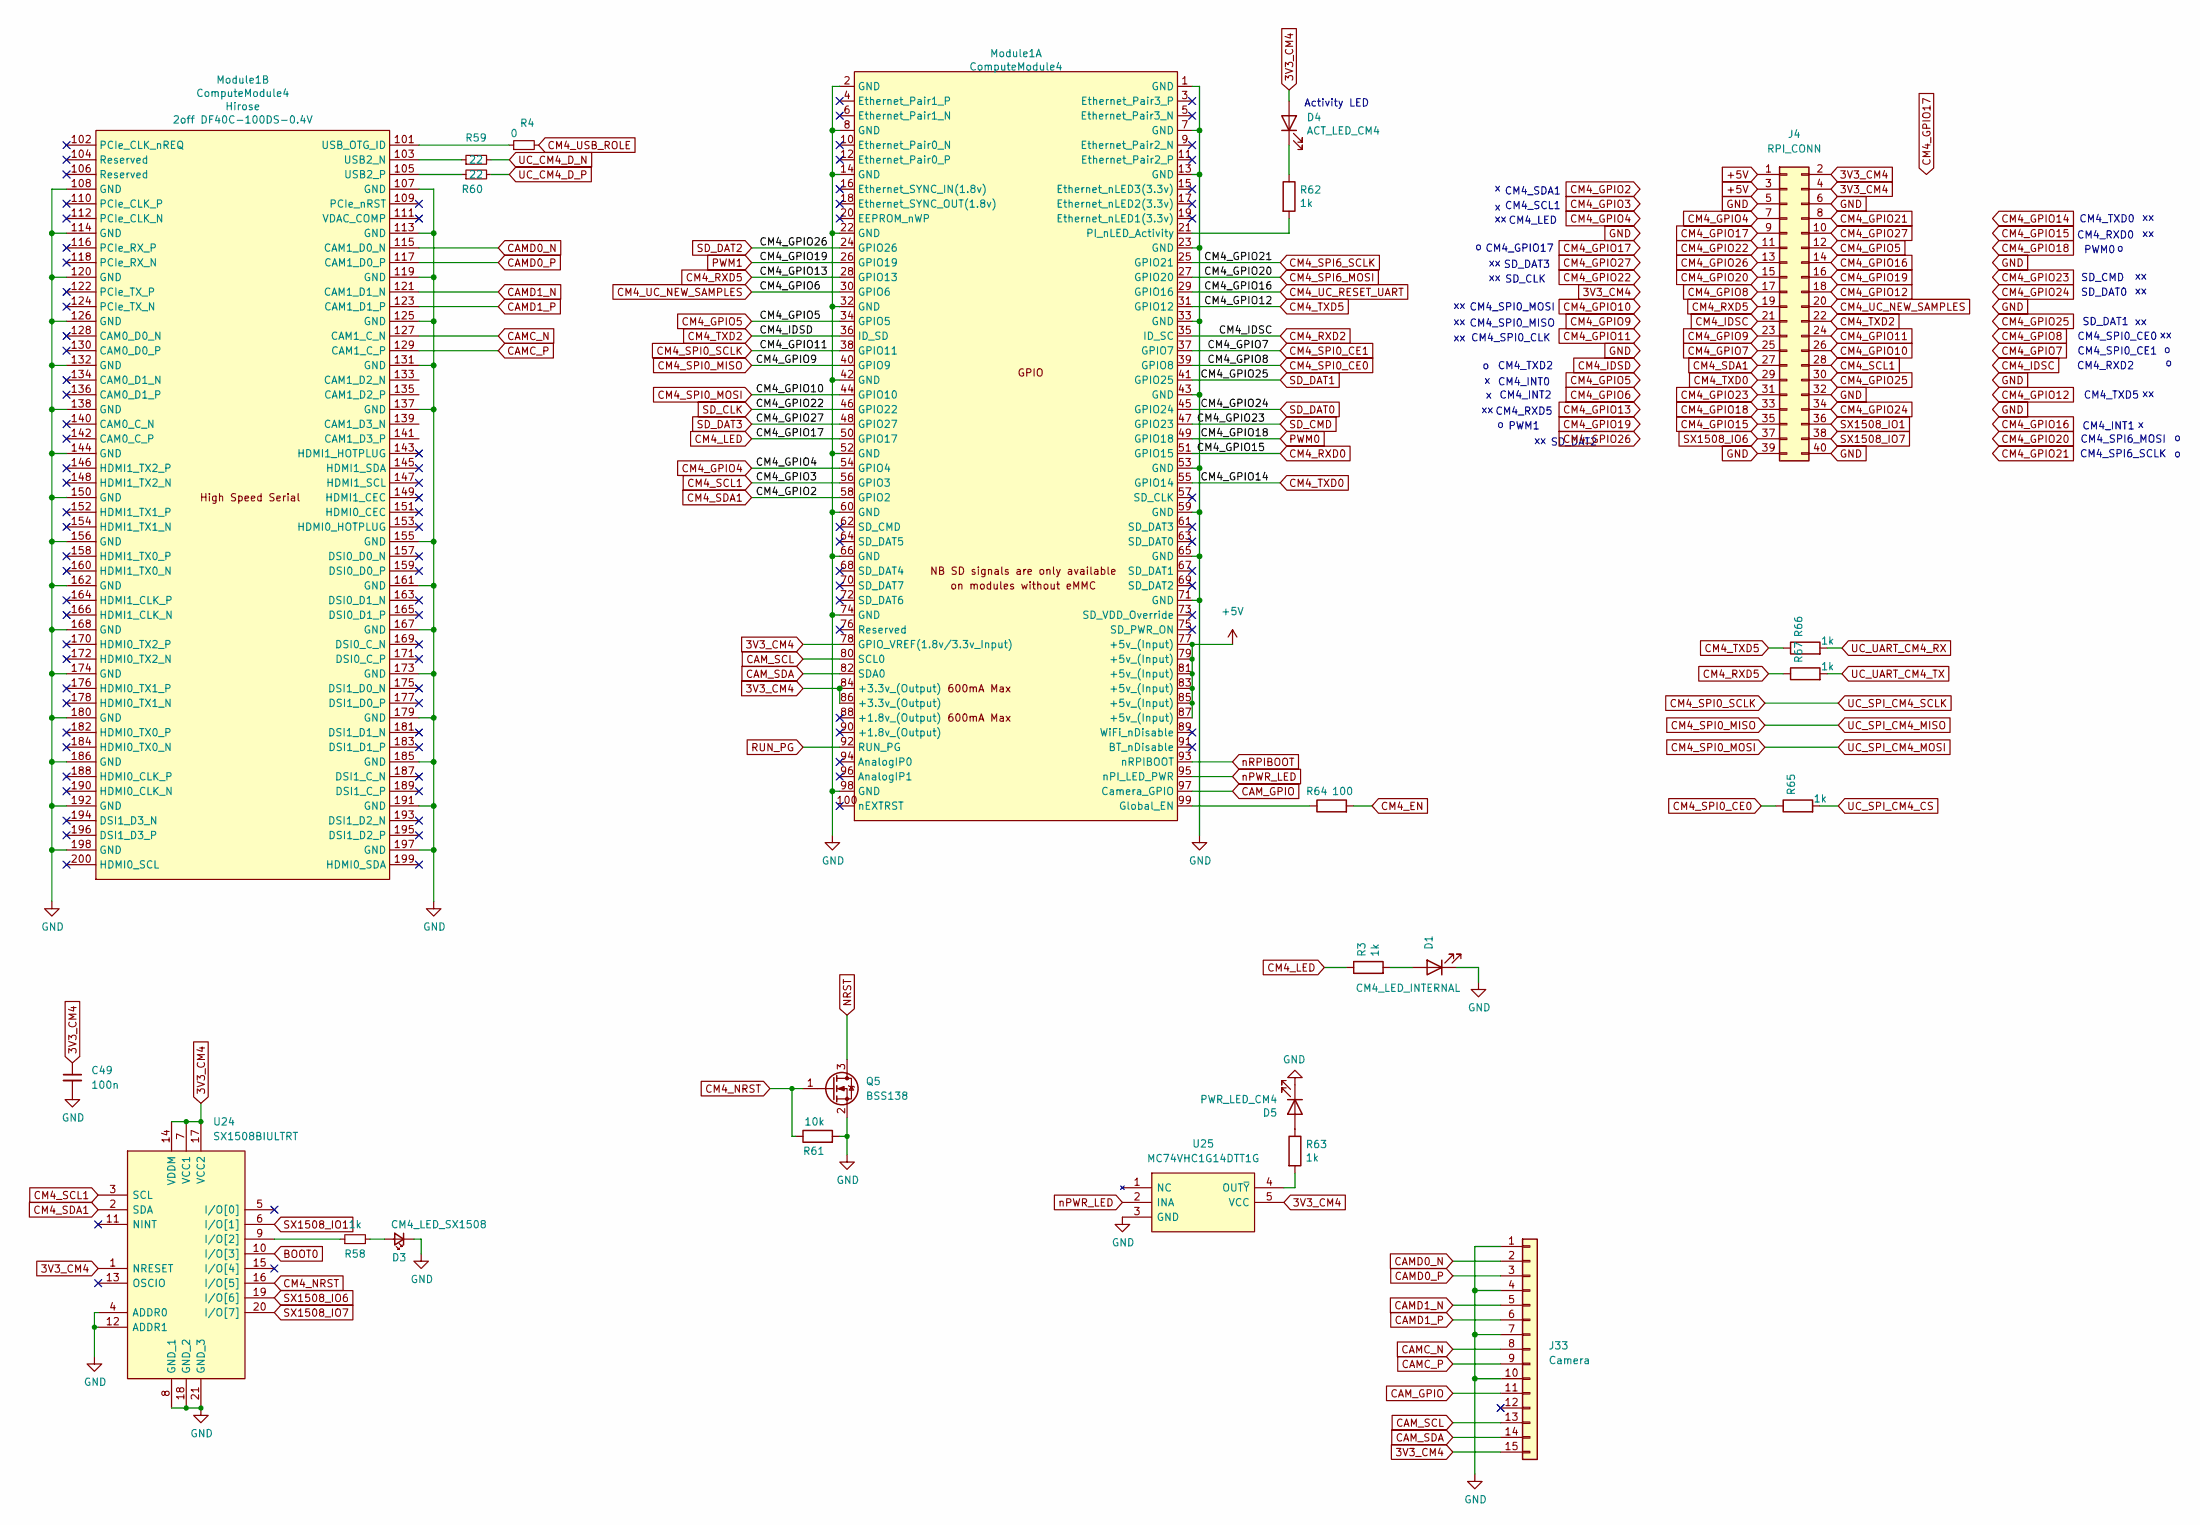
[picture p64: schematic raspberry.kicad_sch]

Parts:
C49: 100n; C_0603_1608Metric
D1: CM4_LED_INTERNAL; LED_0603_1608Metric; Part Description Red 620nm LED Indication - Discrete 2.2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
D3: CM4_LED_SX1508; LED_0603_1608Metric
D4: ACT_LED_CM4; LED_0603_1608Metric; Part Description Green 572nm LED Indication - Discrete 2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
D5: PWR_LED_CM4; LED_0603_1608Metric; Part Description Red 620nm LED Indication - Discrete 2.2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
J4: RPI_CONN; PinHeader_2x20_P2.54mm_Vertical
J33: Camera; 117342485
Module1: ComputeModule4; Raspberry-Pi-4-Compute-Module; Part Description 100 Position Connector Receptacle, Cent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
Q5: BSS138; SOT-323_SC-70
R3, R62, R63, R65, R66, R67: 1k; R_0603_1608Metric; Part Description Resistor 1K M1005 1% 63mW
R4: 0; R_0603_1608Metric
R58: 1k; R_0603_1608Metric
R59, R60: 22; R_0603_1608Metric
R61: 10k; R_0603_1608Metric; Part Description Resistor 1K M1005 1% 63mW
R64: 100; R_0603_1608Metric; Part Description Resistor 1K M1005 1% 63mW
U24: SX1508BIULTRT; QFN40P300X300X60-21N; Mouser Part Number 947-SX1508BIULTRT
U25: MC74VHC1G14DTT1G; SOT95P275X110-5N; Mouser Part Number 863-MC74VHC1G14DTT1G

Connections:
3V3_CM4: C49.1, D4.2 (A), J4.2, J4.4, J33.15, Module1.78 (GPIO_VREF(1.8v/3.3v_Input)), Module1.84 (+3.3v_(Output)), Module1.86 (+3.3v_(Output)), U24.1 (NRESET), U24.7 (VCC1), U24.14 (VDDM), U24.17 (VCC2), U25.5 (VCC)
+5V: J4.1, J4.3, Module1.77 (+5v_(Input)), Module1.79 (+5v_(Input)), Module1.81 (+5v_(Input)), Module1.83 (+5v_(Input)), Module1.85 (+5v_(Input)), Module1.87 (+5v_(Input))
BOOT0: U24.10 (I/O[3])
CAMC_N: J33.8, Module1.127 (CAM1_C_N)
CAMC_P: J33.9, Module1.129 (CAM1_C_P)
CAMD0_N: J33.2, Module1.115 (CAM1_D0_N)
CAMD0_P: J33.3, Module1.117 (CAM1_D0_P)
CAMD1_N: J33.5, Module1.121 (CAM1_D1_N)
CAMD1_P: J33.6, Module1.123 (CAM1_D1_P)
CAM_GPIO: J33.11, Module1.97 (Camera_GPIO)
CAM_SCL: J33.13, Module1.80 (SCL0)
CAM_SDA: J33.14, Module1.82 (SDA0)
CM4_EN: R64.2
CM4_GPIO4: J4.7, Module1.54 (GPIO4)
CM4_GPIO5: J4.12, Module1.34 (GPIO5)
CM4_GPIO7: J4.25
CM4_GPIO8: J4.17
CM4_GPIO9: J4.23
CM4_GPIO10: J4.26
CM4_GPIO11: J4.24
CM4_GPIO12: J4.18
CM4_GPIO15: J4.35
CM4_GPIO16: J4.14
CM4_GPIO17: J4.9
CM4_GPIO18: J4.33
CM4_GPIO19: J4.16
CM4_GPIO20: J4.15
CM4_GPIO21: J4.8
CM4_GPIO22: J4.11
CM4_GPIO23: J4.31
CM4_GPIO24: J4.34
CM4_GPIO25: J4.30
CM4_GPIO26: J4.13
CM4_GPIO27: J4.10
CM4_IDSC: J4.21
CM4_LED: Module1.50 (GPIO17), R3.1
CM4_NRST: Q5.1 (G), R61.1, U24.16 (I/O[5])
CM4_RXD0: Module1.51 (GPIO15)
CM4_RXD2: Module1.35 (ID_SC)
CM4_RXD5: J4.19, Module1.28 (GPIO13), R67.1
CM4_SCL1: J4.28, Module1.56 (GPIO3), U24.3 (SCL)
CM4_SDA1: J4.27, Module1.58 (GPIO2), U24.2 (SDA)
CM4_SPI0_CE0: Module1.39 (GPIO8), R65.1
CM4_SPI0_CE1: Module1.37 (GPIO7)
CM4_SPI0_MISO: Module1.40 (GPIO9)
CM4_SPI0_MOSI: Module1.44 (GPIO10)
CM4_SPI0_SCLK: Module1.38 (GPIO11)
CM4_SPI6_MOSI: Module1.27 (GPIO20)
CM4_SPI6_SCLK: Module1.25 (GPIO21)
CM4_TXD0: J4.29, Module1.55 (GPIO14)
CM4_TXD2: J4.22, Module1.36 (ID_SD)
CM4_TXD5: Module1.31 (GPIO12), R66.1
CM4_UC_NEW_SAMPLES: J4.20, Module1.30 (GPIO6)
CM4_UC_RESET_UART: Module1.29 (GPIO16)
CM4_USB_ROLE: R4.2
GND: C49.2, D1.1 (K), D3.1 (K), D5.1 (K), J4.5, J4.6, J4.32, J4.39, J4.40, J33.1, J33.4, J33.7, J33.10, Module1.1 (GND), Module1.2 (GND), Module1.7 (GND), Module1.8 (GND), Module1.13 (GND), Module1.14 (GND), Module1.22 (GND), Module1.23 (GND), Module1.32 (GND), Module1.33 (GND), Module1.42 (GND), Module1.43 (GND), Module1.52 (GND), Module1.53 (GND), Module1.59 (GND), Module1.60 (GND), Module1.65 (GND), Module1.66 (GND), Module1.71 (GND), Module1.74 (GND), Module1.98 (GND), Module1.107 (GND), Module1.108 (GND), Module1.113 (GND), Module1.114 (GND), Module1.119 (GND), Module1.120 (GND), Module1.125 (GND), Module1.126 (GND), Module1.131 (GND), Module1.132 (GND), Module1.137 (GND), Module1.138 (GND), Module1.144 (GND), Module1.150 (GND), Module1.155 (GND), Module1.156 (GND), Module1.161 (GND), Module1.162 (GND), Module1.167 (GND), Module1.168 (GND), Module1.173 (GND), Module1.174 (GND), Module1.179 (GND), Module1.180 (GND), Module1.185 (GND), Module1.186 (GND), Module1.191 (GND), Module1.192 (GND), Module1.197 (GND), Module1.198 (GND), Q5.2 (S), R61.2, U24.4 (ADDR0), U24.8 (GND_1), U24.12 (ADDR1), U24.18 (GND_2), U24.21 (GND_3), U25.3 (GND)
NRST: Q5.3 (D)
unnamed: D1.2 (A), R3.2
unnamed: D3.2 (A), R58.2
unnamed: D4.1 (K), R62.1
unnamed: D5.2 (A), R63.1
unnamed: Module1.21 (PI_nLED_Activity), R62.2
unnamed: Module1.99 (Global_EN), R64.1
unnamed: Module1.101 (USB_OTG_ID), R4.1
unnamed: Module1.103 (USB2_N), R59.1
unnamed: Module1.105 (USB2_P), R60.1
unnamed: R58.1, U24.9 (I/O[2])
unnamed: R63.2, U25.4 (OUT~Y)
PWM0: Module1.49 (GPIO18)
PWM1: Module1.26 (GPIO19)
RUN_PG: Module1.92 (RUN_PG)
SD_CLK: Module1.46 (GPIO22)
SD_CMD: Module1.47 (GPIO23)
SD_DAT0: Module1.45 (GPIO24)
SD_DAT1: Module1.41 (GPIO25)
SD_DAT2: Module1.24 (GPIO26)
SD_DAT3: Module1.48 (GPIO27)
SX1508_IO1: J4.36, U24.6 (I/O[1])
SX1508_IO6: J4.37, U24.19 (I/O[6])
SX1508_IO7: J4.38, U24.20 (I/O[7])
UC_CM4_D_N: R59.2
UC_CM4_D_P: R60.2
UC_SPI_CM4_CS: R65.2
UC_UART_CM4_RX: R66.2
UC_UART_CM4_TX: R67.2
nPWR_LED: Module1.95 (nPI_LED_PWR), U25.2 (INA)
nRPIBOOT: Module1.93 (nRPIBOOT)

Notes on the sheet:
CM4_RXD5
CM4_INT0
CM4_SDA1
CM4_SPI6_SCLK
CM4_SPI0_CLK
CM4_SPI0_CE1
CM4_SCL1
CM4_SPI0_CE0
SD_CLK
CM4_GPIO17
SD_DAT2
SD_DAT3
Activity LED
SD_DAT0
CM4_RXD2
CM4_RXD0
CM4_TXD2
PWM0
SD_CMD
CM4_SPI0_MISO
CM4_SPI6_MOSI
CM4_TXD5
CM4_TXD0
CM4_LED
SD_DAT1
CM4_SPI0_MOSI
CM4_INT2
PWM1
CM4_INT1
