dustin-lehmann/TWIPR/electronics/control/rev4/robot-hub_rev4/robot-hub_rev4.kicad_sch

## KiCad design electronics/control/rev4/robot-hub_rev4/robot-hub_rev4.kicad_sch (2024-07-17)

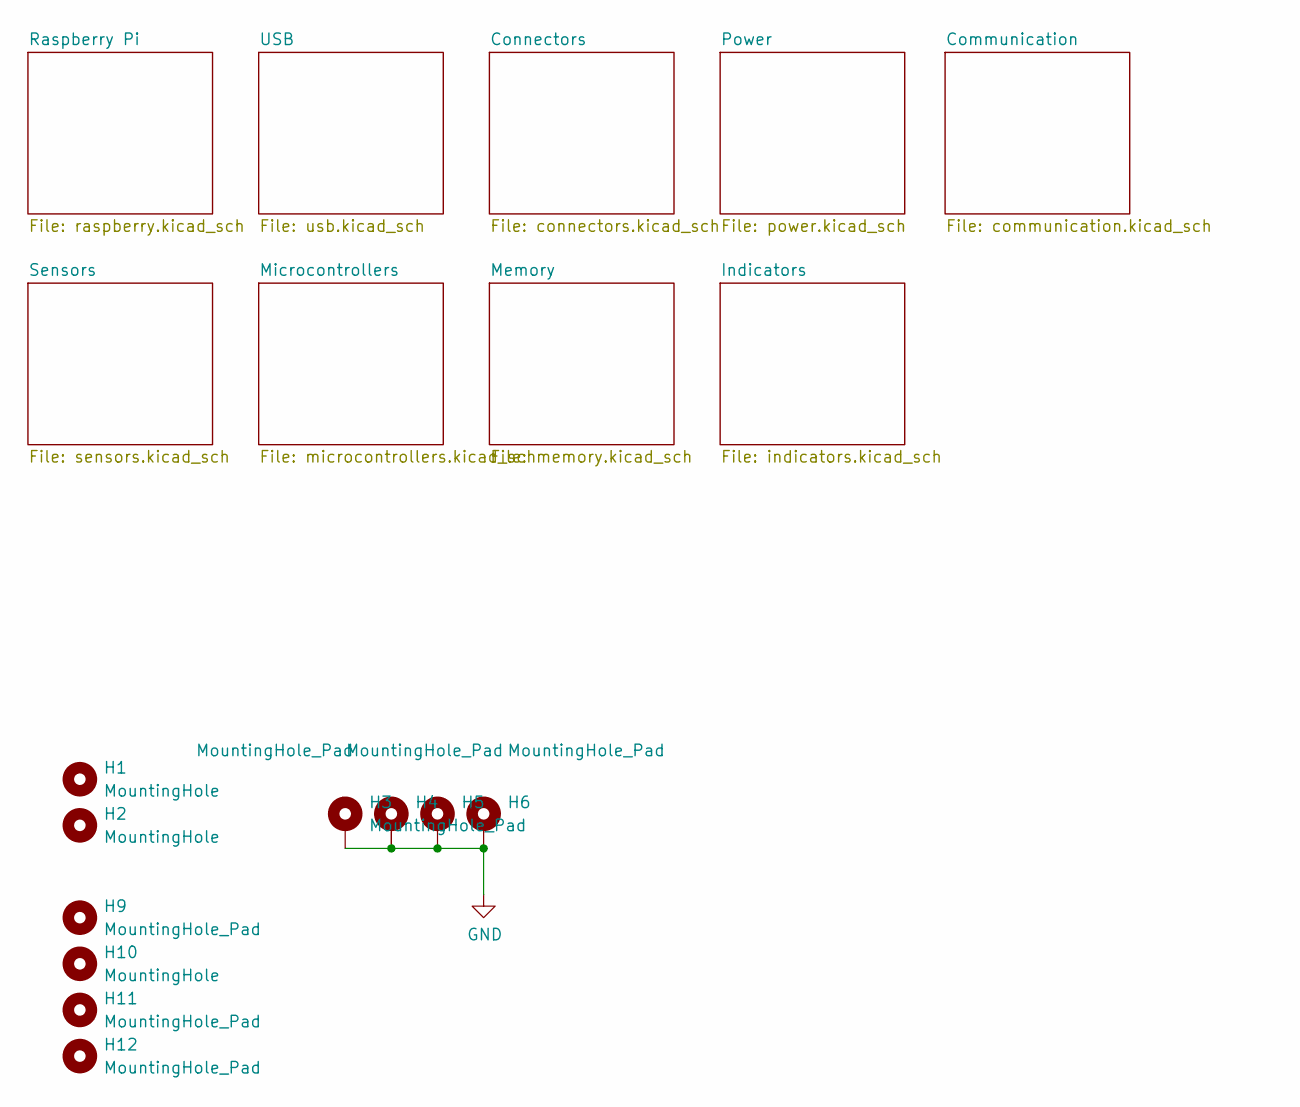
[picture p65: schematic robot-hub_rev4.kicad_sch]

Parts:
H1, H2: MountingHole; WA-SMSI-25
H3, H4, H5, H6: MountingHole_Pad; MountingHole_2.7mm_M2.5_Pad
H9, H11, H12: MountingHole_Pad; MountingHole_2.7mm_M2.5_DIN965
H10: MountingHole; MountingHole_2.7mm_M2.5_DIN965

Connections:
GND: H3.1, H4.1, H5.1, H6.1
