dustin-lehmann/TWIPR/electronics/control/rev4/robot-hub_rev4/sensors.kicad_sch

## KiCad design electronics/control/rev4/robot-hub_rev4/sensors.kicad_sch (2024-07-17)

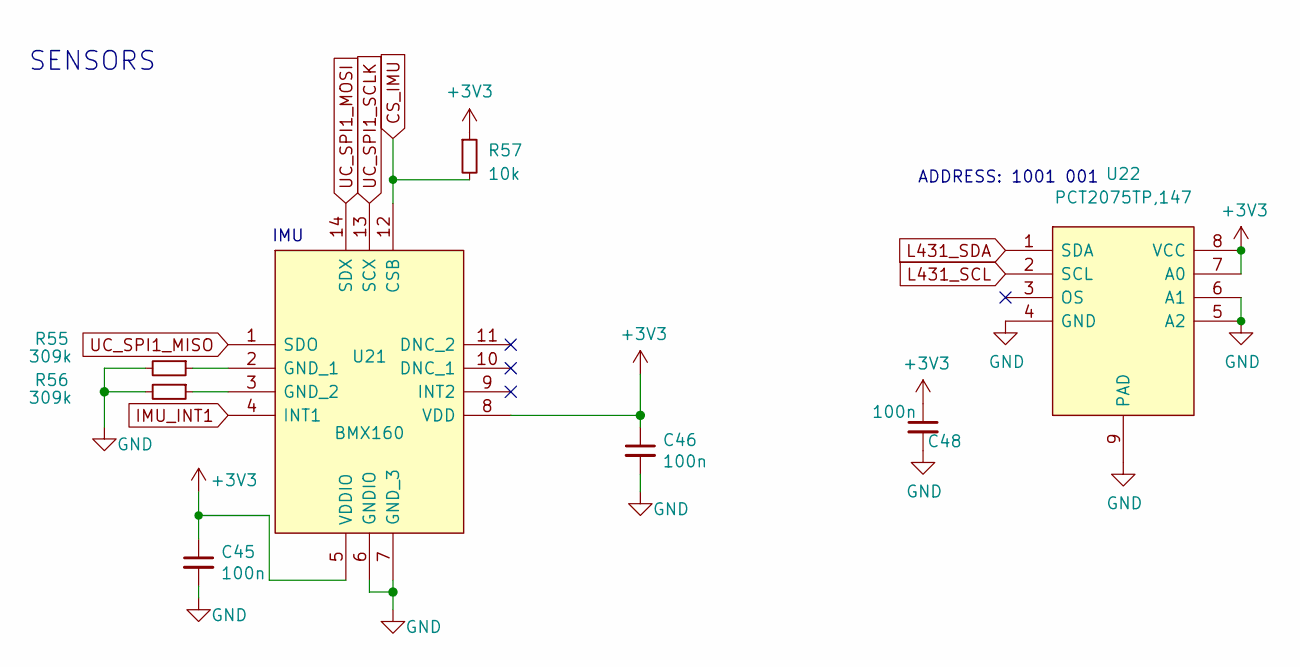
[picture p66: schematic sensors.kicad_sch]

Parts:
C45, C46, C48: 100n; C_0603_1608Metric
R55, R56: 309k; R_0603_1608Metric
R57: 10k; R_0603_1608Metric
U21: BMX160; PQFN50P300X250X88-14N; Mouser Part Number 262-BMX160
U22: PCT2075TP,147; SON50P300X200X80-9N; Mouser Part Number 771-PCT2075TP147

Connections:
+3V3: C45.1, C46.1, C48.1, R57.1, U21.5 (VDDIO), U21.8 (VDD), U22.7 (A0), U22.8 (VCC)
CS_IMU: R57.2, U21.12 (CSB)
GND: C45.2, C46.2, C48.2, R55.2, R56.2, U21.6 (GNDIO), U21.7 (GND_3), U22.4 (GND), U22.5 (A2), U22.6 (A1), U22.9 (PAD)
IMU_INT1: U21.4 (INT1)
L431_SCL: U22.2 (SCL)
L431_SDA: U22.1 (SDA)
unnamed: R55.1, U21.2 (GND_1)
unnamed: R56.1, U21.3 (GND_2)
UC_SPI1_MISO: U21.1 (SDO)
UC_SPI1_MOSI: U21.14 (SDX)
UC_SPI1_SCLK: U21.13 (SCX)

Notes on the sheet:
SENSORS
ADDRESS: 1001 001
IMU
