dustin-lehmann/TWIPR/electronics/control/rev4/robot-hub_rev4/usb.kicad_sch

## KiCad design electronics/control/rev4/robot-hub_rev4/usb.kicad_sch (2024-07-17)

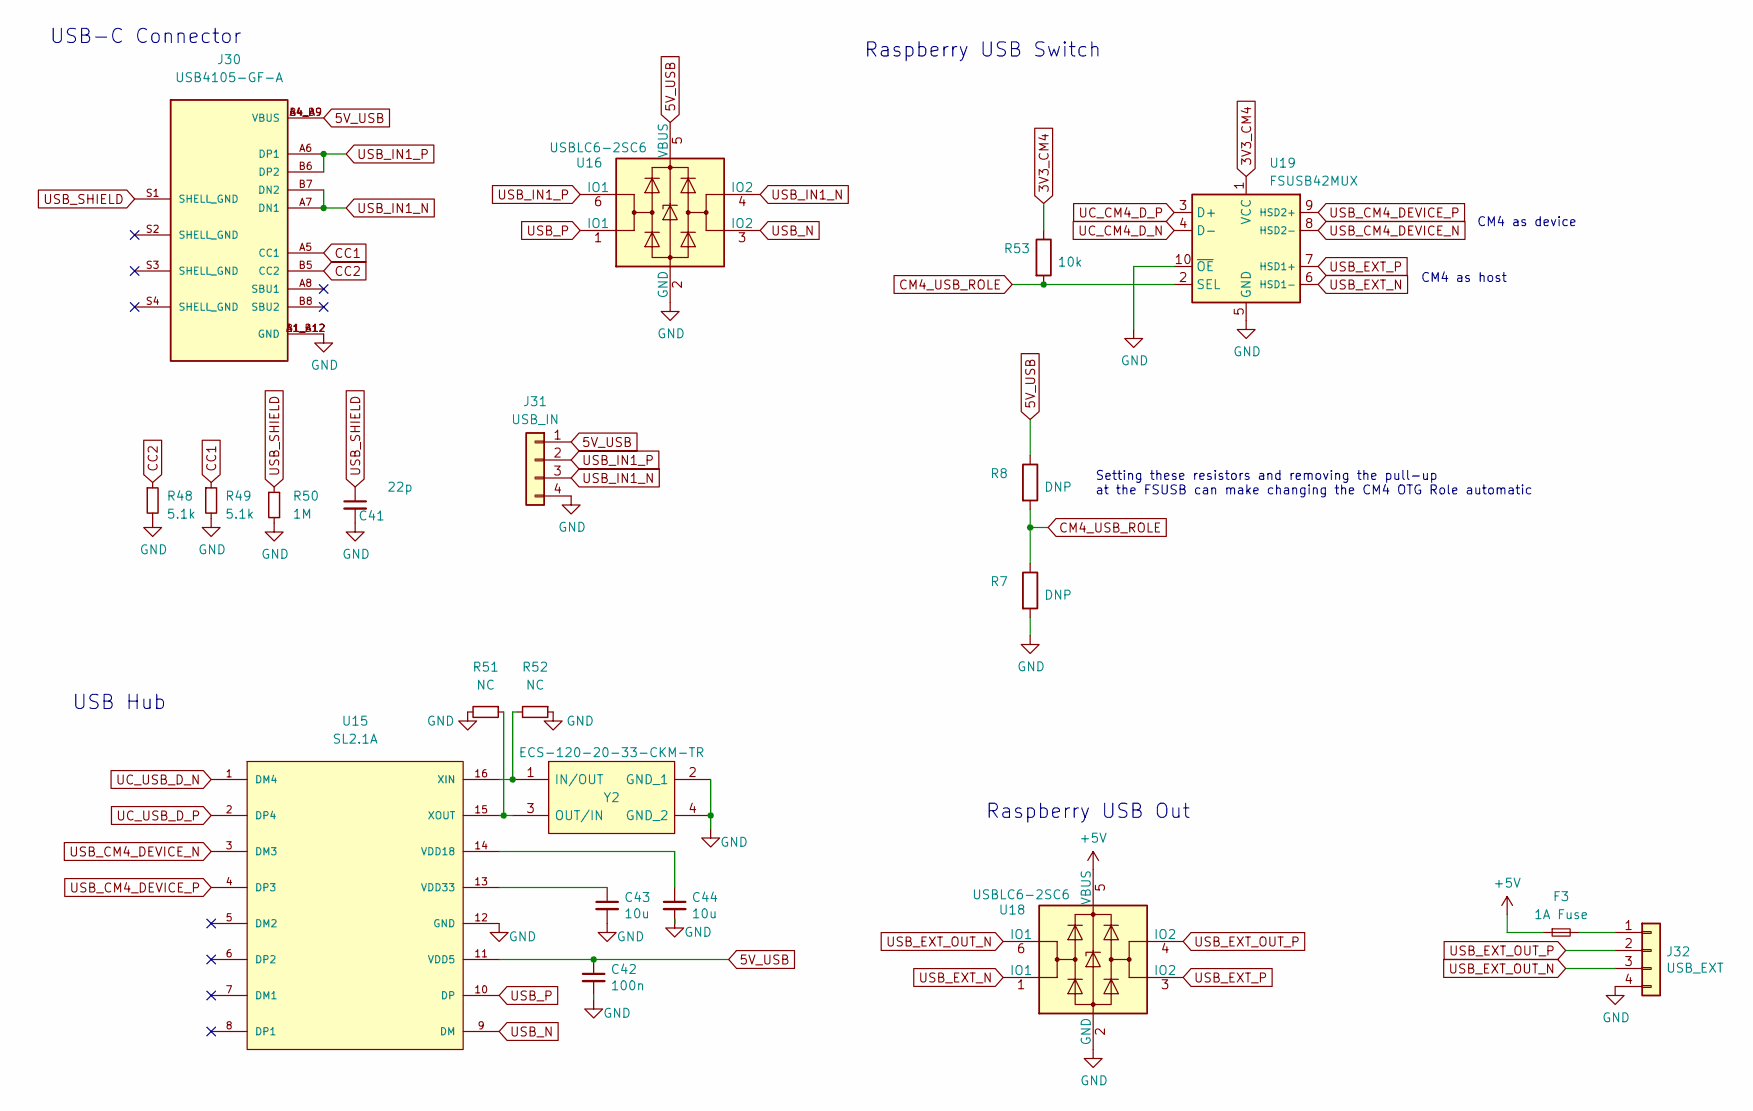
[picture p67: schematic usb.kicad_sch]

Parts:
C41: 22p; C_0603_1608Metric
C42: 100n; C_0805_2012Metric
C43, C44: 10u; C_0805_2012Metric
F3: 1A Fuse; Fuse_1206_3216Metric
J30: USB4105-GF-A; GCT_USB4105-GF-A; PARTREV A3
J31: USB_IN; JST_GH_BM04B-GHS-TBT_1x04-1MP_P1.25mm_Vertical
J32: USB_EXT; JST_GH_BM04B-GHS-TBT_1x04-1MP_P1.25mm_Vertical
R7, R8: DNP; R_0603_1608Metric; Part Description Resistor 2.2K M1005 1% 63mW
R48, R49: 5.1k; R_0603_1608Metric
R50: 1M; R_0603_1608Metric
R51, R52: NC; R_0603_1608Metric
R53: 10k; R_0603_1608Metric; Part Description Resistor 2.2K M1005 1% 63mW
U15: SL2.1A; SO-16_3.9x9.9mm_P1.27mm
U16, U18: USBLC6-2SC6; SOT-23-6
U19: FSUSB42MUX; MSOP-10_3x3mm_P0.5mm
Y2: ECS-120-20-33-CKM-TR; ECS1202033CKMTR; Mouser Part Number 520-120-20-33-CKMT

Connections:
3V3_CM4: R53.1, U19.1 (VCC)
5V_USB: C42.1, J30.A4_B9 (VBUS), J30.B4_A9 (VBUS), J31.1, R8.1, U15.11 (VDD5), U16.5 (VBUS)
+5V: F3.1, U18.5 (VBUS)
CC1: J30.A5 (CC1), R49.1
CC2: J30.B5 (CC2), R48.1
CM4_USB_ROLE: R7.1, R8.2, R53.2, U19.2 (SEL)
GND: C41.2, C42.2, C43.2, C44.2, J30.A1_B12 (GND), J30.B1_A12 (GND), J31.4, J32.4, R7.2, R48.2, R49.2, R50.2, R51.2, R52.1, U15.12 (GND), U16.2 (GND), U18.2 (GND), U19.5 (GND), U19.10 (~OE), Y2.2 (GND_1), Y2.4 (GND_2)
unnamed: C43.1, U15.13 (VDD33)
unnamed: C44.1, U15.14 (VDD18)
unnamed: F3.2, J32.1
unnamed: R51.1, U15.15 (XOUT), Y2.3 (OUT/IN)
unnamed: R52.2, U15.16 (XIN), Y2.1 (IN/OUT)
UC_CM4_D_N: U19.4 (D-)
UC_CM4_D_P: U19.3 (D+)
UC_USB_D_N: U15.1 (DM4)
UC_USB_D_P: U15.2 (DP4)
USB_CM4_DEVICE_N: U15.3 (DM3), U19.8 (HSD2-)
USB_CM4_DEVICE_P: U15.4 (DP3), U19.9 (HSD2+)
USB_EXT_N: U18.1 (IO1), U19.6 (HSD1-)
USB_EXT_OUT_N: J32.3, U18.6 (IO1)
USB_EXT_OUT_P: J32.2, U18.4 (IO2)
USB_EXT_P: U18.3 (IO2), U19.7 (HSD1+)
USB_IN1_N: J30.A7 (DN1), J30.B7 (DN2), J31.3, U16.4 (IO2)
USB_IN1_P: J30.A6 (DP1), J30.B6 (DP2), J31.2, U16.6 (IO1)
USB_N: U15.9 (DM), U16.3 (IO2)
USB_P: U15.10 (DP), U16.1 (IO1)
USB_SHIELD: C41.1, J30.S1 (SHELL_GND), R50.1

Notes on the sheet:
Raspberry USB Switch
USB-C Connector
Raspberry USB Out
CM4 as device
Setting these resistors and removing the pull-up at the FSUSB can make changing the CM4 OTG Role automatic
USB Hub
CM4 as host
