dustin-lehmann/TWIPR/software/robot/firmware/boards/bms/BMS_v3/Core/Src/main.c

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
/* Includes ------------------------------------------------------------------*/
#include "main.h"


void SystemClock_Config(void);
static void MX_GPIO_Init(void);
/**
  * @brief  The application entry point.
  * @retval int
  */
int main(void)
{
  /* MCU Configuration--------------------------------------------------------*/

  /* Reset of all peripherals, Initializes the Flash interface and the Systick. */
  HAL_Init();

  /* Configure the system clock */
  SystemClock_Config();

  /* Initialize all configured peripherals */
  MX_GPIO_Init();
  /* USER CODE BEGIN 2 */

  HAL_Delay(250);
  // Set all Outputs to ON


//  HAL_GPIO_TogglePin(LED_LOW_GPIO_Port, LED_LOW_Pin);
  /* USER CODE END 2 */

  /* Infinite loop */
  /* USER CODE BEGIN WHILE */
  while (1)
  {
    /* USER CODE END WHILE */

    /* USER CODE BEGIN 3 */
	  HAL_GPIO_WritePin(OUT_4_GPIO_Port, OUT_4_Pin, 1);

	  if (HAL_GPIO_ReadPin(DETECT_CHG_GPIO_Port, DETECT_CHG_Pin)) {
		  HAL_GPIO_WritePin(OUT_1_GPIO_Port, OUT_1_Pin, 1);
		  HAL_GPIO_WritePin(OUT_2_GPIO_Port, OUT_2_Pin, 1);
		  HAL_GPIO_WritePin(OUT_4_GPIO_Port, OUT_3_Pin, 1);
	  } else {
		  HAL_GPIO_WritePin(OUT_1_GPIO_Port, OUT_1_Pin, 0);
		  HAL_GPIO_WritePin(OUT_2_GPIO_Port, OUT_2_Pin, 0);
		  HAL_GPIO_WritePin(OUT_4_GPIO_Port, OUT_3_Pin, 0);
	  }

	  HAL_GPIO_TogglePin(LED_USER_GPIO_Port, LED_USER_Pin);

	  HAL_Delay(250);
  }
  /* USER CODE END 3 */
}

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
