dustin-lehmann/TWIPR/software/robot/firmware/stm32-mcu-projects/twipr_firmware_project_rev4/twipr_firmware_project_rev4.ioc

Mcu.UserName=STM32H743VITx
PA0.GPIO_Label=BUTTON_LED_1
PA0.Signal=GPIO_Output
PA1.GPIO_Label=BUTTON_LED_2
PA1.Signal=GPIO_Output
PA10.Signal=USART1_RX
PA2.Signal=USART2_TX
PA3.Signal=USART2_RX
PA4.Signal=SPI1_NSS
PA5.Signal=SPI1_SCK
PA6.Signal=SPI1_MISO
PA7.Signal=SPI1_MOSI
PA8.Signal=I2C3_SCL
PA9.Signal=USART1_TX
PB12.GPIO_Label=CS_IMU
PB12.Signal=GPIO_Output
PB13.Signal=SPI2_SCK
PB14.Signal=SPI2_MISO
PB15.Signal=SPI2_MOSI
PB2.Signal=GPXTI2
PB5.Signal=S_TIM3_CH2
PB6.Signal=S_TIM4_CH1
PB7.Signal=S_TIM4_CH2
PC0.GPIO_Label=SIDE_BUTTON_2
PC0.Signal=GPIO_Input
PC1.GPIO_Label=SIDE_BUTTON_1
PC1.Signal=GPIO_Input
PC2_C.Signal=GPIO_Output
PC3_C.Signal=GPIO_Output
PC9.Signal=I2C3_SDA
PD0.Signal=FDCAN1_RX
PD1.Signal=FDCAN1_TX
PD11.GPIO_Label=LED_ACT
PD11.Signal=GPIO_Output
PD15.GPIO_Label=RS485_EN
PD15.Signal=GPIO_Output
PD7.Signal=GPIO_Output
PD8.Signal=GPIO_Output
PD9.Signal=GPIO_Output
PE0.Signal=UART8_RX
PE1.Signal=UART8_TX
PE10.GPIO_Label=LED2
PE10.Signal=GPIO_Output
PE15.GPIO_Label=LED1
PE15.Signal=GPIO_Output
PE4.Signal=GPIO_Input
PE5.Signal=S_TIM15_CH1
PE8.Signal=GPIO_Output
PE9.Signal=GPIO_Output
