dustin-lehmann/TWIPR/software/robot/firmware/boards/bms/BMS_v3/Core/Inc/main.h

#define ENABLE_MEAS_1_Pin GPIO_PIN_1
#define ENABLE_MEAS_1_GPIO_Port GPIOA
#define ADC_CELL_3_Pin GPIO_PIN_4
#define ADC_CELL_3_GPIO_Port GPIOA
#define ENABLE_MEAS_3_Pin GPIO_PIN_5
#define ENABLE_MEAS_3_GPIO_Port GPIOA
#define DETECT_CHG_Pin GPIO_PIN_6
#define DETECT_CHG_GPIO_Port GPIOA
#define ADC_CELL_4_Pin GPIO_PIN_0
#define ADC_CELL_4_GPIO_Port GPIOB
#define ENABLE_MEAS_4_Pin GPIO_PIN_1
#define ENABLE_MEAS_4_GPIO_Port GPIOB
#define LED_USER_Pin GPIO_PIN_11
#define LED_USER_GPIO_Port GPIOA
#define OUT_2_Pin GPIO_PIN_3
#define OUT_2_GPIO_Port GPIOB
#define OUT_1_Pin GPIO_PIN_5
#define OUT_1_GPIO_Port GPIOB
#define OUT_3_Pin GPIO_PIN_6
#define OUT_3_GPIO_Port GPIOB
#define OUT_4_Pin GPIO_PIN_7
#define OUT_4_GPIO_Port GPIOB
