dustin-lehmann/TWIPR/software/robot/firmware/boards/control-board/RC_v4_BoardExtender/firmware/firmware_c.h

/*
 * firmware_c.h
 *
 *  Created on: Jul 10, 2022
 *      Author: Dustin Lehmann
 */

#ifndef FIRMWARE_C_H_
#define FIRMWARE_C_H_


void firmware_init();
void firmware_update();


#endif /* FIRMWARE_C_H_ */
