dustin-lehmann/TWIPR/software/robot/software/TWIPR-Software/control_board/utils.py

from RPi import GPIO
import control_board.settings as board_settings


def reset_uart(pin):
    print("RESET UART")
    GPIO.setmode(GPIO.BCM)
    GPIO.setup(pin, GPIO.OUT)
    GPIO.output(pin, 1)
    GPIO.output(pin, 0)
    GPIO.cleanup()
