dustin-lehmann/TWIPR/(commit log)

2024-02-12 - added CAD model of TWIPR
    [BMS_holder.SLDPRT, MC-4-15.STEP, RMD-4015.SLDPRT, SKF_W_637_8_2Z.sldasm, SKF_W_637_8_2Z_16.sldprt, SKF_W_637_8_2Z_29.sldprt, SKF_W_637_8_2Z_31.sldprt, T81H-RM41.stp.SLDPRT]
2024-05-09 - updated to newest version of robot
    [BMS_holder.SLDPRT, MC-4-15.STEP, RMD-4015.SLDPRT, SKF_W_637_8_2Z.sldasm, SKF_W_637_8_2Z_16.sldprt, SKF_W_637_8_2Z_29.sldprt, SKF_W_637_8_2Z_31.sldprt, T81H-RM41.stp.SLDPRT]
2024-05-09 - added bumper.SLDPRT
    [bumper.SLDPRT]
2024-05-14 Reinforced Cover
    [cover_1.SLDPRT, cover_2.SLDPRT]
2024-05-14 Improved bat compartment, LED mount on braces
    The compartment holds the battery in place without foam
    [bat_compartment.SLDPRT, brace_back.SLDPRT, brace_front.SLDPRT]
2024-05-15 - added TWIPR firmware
    [brace_left_display.SLDPRT, brace_left_display_large.SLDPRT, brace_right.SLDPRT]
2024-05-24 Add files via upload
    right brace adapted to new size of motor shaft
    [brace_right.SLDPRT]
2024-07-05 renamed files
    [v1_BMS_holder.SLDPRT, v1_bat_compartment.SLDPRT, v1_bat_compartment_lid.SLDPRT, v1_brace_back.SLDPRT, v1_brace_front.SLDPRT, v1_brace_left.SLDPRT, v1_brace_left_display.SLDPRT, v1_brace_right.SLDPRT]
2024-07-17 added control PCBs
    [communication.kicad_sch, connectors.kicad_sch, connectors_1.kicad_sch, indicators.kicad_sch, memory.kicad_sch, microcontrollers.kicad_sch, power.kicad_sch, raspberry.kicad_sch]
2024-11-11 - renamed individual projects for more consistency - consolidated projects for better comprehensibility
    [body.SLDPRT, export_robot.SLDASM, robot_base.SLDASM, top.SLDPRT, track.SLDPRT, wheel.SLDPRT]
