dustin-lehmann/TWIPR/(notices)

Notices in the files:
software/robot/firmware/boards/bms/BMS_v3/Core/Src/main.c:
Copyright (c) 2022 STMicroelectronics.
All rights reserved.
This software is licensed under terms that can be found in the LICENSE file
